Oleg-mk/MOST25-to-AUDIO/kit/1_boards/README.md

# Плати v2.0: замовлення, деталі, труба, монтаж

| Файл | Що це |
|---|---|
| `most_listener_v2-gerbers.zip` | сама плата для фабрики: Gerber-файли, свердління, файл задачі |
| `most_listener_v2-bom-jlcpcb-min.csv`, `most_listener_v2-cpl-jlcpcb-min.csv` | збірка min: перелік деталей для монтажу в JLCPCB з номерами LCSC і їхнє розміщення з поворотами JLCPCB |
| `most_listener_v2-bom-jlcpcb-mid.csv`, `most_listener_v2-cpl-jlcpcb-mid.csv` | збірка mid: те саме |
| `most_listener_v2-bom-jlcpcb-max.csv`, `most_listener_v2-cpl-jlcpcb-max.csv` | збірка max: те саме |
| `most_listener_v2-bom.csv` | повний перелік деталей (збірка max), разом із ручними |
| `most_listener_v2-schematic.pdf` | схема |
| `most_listener_v2-assembly-top.pdf`, `most_listener_v2-assembly-bottom.pdf` | обидва боки для монтажу (нижній — як його видно знизу): позначення всіх деталей, і тих, яких не видно на шовкографії, знаки полярності, контур |
| `caps/in_cap.stl`, `caps/in_cap.step` | вхідна кришка труби (J1, J5, J4, micro-USB модуля M2, SMA антени), для друку |
| `caps/out_cap.stl`, `caps/out_cap.step` | вихідна кришка (J6 і гнізда RCA J7..J9), для друку |
| `caps/caps.svg` | креслення обох кришок: вигляд ззовні, розріз, вигляд знизу, розміри, примітки |

Ці файли — копії з `listener_hw2/fab` і `listener_hw2/caps`. Їх пишуть `listener_hw2/make_fab2.py` з
плати KiCad і `listener_hw2/gen_caps.py` з моделі плати в трубі (`listener_hw2/check_fit.py`), руками
не правити.

## Плата

- 98 x 60 мм, 4 шари, FR-4 1.6 мм, ревізія 2.0. JLCPCB покаже 98.1 x 60.1 мм, бо рахує контур разом
  із товщиною лінії.
- Стек JLCPCB JLC04161H-7628: мідь 1 oz зовні й 0.5 oz усередині. Обидва внутрішні шари — суцільна
  земля.
- Доріжки від 0.2 мм, зазор 0.15 мм, переходи 0.6/0.3 мм, найменший отвір 0.3 мм, вирізів немає.
- SMD-деталі, маска й шовкографія з обох боків.
- Покриття ENIG, бо плоских площадок потребують U4 і U11 (VSSOP-8, крок 0.5 мм), U5 (WSON-6) і U6
  (HSOP-8).

## Три збірки

Плата одна і корпус один: роз'єми ставляться в кожній збірці, різняться лише деталі за ними.
Прошивки для всіх трьох ті самі.

| Збірка | Що працює | Деталей ставить JLCPCB | Рядків BOM |
|---|---|---|---|
| **min** | ядро і виходи S/PDIF: J6 (оптика) і J7 (коаксіальний) | 103 (44 зверху, 59 знизу) | 42 |
| **mid** | min і лінійний вихід J8, J9 | 143 (44 зверху, 99 знизу) | 52 |
| **max** | mid і вхід TOSLINK J5 | 163 (57 зверху, 106 знизу) | 58 |

Ядро — це живлення, кільце з обходом і сторожем, M1 (FPGA), U7 (Si514), M2 (хост, Bluetooth), J3
(I2S) і J2 (аналізатор). У min J5, J8 і J9 стоять, але не підключені: J5 без живлення, J8 і J9 без
сигналу. У mid так само не підключений J5.

## Замовлення на JLCPCB

1. **Плата.** Завантажити `most_listener_v2-gerbers.zip`. Вибрати: 4 шари, 1.6 мм, стек
   JLC04161H-7628, мідь 1 oz зовні й 0.5 oz усередині, ENIG, зелена маска, білий друк, від 5 штук.
2. **Монтаж.** Обидва боки, Standard PCBA (Economic монтує лише один бік), «Confirm parts placement»
   увімкнути.
3. **BOM і CPL.** Завантажити пару файлів потрібної збірки:
   `most_listener_v2-bom-jlcpcb-<збірка>.csv` і `most_listener_v2-cpl-jlcpcb-<збірка>.csv`.
   - JLCPCB одразу покаже наявність. Якої деталі не вистачає, ту докупити з LCSC на тій самій
     сторінці (F1, C2925010).
   - У max, якщо в LCSC бракує U13 (SRC4192), дати свої.
4. **Своя деталь: U7, Si514.** Переслати в JLCPCB або додати через їхній global sourcing.
   - Підходить будь-який варіант 3.3 В CMOS (формат C, M або N) у корпусі 3.2 x 5 (B) або
     2.5 x 3.2 (C), з будь-якою стартовою частотою й адресою I2C. FPGA сама знаходить адресу й
     ставить частоту.
   - Приклад: 514CBB000112BAG: DigiKey продає його поштучно, а JLCPCB може замовити сам (C1670489).
5. **Перегляд розміщення перед оплатою**, на обох боках. Перевірити:
   - першу ніжку кожної мікросхеми й X1;
   - полярність D1, D2, D3, C44, C45, C63, C78 і C81 (тих, що є у вибраній збірці).

   Повороти взято з посадок LCSC кожної вибраної деталі. Нижній бік JLCPCB рахує дзеркально: 180°
   мінус кут у KiCad плюс поворот самої деталі. Крапка першої ніжки має стояти на позначці першої
   ніжки плати, а «+» кожного електроліта — на боці «+» шовкографії. U7 посадки LCSC не має, JLCPCB
   малює свою: її першу ніжку звірити з позначкою на платі.

## Деталі для ручного монтажу

На одну плату:

| Позиція | Деталь | Номер | Де купити |
|---|---|---|---|
| J1 | оптичний модуль MOST (pigtail FOT, 2+0) | TE 1-1394640-1 | у каталогах Mouser і DigiKey не знайдено, лише маркетплейси: шукати заздалегідь |
| J2 | гребінка 1x08, крок 2.54 мм (TDM і UART назовні) | — | будь-де |
| J3 | гребінка 1x06, крок 2.54 мм (I2S назовні) | — | будь-де |
| J4 | Micro-Fit 3.0, 2 контакти, кутовий | Molex 43650-0200 | будь-який дистриб'ютор Molex |
| J5 | приймач TOSLINK (вхід) | Cliff FCR684208R (ORJ-8) | DigiKey, у LCSC немає |
| J6 | передавач TOSLINK (вихід S/PDIF) | Cliff FCR684208T (OTJ-8) | DigiKey |
| J7, J8, J9 | гніздо RCA, кутове: J7 коаксіальний S/PDIF, J8 і J9 лінійний вихід L і R | BKL Electronic 0101153 | дистриб'ютори BKL |
| M1 | модуль FPGA | Sipeed Tang Nano 20K | магазин Sipeed |
| M2 | модуль ESP32 з роз'ємом зовнішньої антени | Espressif ESP32-DevKitC-VIE | дистриб'ютори Espressif |
| — | гребінки для модулів: 2 шт. 1x20 (M1) і 2 шт. 1x19 (M2), крок 2.54 мм | — | будь-де |

Отвори зроблено саме під ці деталі, схожі можуть не стати.

J2 і J3 — для стола: у трубі над платою лишається 14.75 мм, а колодка 2.54 стоїть на 16.4 мм.

## Труба і кришки

- **Труба.** Алюмінієва прямокутна 80x30x2 (76 x 26 мм усередині). Довжина дорівнює виміряній
  зібраній платі від вхідного краю до найдальшого з вихідного краю й передніх граней RCA
  (номінально 98.05 мм), +0.1/−0 мм. Торці рівні й без задирок. Краще без покриття: анодування
  ізолює, а трубу з'єднуємо з землею (нижче).
- **Кришки** друкуються з `caps/`: STL для слайсера, STEP для CAD, креслення в `caps/caps.svg`.
  Матеріал PETG або ASA (PLA у машині на сонці м'якне), або замовити друк MJF PA12. Друкувати
  зовнішньою гранню на стіл, без підтримок, із заповненням 100 %: саморізи вкручуються в тіло
  блоків. Обидві разом — близько 23 г PETG.
- **Будова.** Кожна кришка — фланець 80x30, 2.0 мм, що лягає на торець труби. Плата впирається
  торцями у фланці. Блоки в бічних запасах (по 8 мм обабіч плати) тримають її краї в пазах 2.0 мм.
  До стінок труби блоки не доходять на 0.7 мм, тож підходить будь-яка труба в допуску, без вимірів.
  - Вхідна кришка: корпус J1 проходить крізь неї, J5 і J4 мають одне спільне вікно, знизу вікно на
    micro-USB модуля M2 (з місцем під литий корпус вилки), SMA антени — у бічному запасі з боку
    J4, над платою.
  - Вихідна кришка: вікно J6 і три вертикальні прорізи 13.2 x 13.8 під різьбу RCA (висоти осі
    гнізда BKL не дає, проріз покриває її розкид).
- **Сідла й вуха.** Знизу кожен фланець переходить у сідло під трубою: 3 мм завтовшки, 9 мм уздовж
  труби, з вухом по 10 мм з кожного боку й отвором Ø4.6. Труба лежить дном на двох сідлах. Слухача
  в машині кріплять чотири саморізи 4.2 мм (DIN 7981) або гвинти M4 крізь вуха, під кожну голову
  шайба DIN 125 M4.
- **Кріплення кришок:** чотири саморізи DIN 7981 C ST2.2x9.5 крізь верх труби. Отвори Ø2.4 у
  верхній стінці, 3.0 мм від торця, на відстані u від лівого краю, якщо дивитися ззовні на той
  торець:
  - вхідна: u 6.20 (лівий блок) і u 64.90 (блок землі, над J4);
  - вихідна: u 6.20 (лівий блок) і u 73.80 (правий блок).

  Не крізь бічні стінки: голова саморіза там заважала б викрутці на вусі під нею.
- **Земля труби.** Під голову саморіза блоку землі (вхідна кришка, над J4) покласти кільцевий
  наконечник M2 і зубчасту шайбу. Від наконечника провід 3–5 см до мінусового проводу джгута J4 біля
  самої колодки (пайка, термоусадка). Анодовану трубу під шайбою зачистити до металу.
- **Антена.** Пігтейл U.FL–SMA 150 мм з гніздом SMA під гайку 8 мм (фланцеве чи з ущільнювачем,
  11 мм, у бічний запас не влазить). Отвір у кришці круглий, Ø6.85, тож підходить різьба і з
  лисками, і без. Гайка й зубчаста шайба гнізда — зовні. Антену 2.4 ГГц брати з тим самим різновидом
  роз'єму, що й гніздо пігтейла: SMA або RP-SMA.

## Що ще потрібно, крім плати

- **Живлення J4.** Корпус Molex 43645-0200 і два контакти 43030 (провід 20–24 AWG).
  - Живити від постійного «плюса» акумулятора (KL30) і маси.
  - Без живлення обхід не працює, і кільце машини розірване: на 3.3 В, що є завжди, працює саме
    шлях оптики через плату.
  - Біля точки підключення до проводки машини поставити свій запобіжник. F1 на платі (2 А)
    захищає лише те, що за ним, а не провід.
- **Вставка в кільце MOST.** Кабель, що розриває кільце біля одного з вузлів і заводить його на J1.
  Номера в репозиторії немає. Такі кабелі роблять Kufatec, Dension, Trioma; підбирати під свій
  вузол. Для телефона в машину цей вузол — підсилювач: слухач має стояти на волокні, що йде в
  нього.
- **Антена для M2** з пігтейлом, за розділом вище. У модуля VIE антени на платі немає, без
  зовнішньої не буде Bluetooth.
- **Труба, кришки й дрібниці** за розділом вище: чотири саморізи ST2.2x9.5, кільцевий наконечник
  M2, зубчаста шайба M2, 3–5 см проводу 20–22 AWG; для машини — чотири саморізи 4.2 мм або гвинти
  M4 і шайби M4.
- **Кабелі за потребою:**
  - TOSLINK на J5 (вхід) і J6 (вихід);
  - коаксіальний 75 Ом на J7;
  - звичайні RCA на J8 і J9.
- **Для стола** потрібне світло в J1: живе кільце машини або інша плата MOST. Інакше сигнал WAKE не
  вмикає 5V_SW, і модулі не мають живлення від плати.

## Монтаж

1. **Прошивки.** Перед запаюванням записати прошивки в обидва модулі, кожен через його власний
   USB, без плати (`2_flash/README.md`). USB-C модуля FPGA потім закриють корпуси J8 і J9.
2. **Гребінки модулів.** На платі є отвори лише під ніжки, що працюють, і під кутові, що тримають
   модуль. Тож гребінку прикласти до її ряду отворів і витягнути плоскогубцями ті штирі, під якими
   отвору немає. За номерами ніжок модуля, від квадратної площадки 1:
   - M1: 4, 6, 7, 11, 15, 16, 17, 18 в одному ряду; 24, 29, 34, 36 в іншому;
   - M2: 2–10, 12, 13, 16, 17, 18 в одному ряду; 23, 24, 27–31, 33, 34, 36, 37 в іншому.
3. **Порядок.**
   1. J1..J9 у будь-якому порядку. Тонкі виводи RCA (J7..J9) знизу обрізати до 2 мм.
   2. M1: гребінки вставити в плату, модуль зверху, спершу паяти модуль, потім плату знизу. Виводи
      M1 знизу зрізати врівень із платою, пайку лишити: над ними ляже M2.
   3. Виводи й фіксатори J4 і J5 знизу обрізати до 1 мм: над ними теж ляже M2.
   4. M2: так само на гребінках, компонентами донизу, від плати. Без панельок.
4. **Орієнтація.** Двічі перевірити до пайки: розвернутий на 180° модуль отримає живлення не на ті
   ніжки. Нижче все так, як на кресленні верхнього боку: вхідний край (J1, J5, J4) ліворуч,
   вихідний (J6..J9) праворуч.
   - **M1 (Tang Nano 20K), зверху:** USB-C до вихідного краю, кінець з HDMI до вхідного, квадратна
     площадка 1 праворуч угорі.
   - **M2 (ESP32-DevKitC-VIE), знизу, компонентами донизу:** micro-USB до вхідного краю (він виходить
     у вікно вхідної кришки), кінець з антеною (WROVER-IE) до середини плати. Квадратна площадка 1,
     якщо дивитися зверху, праворуч унизу.
   - **J1:** оптична грань за вхідним краєм, площадка 1 (TX) прямокутна, верхня.
   - **J5 і J4:** на вхідному краї під J1, J4 нижче. У J4 нижня площадка, із заокругленими кутами,
     — контакт 1 (VBAT, через F1), верхня — контакт 2 (GND). На шовкографії полярність не позначено.
   - **J6, J7, J9, J8:** згори вниз на вихідному краї: вихід TOSLINK, S/PDIF коаксіальний, лінійний
     R, лінійний L.
5. **Невидимі позначення.** Дрібні позначення, що не вмістилися на шовкографію, є на кресленнях
   монтажу.

## Перед першим живленням

- Оглянути все за списком із кроку 5 замовлення.
- Омметром перевірити, що немає короткого: J4 між 1 і 2, TP6 (3V3_AON) до TP9 (GND), TP7 (5V_SW)
  до TP9. Ці три площадки стоять у ряд над M1, зліва направо TP6, TP9, TP7.

## Перше живлення

На столі, поза трубою.

1. J4 від лабораторного джерела 12 В з обмеженням струму: перевернута полярність пропалить F1.
2. TP6 має показати 3.3 В (U5, є завжди). Без світла в J1 сигнал WAKE дорівнює 0 і U6 вимкнено,
   тож TP7 = 0 В і модулі без живлення. Так і має бути.
3. Зі світлом у J1 TP7 показує близько 5.3 В. FPGA читає прошивку зі свого флешу приблизно за
   290 мс, ESP32 стартує зі свого. З ноутбуком на USB модуля M2 консоль показує старт хоста
   (`3_laptop/README.md`).

## Складання в трубу

1. Відрізати трубу за виміряною зібраною платою й просвердлити чотири отвори Ø2.4 (розділ «Труба і
   кришки»).
2. **Антена.** Вдягти U.FL пігтейла на WROVER-IE модуля M2, на кінці модуля з антеною. Кабель
   вести повз цей кінець, а не через екран модуля: під платою до краю з J2, J3 і J8, уздовж нього до
   вхідного краю й довкола краю вгору до місця SMA, далі ніж 8 мм від вхідного краю, повз блоки
   кришки. Кабель і його запас пласкою петлею приклеїти скотчем до низу плати, щоб нічого не
   звисало нижче M2. SMA вставити у вхідну кришку зсередини, зубчасту шайбу й гайку — зовні.
3. Надіти вхідну кришку на вхідний край плати поза трубою: корпус J1 у свій виріз, краї плати в
   пази.
4. Покласти трубу верхом донизу, а плату — стороною M2 догори. Всунути плату в трубу з вхідного
   торця, вихідним краєм уперед, кришкою позаду, поки фланець не сяде на торець. Вільний кінець
   плати може опуститися лише на корпуси RCA, а M2 і кабель нічого не торкаються.
5. Вихідну кришку надіти, не перевертаючи трубу: тримати кінець плати на висоті пазів за різьби
   RCA, що стирчать із труби, надіти кришку пазами й дотиснути: J6 у свій виріз, краї плати в пази.
   Тепер трубу перевернути.
6. Вирівняти кожен фланець із контуром труби, крізь отвори труби свердлити в блоки Ø1.6 приблизно
   на 8 мм углиб і закрутити чотири саморізи, поки голова не сяде. Під саморіз блоку землі —
   кільцевий наконечник і зубчасту шайбу.
7. Провід від наконечника припаяти до мінусового проводу джгута J4 біля колодки й закрити
   термоусадкою. Омметром: між трубою і контактом 2 J4 — нуль.
8. Коли пігтейл уже вдягнено, ніколи не класти плату на M2: кінець M2 з кнопками EN/BOOT лежить на
   1.25 мм нижче пазів, а під кінцем WROVER-IE кабелю лишається 0.88 мм.

## У машині

Дном труби донизу на двох сідлах, чотири гвинти крізь вуха. Спершу лише прослуховування: слухач у
кільці, з живленням, а машина звучить як раніше. Далі запис (`3_laptop`), потім регенерація, і лише
потім підмішування (README репозиторію, «Bring-up, in this order»).
