Oleg-mk/MOST25-to-AUDIO/kit/1_boards/most_listener_v2-bom-jlcpcb-max.csv

Comment | Designator | Footprint | LCSC Part # | Manufacturer Part
10u 100V | C1 | C_1210_3225Metric | C576517 | Murata GRM32EC72A106KE05L, X7S
100n 100V | C2,C43,C46,C47,C82,C83 | C_0603_1608Metric | C15725 | Samsung CL10B104KC8NNNC, X7R
2u2 | C3,C53,C57,C58 | C_0603_1608Metric | C23630 | Samsung CL10A225KO8NNNC, 16 V X5R
4u7 100V | C4 | C_1210_3225Metric | C385986 | Taiyo Yuden HMK325C7475KMHPE, X7S
100n | C6,C8,C10,C11,C12,C13,C16,C17,C19,C26,C29,C30,C31,C32,C34,C36,C38,C39,C52,C54,C56,C59,C64,C65,C66,C67,C68,C76,C77,C79,C80 | C_0603_1608Metric | C14663 | Yageo CC0603KRX7R9BB104, 50 V X7R
47u 10V | C7 | C_1210_3225Metric | C77101 | Murata GRM32ER61C476KE15L, 16 V X5R
1u | C9,C14,C15,C40,C48,C49,C50,C51,C73,C74 | C_0603_1608Metric | C15849 | Samsung CL10A105KB8NNNC, 50 V X5R
10u | C18,C20,C33,C35,C37,C60,C84,C85 | C_0805_2012Metric | C15850 | Samsung CL21A106KAYNNNE, 25 V X5R
10u 16V | C23 | C_0805_2012Metric | C15850 | Samsung CL21A106KAYNNNE, 25 V X5R
10u 6V3 | C24 | C_0805_2012Metric | C15850 | Samsung CL21A106KAYNNNE, 25 V X5R
1n | C25 | C_0603_1608Metric | C1588 | Samsung CL10B102KB8NNNC, 50 V X7R
68n | C27 | C_0603_1608Metric | C107098 | Yageo CC0603KRX7R9BB683, 50 V X7R
4n7 | C28 | C_0603_1608Metric | C53987 | FH 0603B472K500NT, 50 V X7R
100u 63V | C44,C45 | CP_Elec_10x10.5 | C53330124 | SamYoung CLZ 63V 100uF 10x10, 125 C
4u7 | C55,C75 | C_0805_2012Metric | C1779 | Samsung CL21A475KAQNNNE, 25 V X5R
2n2 | C61,C62 | C_0603_1608Metric | C2991172 | FH 0603CG222J500NT, C0G
100u 16V | C63,C78,C81 | CP_Elec_6.3x7.7 | C359220 | SamYoung BLA 16V 100uF 6.3x6
820p | C69,C70 | C_0603_1608Metric | C99081 | FH 0603CG821J500NT, C0G
390p | C71,C72 | C_0603_1608Metric | C1667 | FH 0603CG391J500NT, C0G
SS34 | D1,D3 | D_SMA | C8678 | MDD SS34
SMBJ36A | D2 | D_SMB | C135070 | Diodes SMBJ36A-13-F
PESD5V0S1BL | D4,D5,D6 | D_SOD-882 | C84374 | Nexperia PESD5V0S1BL,315
2A T | F1 | Fuse_1206_3216Metric | C2925010 | TLC F12T2, slow blow, 72 V
600R | FB1,FB2,FB3 | L_0603_1608Metric | C1002 | Sunlord GZ1608D601TF
15u | L1 | L_Bourns_SRN6045TA | C1330797 | Bourns SRN6045TA-150M
22u | L2 | L_Bourns-SRN8040_8x8.15mm | C2041547 | Bourns SRN8040-220M
150 | R1,R2 | R_0603_1608Metric | C22808 | UNI-ROYAL 0603WAF1500T5E
27k | R3,R42 | R_0603_1608Metric | C22967 | UNI-ROYAL 0603WAF2702T5E
100k | R4,R6,R7 | R_0603_1608Metric | C25803 | UNI-ROYAL 0603WAF1003T5E
23k2 | R5 | R_0603_1608Metric | C23346 | UNI-ROYAL 0603WAF2322T5E
10k | R8,R9,R14,R17,R23,R30 | R_0603_1608Metric | C25804 | UNI-ROYAL 0603WAF1002T5E
22 | R10,R15 | R_0603_1608Metric | C23345 | UNI-ROYAL 0603WAF220JT5E
2k | R11,R12 | R_0603_1608Metric | C22975 | UNI-ROYAL 0603WAF2001T5E
33 | R16,R18,R19,R20,R21,R28,R29,R34,R35,R36,R37,R38,R39,R40,R41,R49,R50,R51,R52,R53 | R_0603_1608Metric | C23140 | UNI-ROYAL 0603WAF330JT5E
24k9 1% | R22 | R_0603_1608Metric | C25962 | UNI-ROYAL 0603WAF2492T5E
680 | R24 | R_0603_1608Metric | C23228 | UNI-ROYAL 0603WAF6800T5E
100 | R25,R45,R46 | R_0603_1608Metric | C22775 | UNI-ROYAL 0603WAF1000T5E
240 | R26 | R_0603_1608Metric | C23350 | UNI-ROYAL 0603WAF2400T5E
110 | R27 | R_0603_1608Metric | C22781 | UNI-ROYAL 0603WAF1100T5E
64k9 1% | R31 | R_0603_1608Metric | C14891 | UNI-ROYAL 0603WAF6492T5E
4k7 | R32,R33,R43,R44 | R_0603_1608Metric | C23162 | UNI-ROYAL 0603WAF4701T5E
10 | R47,R48 | R_0603_1608Metric | C22859 | UNI-ROYAL 0603WAF100JT5E
74LVC1G34 | U1 | SOT-353_SC-70-5 | C353880 | TI SN74LVC1G34DCKR
74LVC1G157 | U2 | SOT-363_SC-70-6 | C135822 | Nexperia 74LVC1G157GW,125
74LVC1G125 | U3 | SOT-353_SC-70-5 | C7833 | TI SN74LVC1G125DCKR
74LVC1G123 | U4,U11 | VSSOP-8_2.3x2mm_P0.5mm | C352969 | TI SN74LVC1G123DCUR
TPS7B8133DRV | U5 | WSON-6-1EP_2x2mm_P0.65mm_EP1x1.6mm | C2876250 | TI TPS7B8133DRVR
LMR38020F | U6 | Texas_HSOP-8-1EP_3.9x4.9mm_P1.27mm_ThermalVias | C5149193 | TI LMR38020FDDAR
Si514 | U7 | Si514_3.2x5_2.5x3.2 |  | Skyworks Si514, consigned (see the README)
LP5907MFX-3.3 | U8,U14,U16 | SOT-23-5 | C130005 | TI LP5907QMFX-3.3Q1
74LVC1G79 | U9 | SOT-353_SC-70-5 | C2677837 | TI SN74LVC1G79DCKR
TPS2553DBVR | U10 | SOT-23-6 | C55266 | TI TPS2553DBVR
DIR9001 | U12 | TSSOP-28_4.4x9.7mm_P0.65mm | C96215 | TI DIR9001PWR
SRC4192 | U13 | SSOP-28_5.3x10.2mm_P0.65mm | C2662561 | TI SRC4192IDBR
PCM5102A | U15 | TSSOP-20_4.4x6.5mm_P0.65mm | C107671 | TI PCM5102APWR
OPA1678 | U17 | SOIC-8_3.9x4.9mm_P1.27mm | C192421 | TI OPA1678IDR
TPS60403 | U18 | SOT-23-5 | C11338 | TI TPS60403DBVR
24.576MHz | X1 | Oscillator_SMD_Abracon_ASE-4Pin_3.2x2.5mm | C2831388 | YXC OT322524.576MJBA4SL, 3.3 V CMOS
