Oleg-mk/MOST25-to-AUDIO/kit/1_boards/most_listener_v2-bom.csv

Refs | Value | Footprint | Qty
C1 | 10u 100V | Capacitor_SMD:C_1210_3225Metric | 1
C2,C43,C46,C47,C82,C83 | 100n 100V | Capacitor_SMD:C_0603_1608Metric | 6
C3,C53,C57,C58 | 2u2 | Capacitor_SMD:C_0603_1608Metric | 4
C4 | 4u7 100V | Capacitor_SMD:C_1210_3225Metric | 1
C6,C8,C10,C11,C12,C13,C16,C17,C19,C26,C29,C30,C31,C32,C34,C36,C38,C39,C52,C54,C56,C59,C64,C65,C66,C67,C68,C76,C77,C79,C80 | 100n | Capacitor_SMD:C_0603_1608Metric | 31
C7 | 47u 10V | Capacitor_SMD:C_1210_3225Metric | 1
C9,C14,C15,C40,C48,C49,C50,C51,C73,C74 | 1u | Capacitor_SMD:C_0603_1608Metric | 10
C18,C20,C33,C35,C37,C60,C84,C85 | 10u | Capacitor_SMD:C_0805_2012Metric | 8
C23 | 10u 16V | Capacitor_SMD:C_0805_2012Metric | 1
C24 | 10u 6V3 | Capacitor_SMD:C_0805_2012Metric | 1
C25 | 1n | Capacitor_SMD:C_0603_1608Metric | 1
C27 | 68n | Capacitor_SMD:C_0603_1608Metric | 1
C28 | 4n7 | Capacitor_SMD:C_0603_1608Metric | 1
C44,C45 | 100u 63V | Capacitor_SMD:CP_Elec_10x10.5 | 2
C55,C75 | 4u7 | Capacitor_SMD:C_0805_2012Metric | 2
C61,C62 | 2n2 | Capacitor_SMD:C_0603_1608Metric | 2
C63,C78,C81 | 100u 16V | Capacitor_SMD:CP_Elec_6.3x7.7 | 3
C69,C70 | 820p | Capacitor_SMD:C_0603_1608Metric | 2
C71,C72 | 390p | Capacitor_SMD:C_0603_1608Metric | 2
D1,D3 | SS34 | Diode_SMD:D_SMA | 2
D2 | SMBJ36A | Diode_SMD:D_SMB | 1
D4,D5,D6 | PESD5V0S1BL | Diode_SMD:D_SOD-882 | 3
F1 | 2A T | Fuse:Fuse_1206_3216Metric | 1
FB1,FB2,FB3 | 600R | Inductor_SMD:L_0603_1608Metric | 3
J1 | 1-1394640-1 | most_listener:TE_MOST_Pigtail_FOT_2+0 | 1
J2 | ANALYSER | Connector_PinHeader_2.54mm:PinHeader_1x08_P2.54mm_Vertical | 1
J3 | I2S | Connector_PinHeader_2.54mm:PinHeader_1x06_P2.54mm_Vertical | 1
J4 | VBAT_IN | Connector_Molex:Molex_Micro-Fit_3.0_43650-0200_1x02_P3.00mm_Horizontal | 1
J5 | FCR684208R | most_listener:Cliff_TOSLINK_ORJ8_OTJ8 | 1
J6 | FCR684208T | most_listener:Cliff_TOSLINK_ORJ8_OTJ8 | 1
J7 | RCA 75R | most_listener:BKL_0101153_RCA_RA | 1
J8 | LINE L | most_listener:BKL_0101153_RCA_RA | 1
J9 | LINE R | most_listener:BKL_0101153_RCA_RA | 1
L1 | 15u | Inductor_SMD:L_Bourns_SRN6045TA | 1
L2 | 22u | Inductor_SMD:L_Bourns-SRN8040_8x8.15mm | 1
M1 | Tang Nano 20K | most_listener:Sipeed_TangNano20K | 1
M2 | ESP32-DevKitC-VIE | most_listener:Espressif_ESP32-DevKitC_V4 | 1
R1,R2 | 150 | Resistor_SMD:R_0603_1608Metric | 2
R3,R42 | 27k | Resistor_SMD:R_0603_1608Metric | 2
R4,R6,R7 | 100k | Resistor_SMD:R_0603_1608Metric | 3
R5 | 23k2 | Resistor_SMD:R_0603_1608Metric | 1
R8,R9,R14,R17,R23,R30 | 10k | Resistor_SMD:R_0603_1608Metric | 6
R10,R15 | 22 | Resistor_SMD:R_0603_1608Metric | 2
R11,R12 | 2k | Resistor_SMD:R_0603_1608Metric | 2
R16,R18,R19,R20,R21,R28,R29,R34,R35,R36,R37,R38,R39,R40,R41,R49,R50,R51,R52,R53 | 33 | Resistor_SMD:R_0603_1608Metric | 20
R22 | 24k9 1% | Resistor_SMD:R_0603_1608Metric | 1
R24 | 680 | Resistor_SMD:R_0603_1608Metric | 1
R25,R45,R46 | 100 | Resistor_SMD:R_0603_1608Metric | 3
R26 | 240 | Resistor_SMD:R_0603_1608Metric | 1
R27 | 110 | Resistor_SMD:R_0603_1608Metric | 1
R31 | 64k9 1% | Resistor_SMD:R_0603_1608Metric | 1
R32,R33,R43,R44 | 4k7 | Resistor_SMD:R_0603_1608Metric | 4
R47,R48 | 10 | Resistor_SMD:R_0603_1608Metric | 2
U1 | 74LVC1G34 | Package_TO_SOT_SMD:SOT-353_SC-70-5 | 1
U2 | 74LVC1G157 | Package_TO_SOT_SMD:SOT-363_SC-70-6 | 1
U3 | 74LVC1G125 | Package_TO_SOT_SMD:SOT-353_SC-70-5 | 1
U4,U11 | 74LVC1G123 | Package_SO:VSSOP-8_2.3x2mm_P0.5mm | 2
U5 | TPS7B8133DRV | Package_SON:WSON-6-1EP_2x2mm_P0.65mm_EP1x1.6mm | 1
U6 | LMR38020F | Package_SO:Texas_HSOP-8-1EP_3.9x4.9mm_P1.27mm_ThermalVias | 1
U7 | Si514 | most_listener:Si514_3.2x5_2.5x3.2 | 1
U8,U14,U16 | LP5907MFX-3.3 | Package_TO_SOT_SMD:SOT-23-5 | 3
U9 | 74LVC1G79 | Package_TO_SOT_SMD:SOT-353_SC-70-5 | 1
U10 | TPS2553DBVR | Package_TO_SOT_SMD:SOT-23-6 | 1
U12 | DIR9001 | Package_SO:TSSOP-28_4.4x9.7mm_P0.65mm | 1
U13 | SRC4192 | Package_SO:SSOP-28_5.3x10.2mm_P0.65mm | 1
U15 | PCM5102A | Package_SO:TSSOP-20_4.4x6.5mm_P0.65mm | 1
U17 | OPA1678 | Package_SO:SOIC-8_3.9x4.9mm_P1.27mm | 1
U18 | TPS60403 | Package_TO_SOT_SMD:SOT-23-5 | 1
X1 | 24.576MHz | Oscillator:Oscillator_SMD_Abracon_ASE-4Pin_3.2x2.5mm | 1
