Oleg-mk/MOST25-to-AUDIO/kit/1_boards/caps/in_cap.step

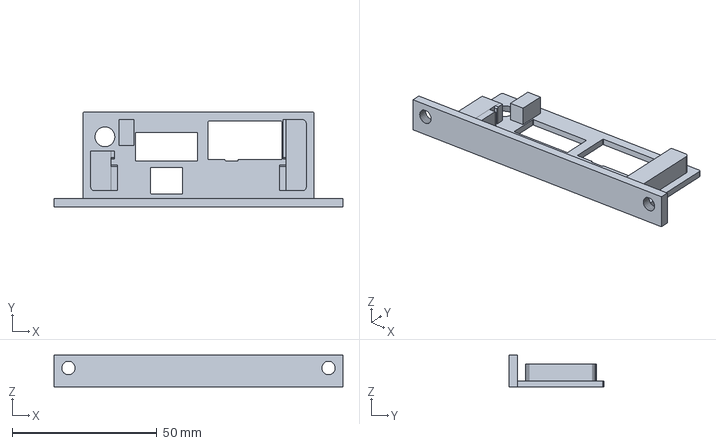
[picture p6: CAD file, 2026-10-11]
kit/1_boards/caps/in_cap.step
100.0 x 33.0 x 11.0 mm
