Oleg-mk/MOST25-to-AUDIO/(list of files, cad)

Other CAD files:
kit/1_boards/caps/in_cap.stl
kit/1_boards/caps/out_cap.stl
