Oleg-mk/MOST25-to-AUDIO/kit/2_flash/fpga/BUILD.txt

listener.fs: the listener's FPGA bitstream, for the Tang Nano 20K's flash (../README.md)
device     GW2AR-LV18QN88C8/I7
commit     86f064ebe352ab699e18e4e82d51c449b74bf42f
usercode   0x0000FC3C  (over JTAG: Gowin Programmer, Read User Code)
loading    25.000MHz from the flash
built      2026-10-11 18:24
sha256     55321f40476e4cde6251869ea74394f5b4f5ea72e143f03662a515045d560935
timing     ok    clk_1024   needs   50.000 MHz, reaches   68.944 MHz, margin   37.9 % (min 10 %)
           ok    clk_s      needs   99.000 MHz, reaches  124.856 MHz, margin   26.1 % (min 10 %)
           TIMING: PASS
