Oleg-mk/MOST25-to-AUDIO/kit/1_boards/most_listener_v2-schematic.pdf

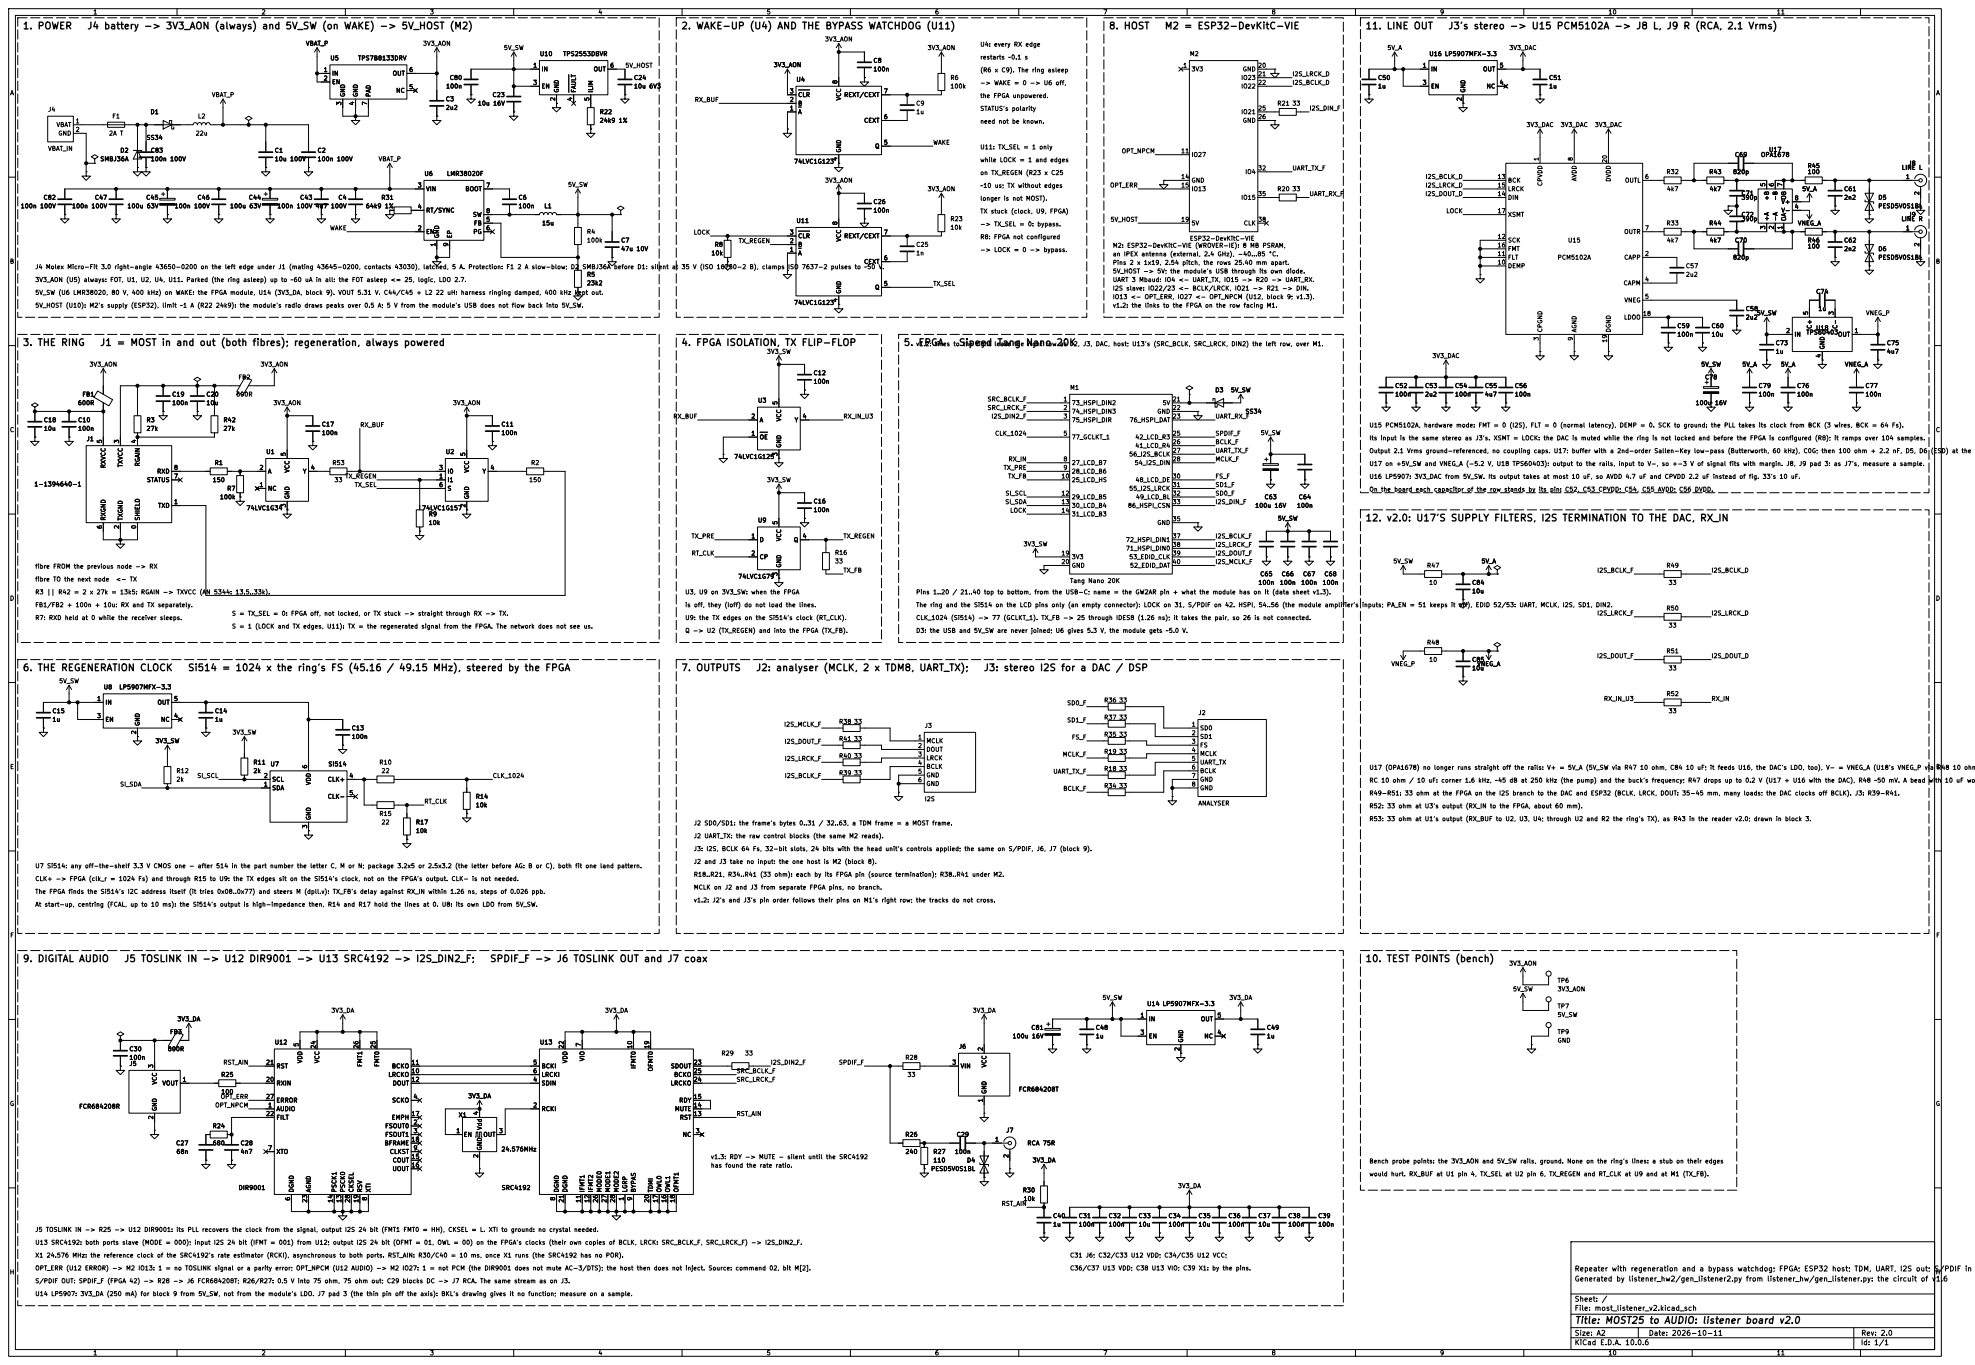
[picture p7: page 1]

longer is not MOST). ~10 us; TX without edges on TX_REGEN (R23 x C25 while LOCK = 1 and edges U11: TX_SEL = 1 only need not be known. STATUS's polarity -> WAKE = 0 -> U6 off,

-> TX_SEL = 0: bypass. TX stuck (clock, U9, FPGA)

M2: ESP32-DevKitC-VIE (WROVER-IE): 8 MB PSRAM, UART 3 Mbaud: IO4 <- UART_TX, IO15 -> R20 -> UART_RX. 5V_HOST -> 5V; the module's USB through its own diode.
I2S slave: IO22/23 <- BCLK/LRCK, IO21 -> R21 -> DIN. an IPEX antenna (external, 2.4 GHz), -40...85 °C.

Pins 2 x 1x19, 2.54 pitch, the rows 25.40 mm apart. 5V_HOST (U10): M2's supply (ESP32), limit ~1 A (R22 24k9): the module's radio draws peaks over 0.5 A; 5 V from the module's USB does not flow back into 5V_SW.

3V3_AON (U5) always: FOT, U1, U2, U4, U11. Parked (the ring asleep) up to ~60 uA in all: the FOT asleep <= 25, logic, LDO 2.7.

IO13 <- OPT_ERR, IO27 <- OPT_NPCM (U12, block 9; v1.3).
v1.2: the links to the FPGA on the row facing M1.

is off, they (Ioff) do not load the lines. U3, U9 on 3V3_SW: when the FPGA 4. FPGA ISOLATION, TX FLIP-FLOP

Its input is the same stereo as J3's. XSMT = LOCK: the DAC is muted while the ring is not locked and before the FPGA is configured (R8); it ramps over 104 samples.

U16 LP5907: 3V3_DAC from 5V_SW. Its output takes at most 10 uF, so AVDD 4.7 uF and CPVDD 2.2 uF instead of fig. 33's 10 uF.

On the board each capacitor of the row stands by its pin: C52, C53 CPVDD; C54, C55 AVDD; C56 DVDD. U17 (OPA1678) no longer runs straight off the rails: V+ = 5V_A (5V_SW via R47 10 ohm, C84 10 uF; it feeds U16, the DAC's LDO, too), V- = VNEG_A (U18's VNEG_P via R48 10 ohm, C85 10 uF).

12. v2.0: U17'S SUPPLY FILTERS, I2S TERMINATION TO THE DAC, RX_IN

fibre FROM the previous node -> RX

fibre TO the next node <- TX

Q -> U2 (TX_REGEN) and into the FPGA (TX_FB). U9: the TX edges on the Si514's clock (RT_CLK).

R49-R51: 33 ohm at the FPGA on the I2S branch to the DAC and ESP32 (BCLK, LRCK, DOUT: 35-45 mm, many loads; the DAC clocks off BCLK). J3: R39-R41.

R53: 33 ohm at U1's output (RX_BUF to U2, U3, U4; through U2 and R2 the ring's TX), as R43 in the reader v2.0; drawn in block 3.

J2 SD0/SD1: the frame's bytes 0..31 / 32..63, a TDM frame = a MOST frame.

J2 UART_TX: the raw control blocks (the same M2 reads).

MCLK on J2 and J3 from separate FPGA pins, no branch. J2 and J3 take no input: the one host is M2 (block 8).

R18..R21, R34..R41 (33 ohm): each by its FPGA pin (source termination); R38..R41 under M2.

The FPGA finds the Si514's I2C address itself (it tries 0x08..0x77) and steers M (dpll.v): TX_FB's delay against RX_IN within 1.26 ns, steps of 0.026 ppb. At start-up, centring (FCAL, up to 10 ms): the Si514's output is high-impedance then, R14 and R17 hold the lines at 0. U8: its own LDO from 5V_SW.

v1.2: J2's and J3's pin order follows their pins on M1's right row; the tracks do not cross.

9 IFMT0 10 IFMT1 11 IFMT2 12 RST 13 MUTE 14 RDY 15 OWL1 16 OWL0 17 OFMT1 18 OFMT0 19 TDMI 20 DGND 21 VDD 22

EMPH 17 BFRAME 18 RSV 19 RXIN 20 RST 21

would hurt. RX_BUF at U1 pin 4, TX_SEL at U2 pin 6, TX_REGEN and RT_CLK at U9 and at M1 (TX_FB). Bench probe points: the 3V3_AON and 5V_SW rails, ground. None on the ring's lines: a stub on their edges U14 LP5907: 3V3_DA (250 mA) for block 9 from 5V_SW, not from the module's LDO. J7 pad 3 (the thin pin off the axis): BKL's drawing gives it no function; measure on a sample.

v1.3: RDY -> MUTE - silent until the SRC4192
has found the rate ratio.

J5 TOSLINK IN -> R25 -> U12 DIR9001: its PLL recovers the clock from the signal, output I2S 24 bit (FMT1 FMT0 = HH), CKSEL = L. XTI to ground: no crystal needed.

U13 SRC4192: both ports slave (MODE = 000); input I2S 24 bit (IFMT = 001) from U12; output I2S 24 bit (OFMT = 01, OWL = 00) on the FPGA's clocks (their own copies of BCLK, LRCK: SRC_BCLK_F, SRC_LRCK_F) -> I2S_DIN2_F.

S/PDIF OUT: SPDIF_F (FPGA 42) -> R28 -> J6 FCR684208T; R26/R27: 0.5 V into 75 ohm, 75 ohm out; C29 blocks DC -> J7 RCA. The same stream as on J3. OPT_ERR (U12 ERROR) -> M2 IO13: 1 = no TOSLINK signal or a parity error; OPT_NPCM (U12 AUDIO) -> M2 IO27: 1 = not PCM (the DIR9001 does not mute AC-3/DTS); the host then does not inject. Source: command 02, bit M[2]. X1 24.576 MHz: the reference clock of the SRC4192's rate estimator (RCKI), asynchronous to both ports. RST_AIN: R30/C40 = 10 ms, once X1 runs (the SRC4192 has no POR).

C36/C37 U13 VDD; C38 U13 VIO; C39 X1: by the pins.

Generated by listener_hw2/gen_listener2.py from listener_hw/gen_listener.py: the circuit of v1.6

Sheet: /
File: most_listener_v2.kicad_sch
Title: MOST25 to AUDIO: listener board v2.0

Size: A2 | Rev: 2.0
KiCad E.D.A. 10.0.6 | Id: 1/1
