Oleg-mk/MOST25-to-AUDIO/listener_hw/fab/most_listener-schematic.pdf

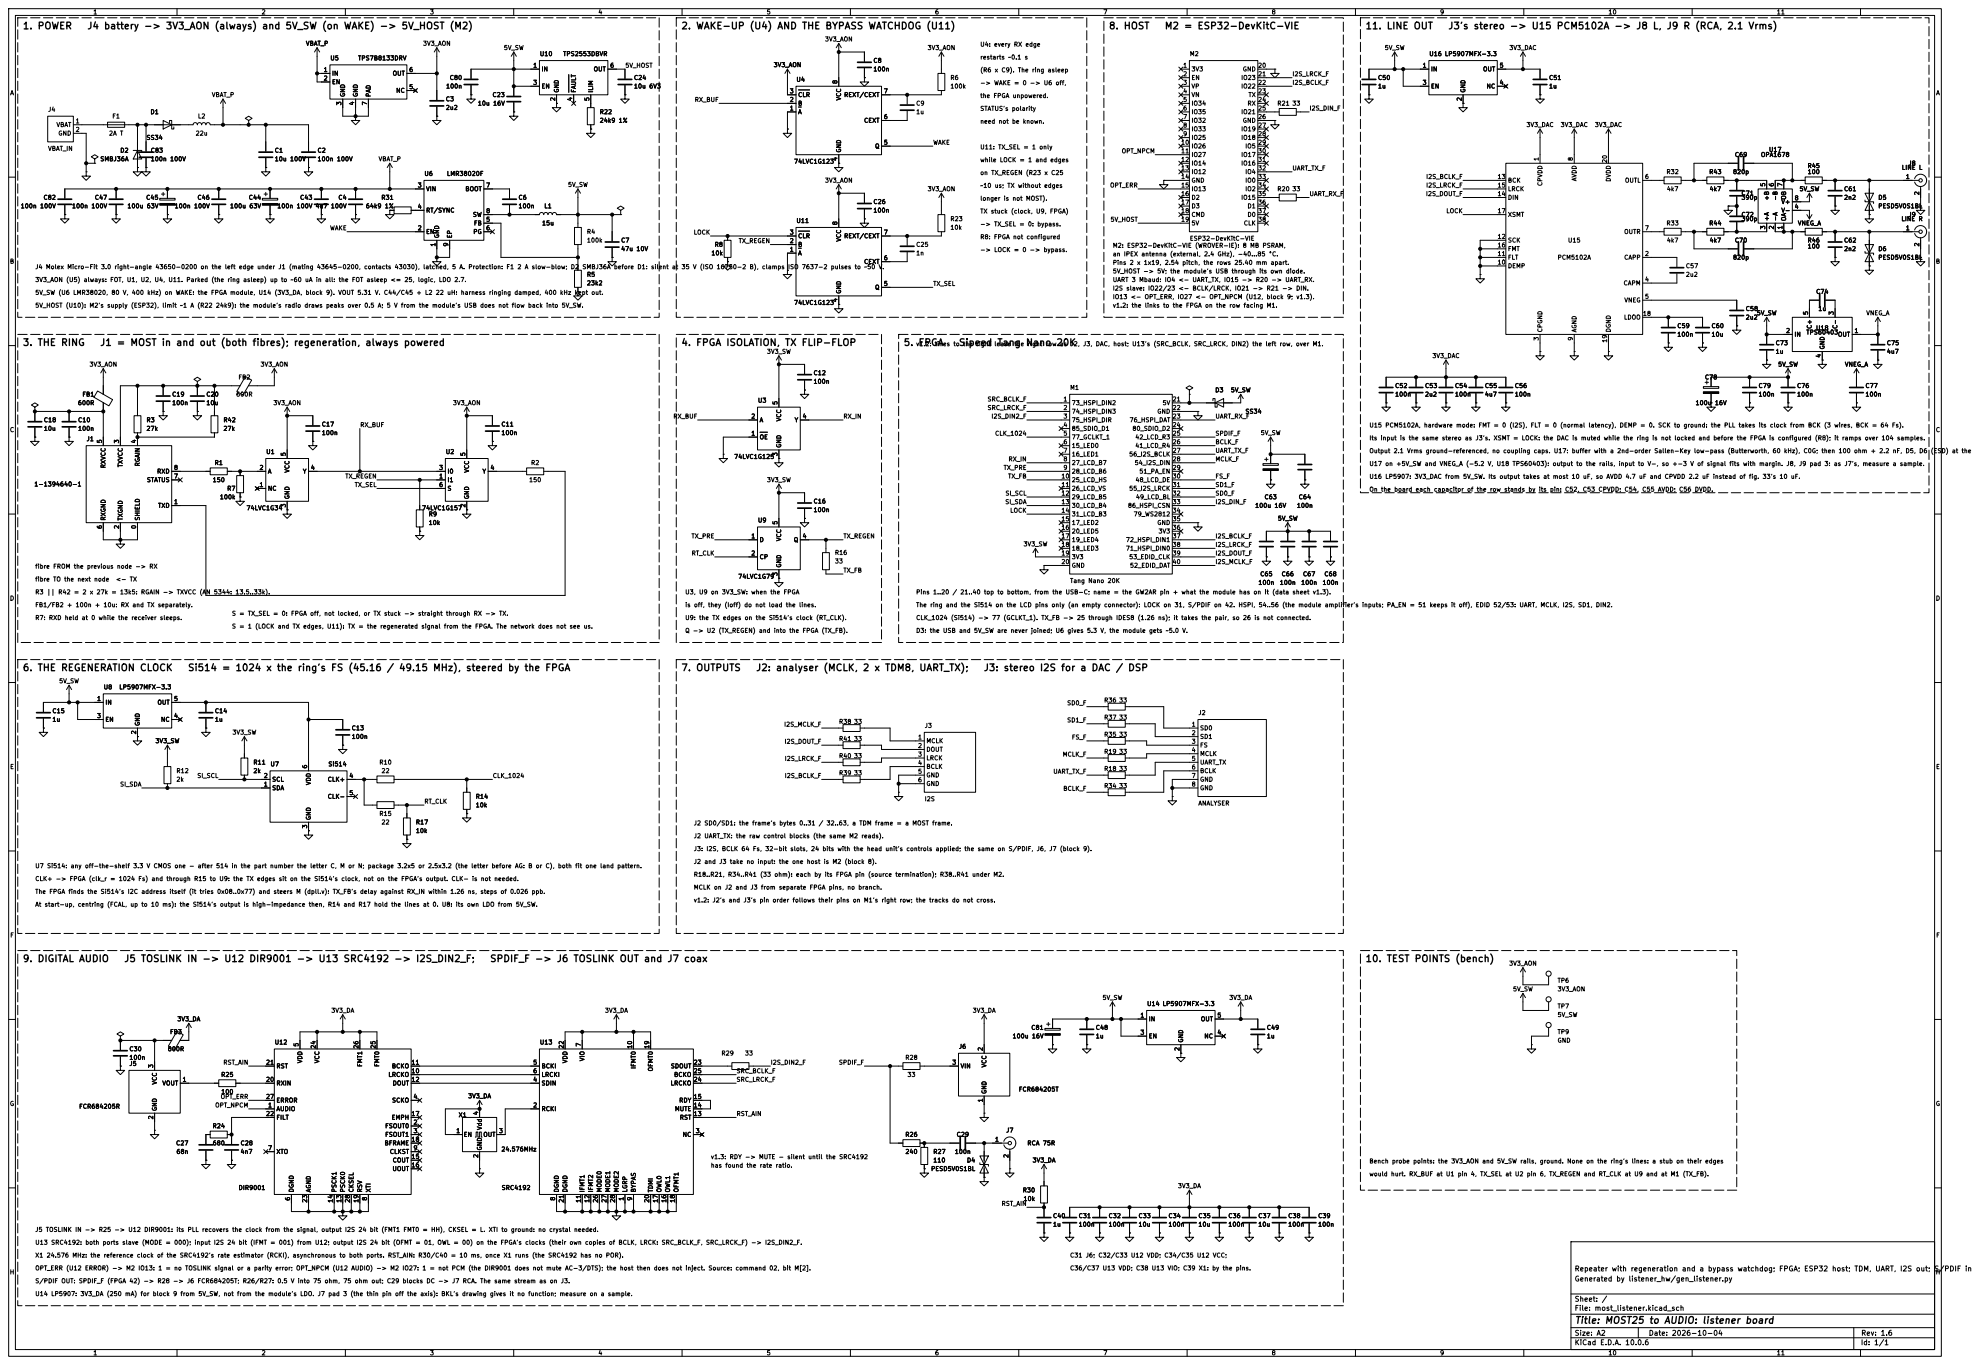
[picture p8: page 1]

2. WAKE-UP (U4) AND THE BYPASS WATCHDOG (U11)

the FPGA unpowered. -> WAKE = 0 -> U6 off,

U11: TX_SEL = 1 only need not be known. STATUS's polarity

while LOCK = 1 and edges

longer is not MOST). ~10 us; TX without edges

TX stuck (clock, U9, FPGA)

-> LOCK = 0 -> bypass. R8: FPGA not configured

v1.2: the links to the FPGA on the row facing M1. Pins 2 x 1x19, 2.54 pitch, the rows 25.40 mm apart. M2: ESP32-DevKitC-VIE (WROVER-IE): 8 MB PSRAM,

an IPEX antenna (external, 2.4 GHz), -40...85 °C. Q -> U2 (TX_REGEN) and into the FPGA (TX_FB).

I2S slave: IO22/23 <- BCLK/LRCK, IO21 -> R21 -> DIN. UART 3 Mbaud: IO4 <- UART_TX, IO15 -> R20 -> UART_RX.

5V_SW (U6 LMR38020, 80 V, 400 kHz) on WAKE: the FPGA module, U14 (3V3_DA, block 9). VOUT 5.31 V. C44/C45 + L2 22 uH: harness ringing damped, 400 kHz kept out. 5V_HOST (U10): M2's supply (ESP32), limit ~1 A (R22 24k9): the module's radio draws peaks over 0.5 A; 5 V from the module's USB does not flow back into 5V_SW.

4. FPGA ISOLATION, TX FLIP-FLOP

v1.2: lines to the right leave the right row as J2, J3, DAC, host; U13's (SRC_BCLK, SRC_LRCK, DIN2) the left row, over M1.

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

fibre FROM the previous node -> RX

fibre TO the next node <- TX

Pins 1..20 / 21..40 top to bottom, from the USB-C; name = the GW2AR pin + what the module has on it (data sheet v1.3). The ring and the Si514 on the LCD pins only (an empty connector): LOCK on 31, S/PDIF on 42. HSPI, 54..56 (the module amplifier's inputs; PA_EN = 51 keeps it off), EDID 52/53: UART, MCLK, I2S, SD1, DIN2. CLK_1024 (Si514) -> 77 (GCLKT_1). TX_FB -> 25 through IDES8 (1.26 ns); it takes the pair, so 26 is not connected. D3: the USB and 5V_SW are never joined; U6 gives 5.3 V, the module gets ~5.0 V.

FB1/FB2 + 100n + 10u: RX and TX separately.
R7: RXD held at 0 while the receiver sleeps.

is off, they (Ioff) do not load the lines.

U9: the TX edges on the Si514's clock (RT_CLK). J3: I2S, BCLK 64 Fs, 32-bit slots, 24 bits with the head unit's controls applied; the same on S/PDIF, J6, J7 (block 9). v1.3: RDY -> MUTE - silent until the SRC4192

S = 1 (LOCK and TX edges, U11): TX = the regenerated signal from the FPGA. The network does not see us.

J2 UART_TX: the raw control blocks (the same M2 reads). U14 LP5907: 3V3_DA (250 mA) for block 9 from 5V_SW, not from the module's LDO. J7 pad 3 (the thin pin off the axis): BKL's drawing gives it no function; measure on a sample. U13 SRC4192: both ports slave (MODE = 000); input I2S 24 bit (IFMT = 001) from U12; output I2S 24 bit (OFMT = 01, OWL = 00) on the FPGA's clocks (their own copies of BCLK, LRCK: SRC_BCLK_F, SRC_LRCK_F) -> I2S_DIN2_F. X1 24.576 MHz: the reference clock of the SRC4192's rate estimator (RCKI), asynchronous to both ports. RST_AIN: R30/C40 = 10 ms, once X1 runs (the SRC4192 has no POR). OPT_ERR (U12 ERROR) -> M2 IO13: 1 = no TOSLINK signal or a parity error; OPT_NPCM (U12 AUDIO) -> M2 IO27: 1 = not PCM (the DIR9001 does not mute AC-3/DTS); the host then does not inject. Source: command 02, bit M[2].

has found the rate ratio. R18..R21, R34..R41 (33 ohm): each by its FPGA pin (source termination); R38..R41 under M2.

CLK+ -> FPGA (clk_r = 1024 Fs) and through R15 to U9: the TX edges sit on the Si514's clock, not on the FPGA's output. CLK- is not needed.

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

EMPH 17 BFRAME 18 RSV 19 RXIN 20 RST 21

Bench probe points: the 3V3_AON and 5V_SW rails, ground. None on the ring's lines: a stub on their edges would hurt. RX_BUF at U1 pin 4, TX_SEL at U2 pin 6, TX_REGEN and RT_CLK at U9 and at M1 (TX_FB).

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

C36/C37 U13 VDD; C38 U13 VIO; C39 X1: by the pins.

S/PDIF OUT: SPDIF_F (FPGA 42) -> R28 -> J6 FCR684205T; R26/R27: 0.5 V into 75 ohm, 75 ohm out; C29 blocks DC -> J7 RCA. The same stream as on J3.

Sheet: /
File: most_listener.kicad_sch
Title: MOST25 to AUDIO: listener board

Size: A2 | Rev: 1.6
KiCad E.D.A. 10.0.6 | Id: 1/1
