Oleg-mk/MOST25-to-AUDIO/kit/1_boards/most_listener_v2-assembly-top.pdf

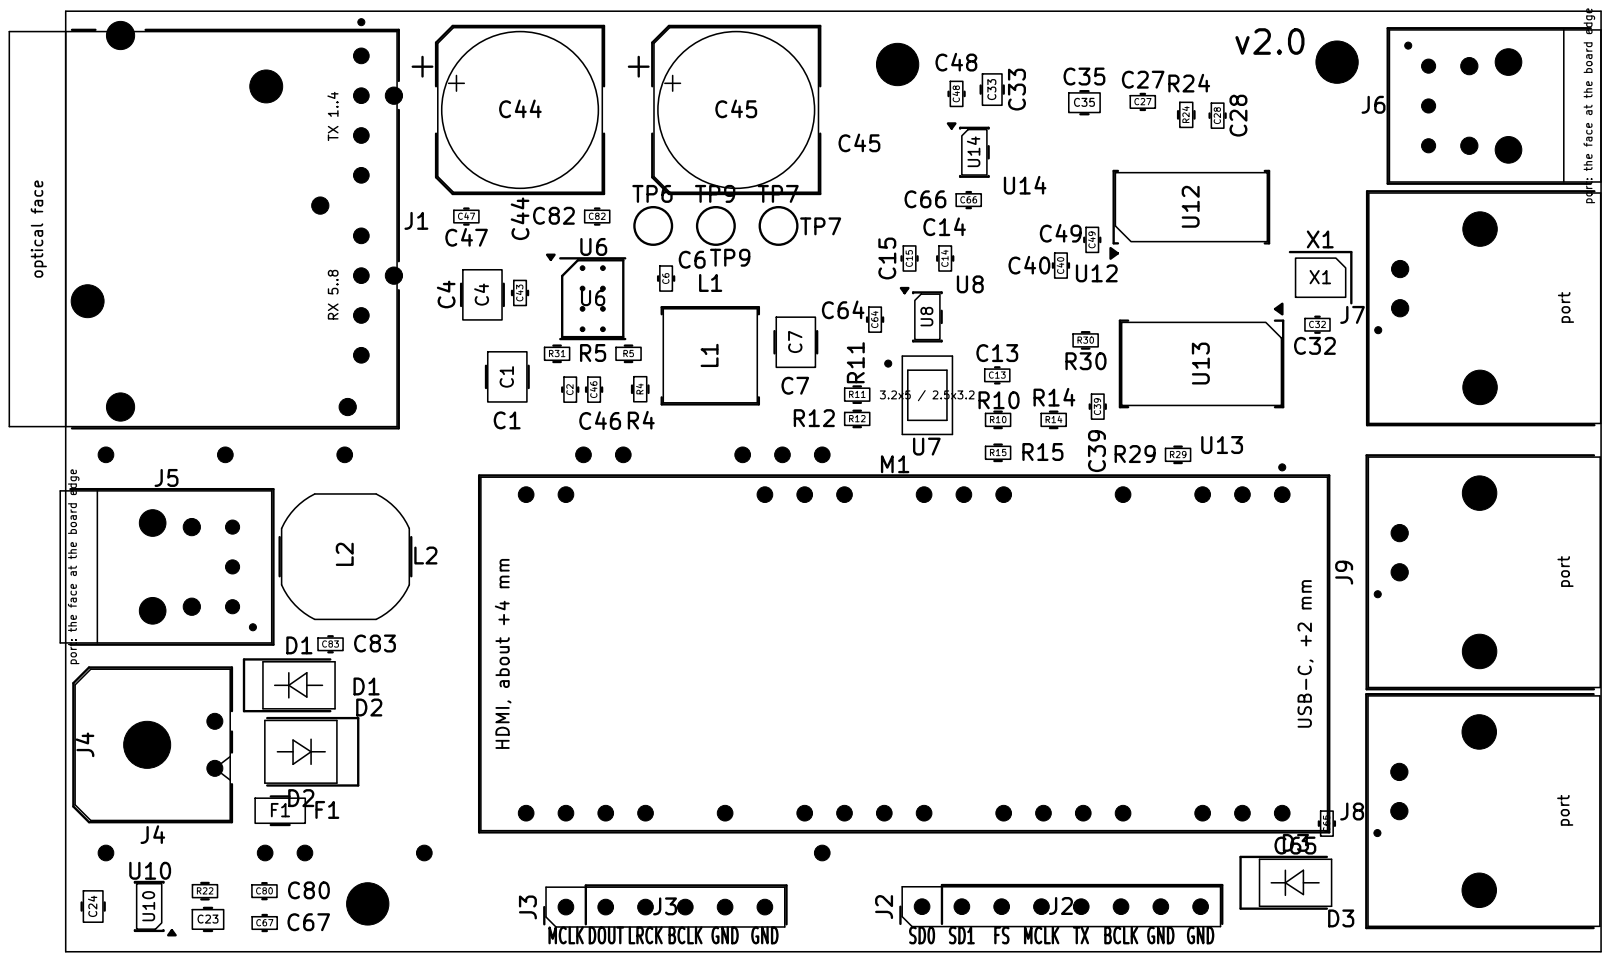
[picture p9: page 1]

R10 C24 J4 port: the face at the board edge
