Oleg-mk/MOST25-to-AUDIO/kit/1_boards/most_listener_v2-assembly-bottom.pdf

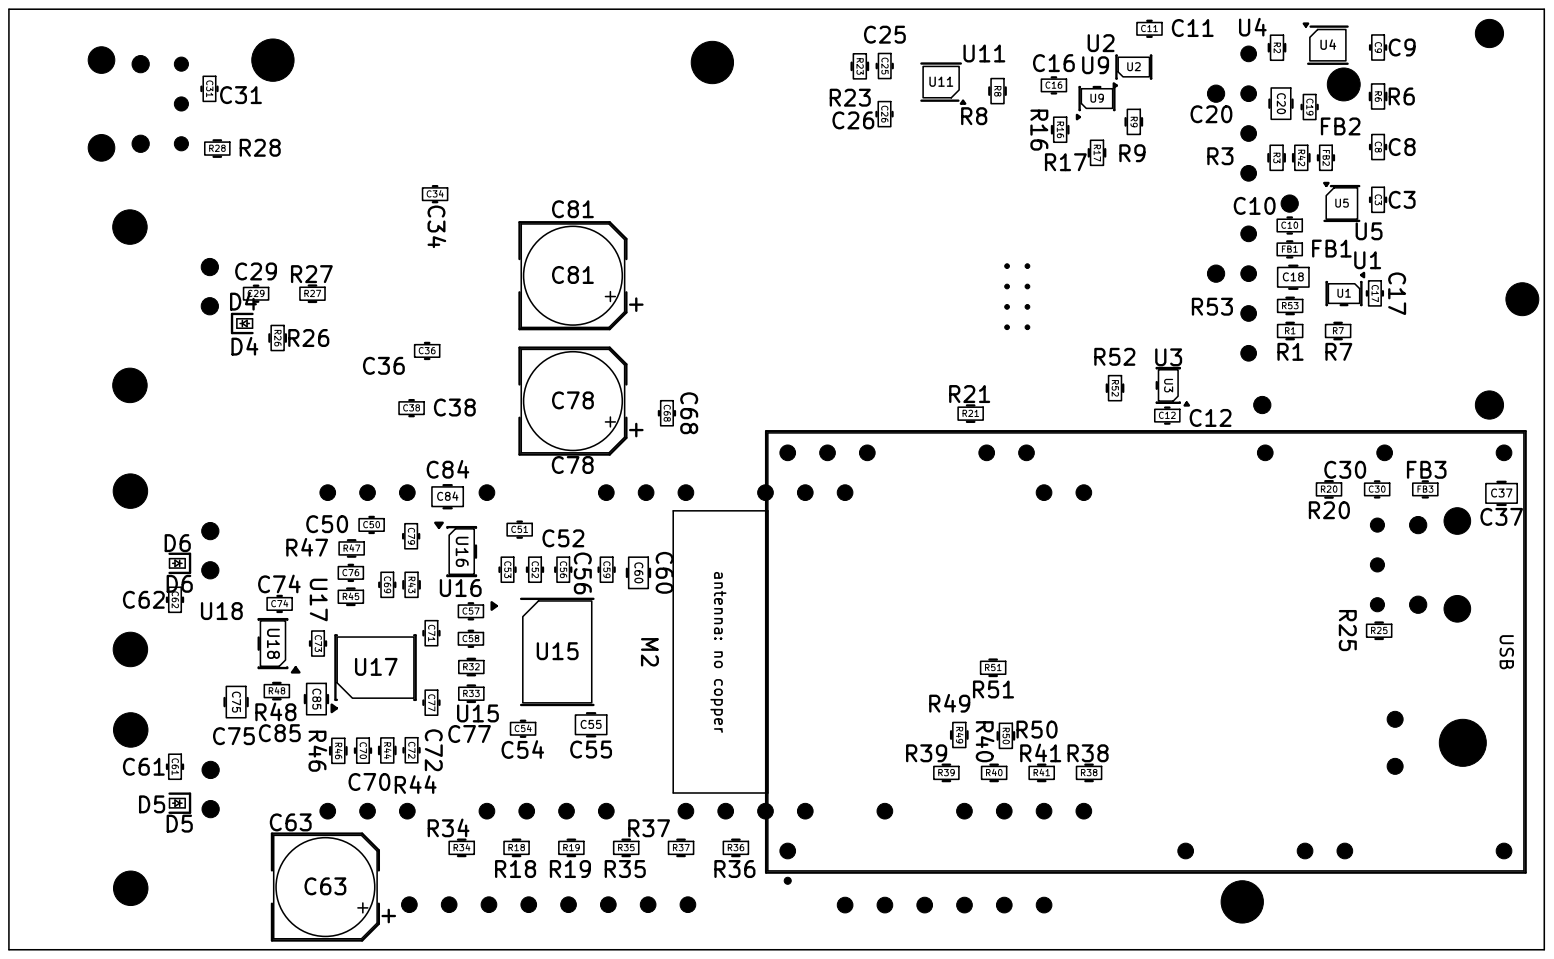
[picture p10: page 1]
