Oleg-mk/MOST25-to-AUDIO/listener_hw/fab/most_listener-assembly.pdf

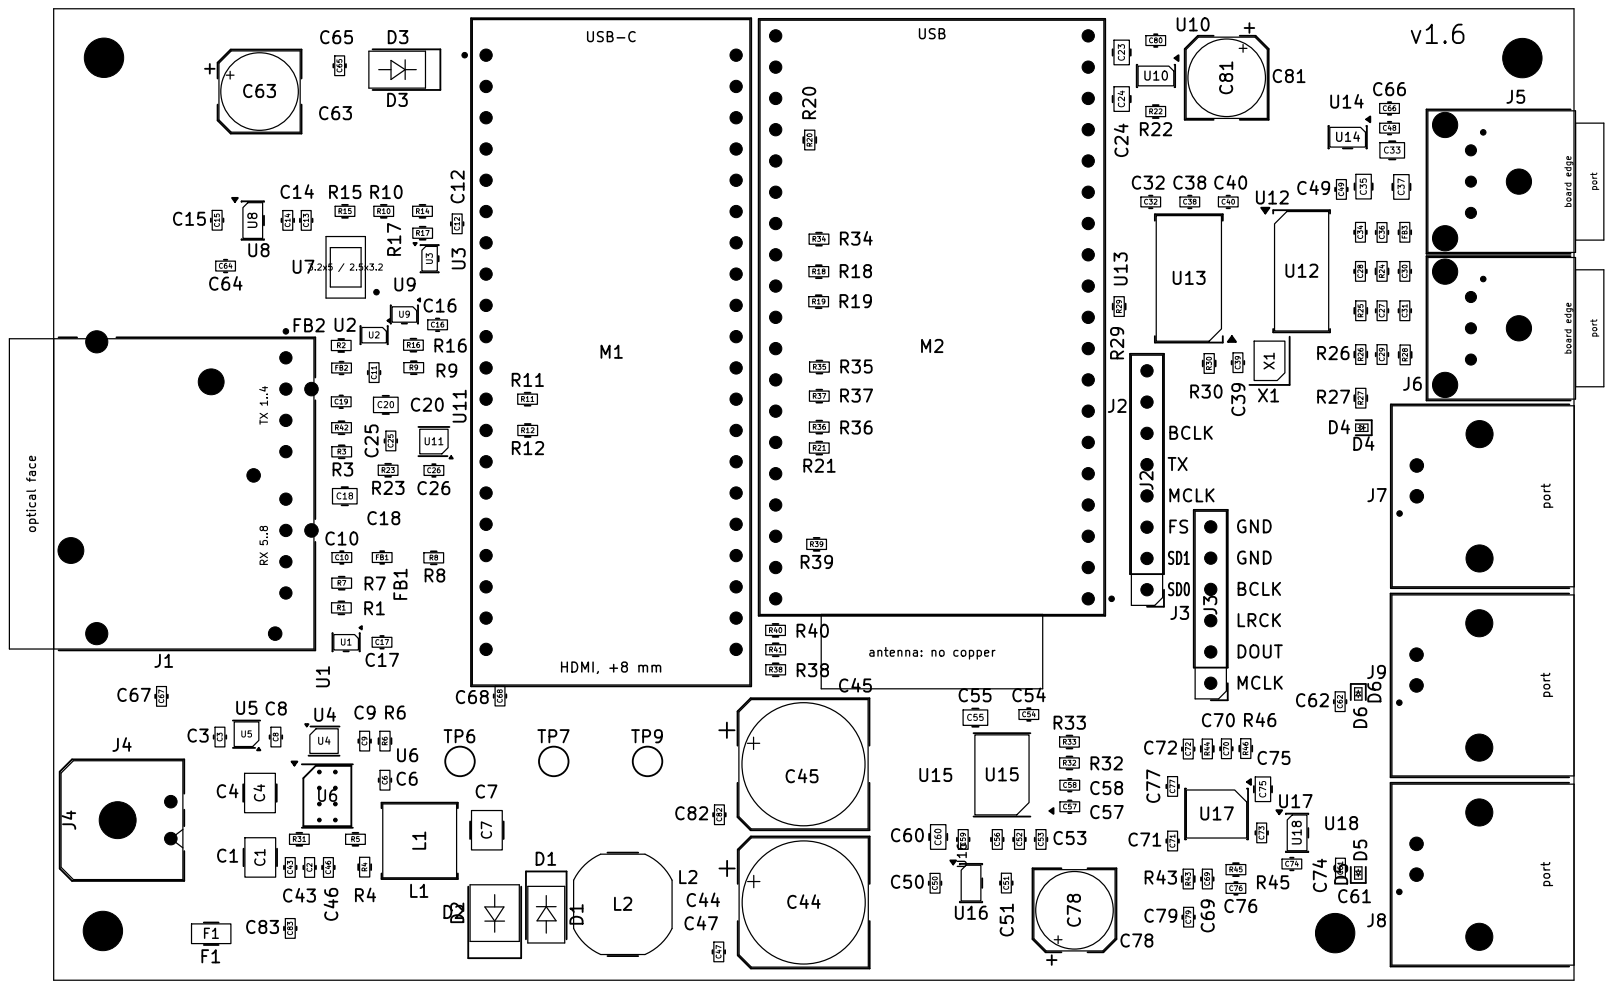
[picture p11: page 1]
