Oleg-mk/MOST25-to-AUDIO/listener_hw2/most_listener_v2.kicad_pcb

## KiCad design listener_hw2/most_listener_v2.kicad_pcb (2026-10-11)

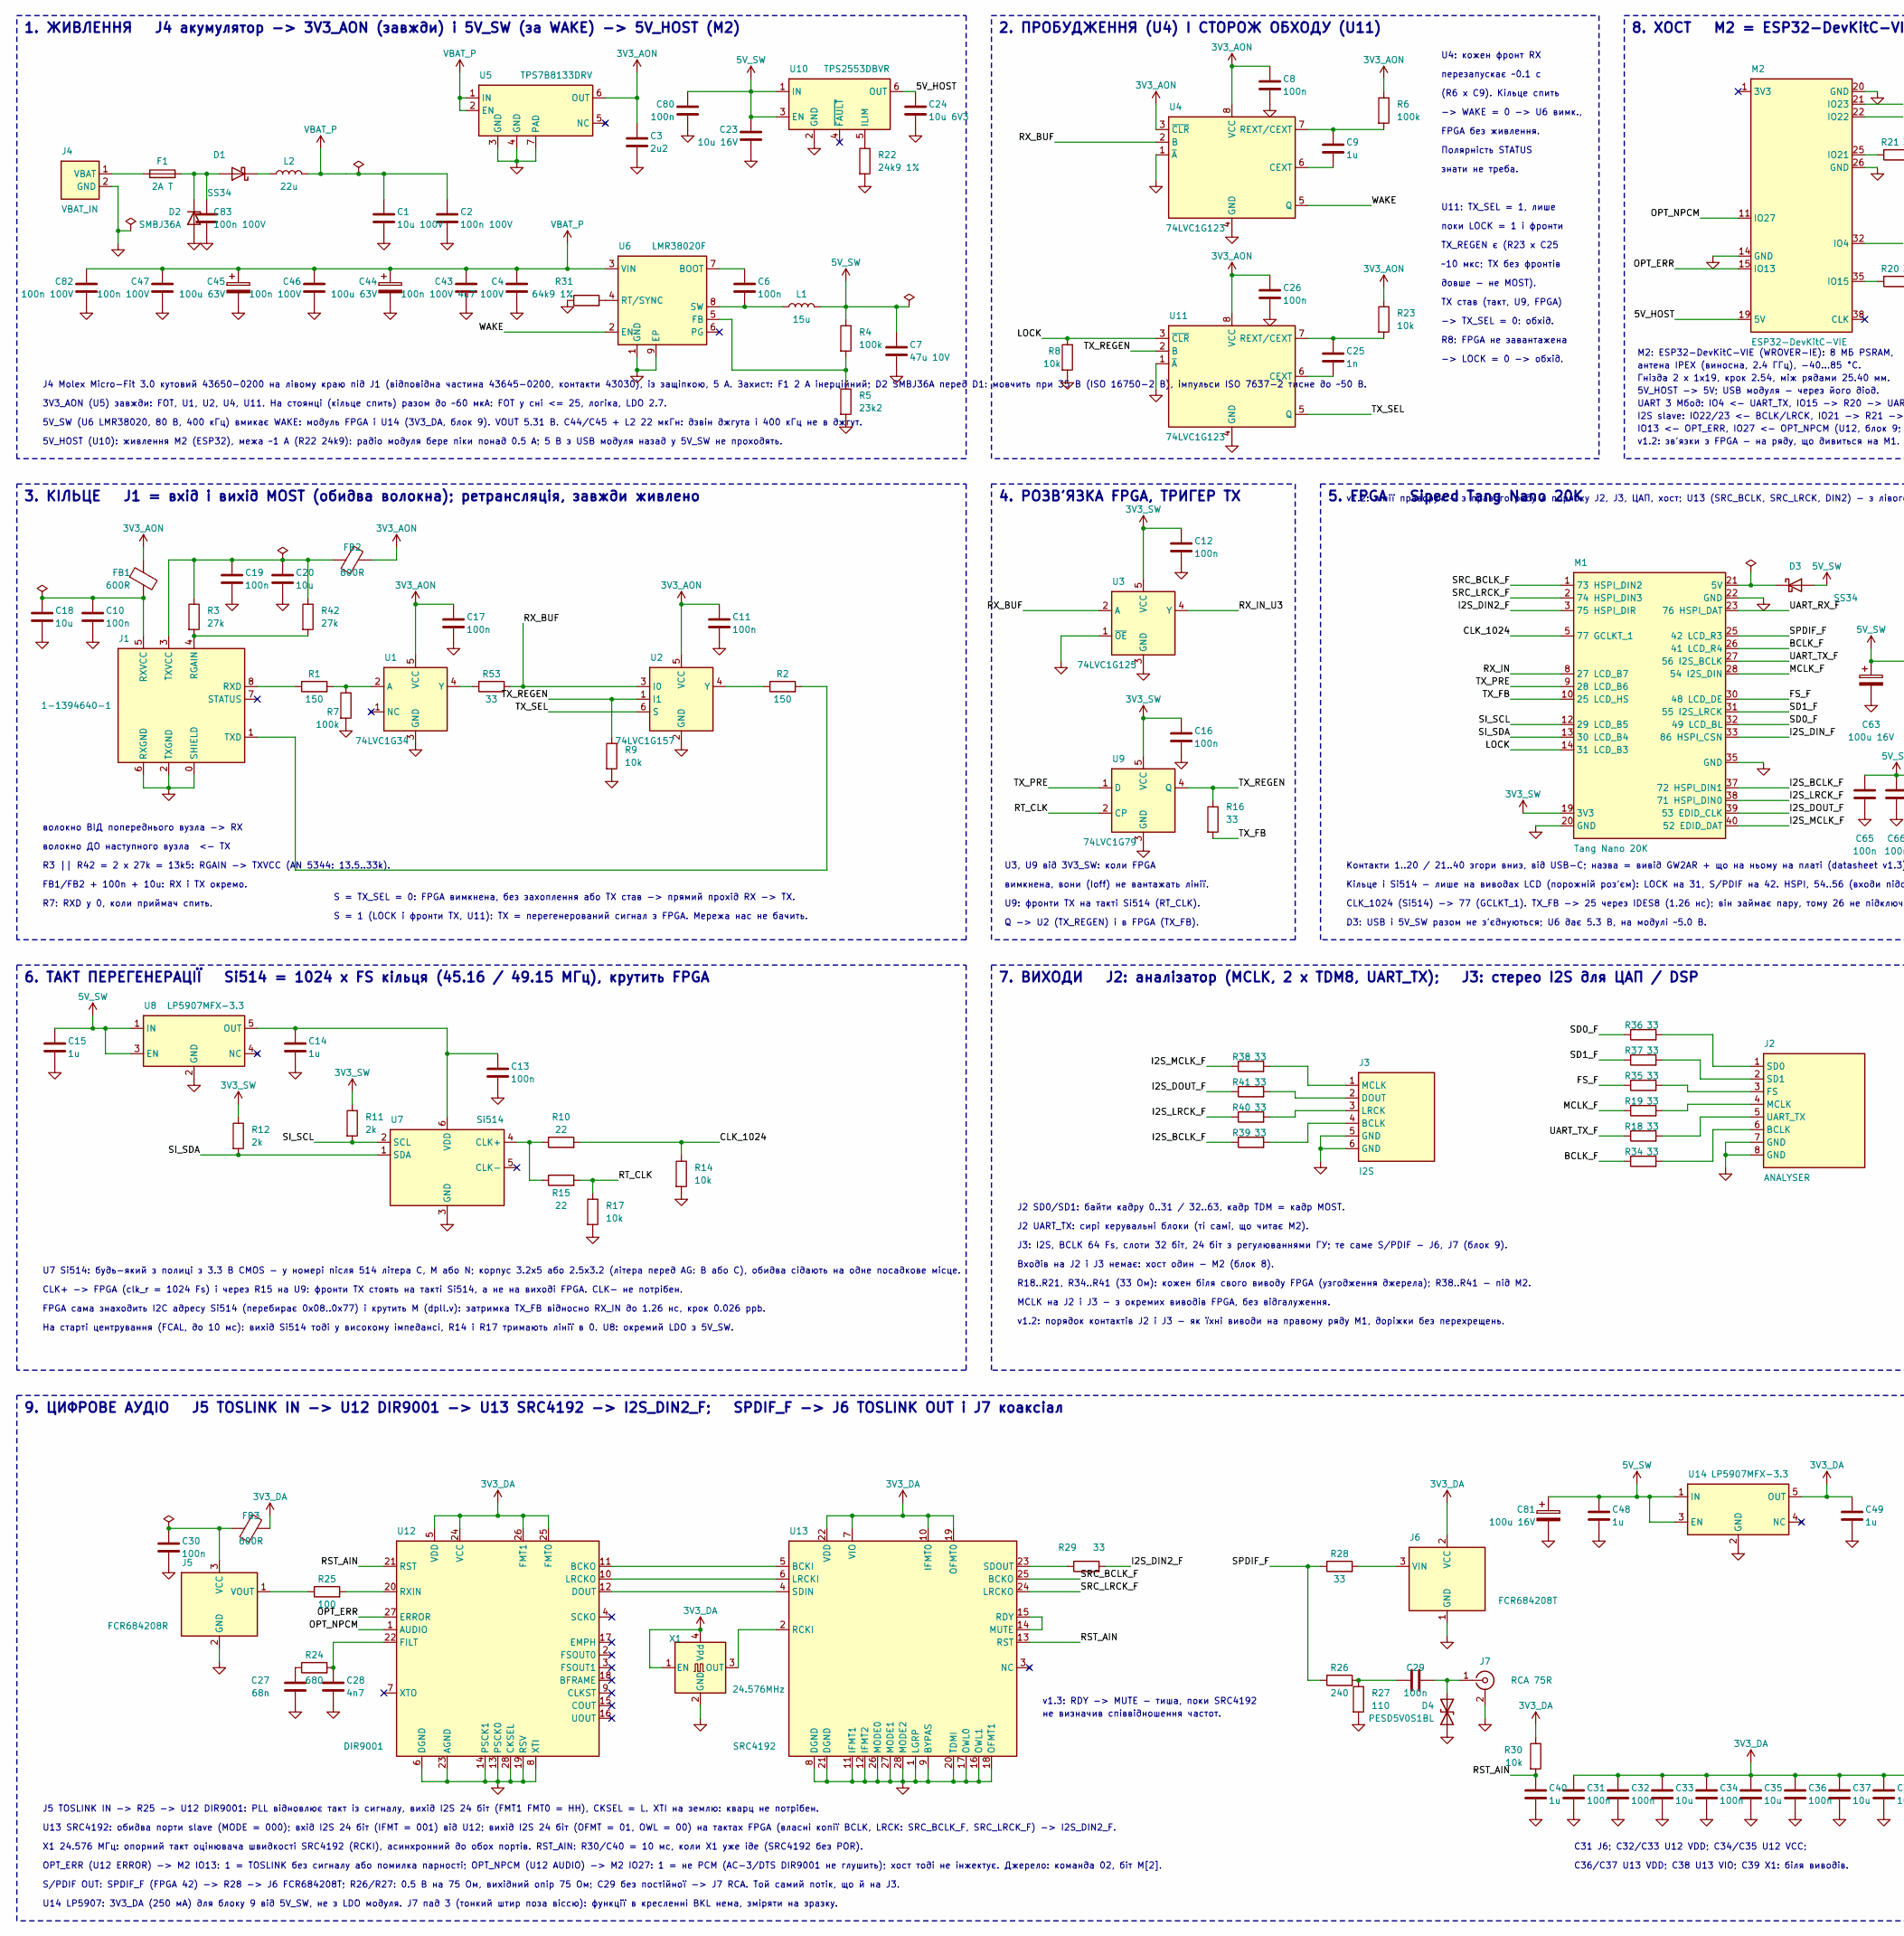
[picture p12: schematic most_listener_v2.kicad_sch, MOST25 to AUDIO: listener board v2.0, part in row 1, column 1]

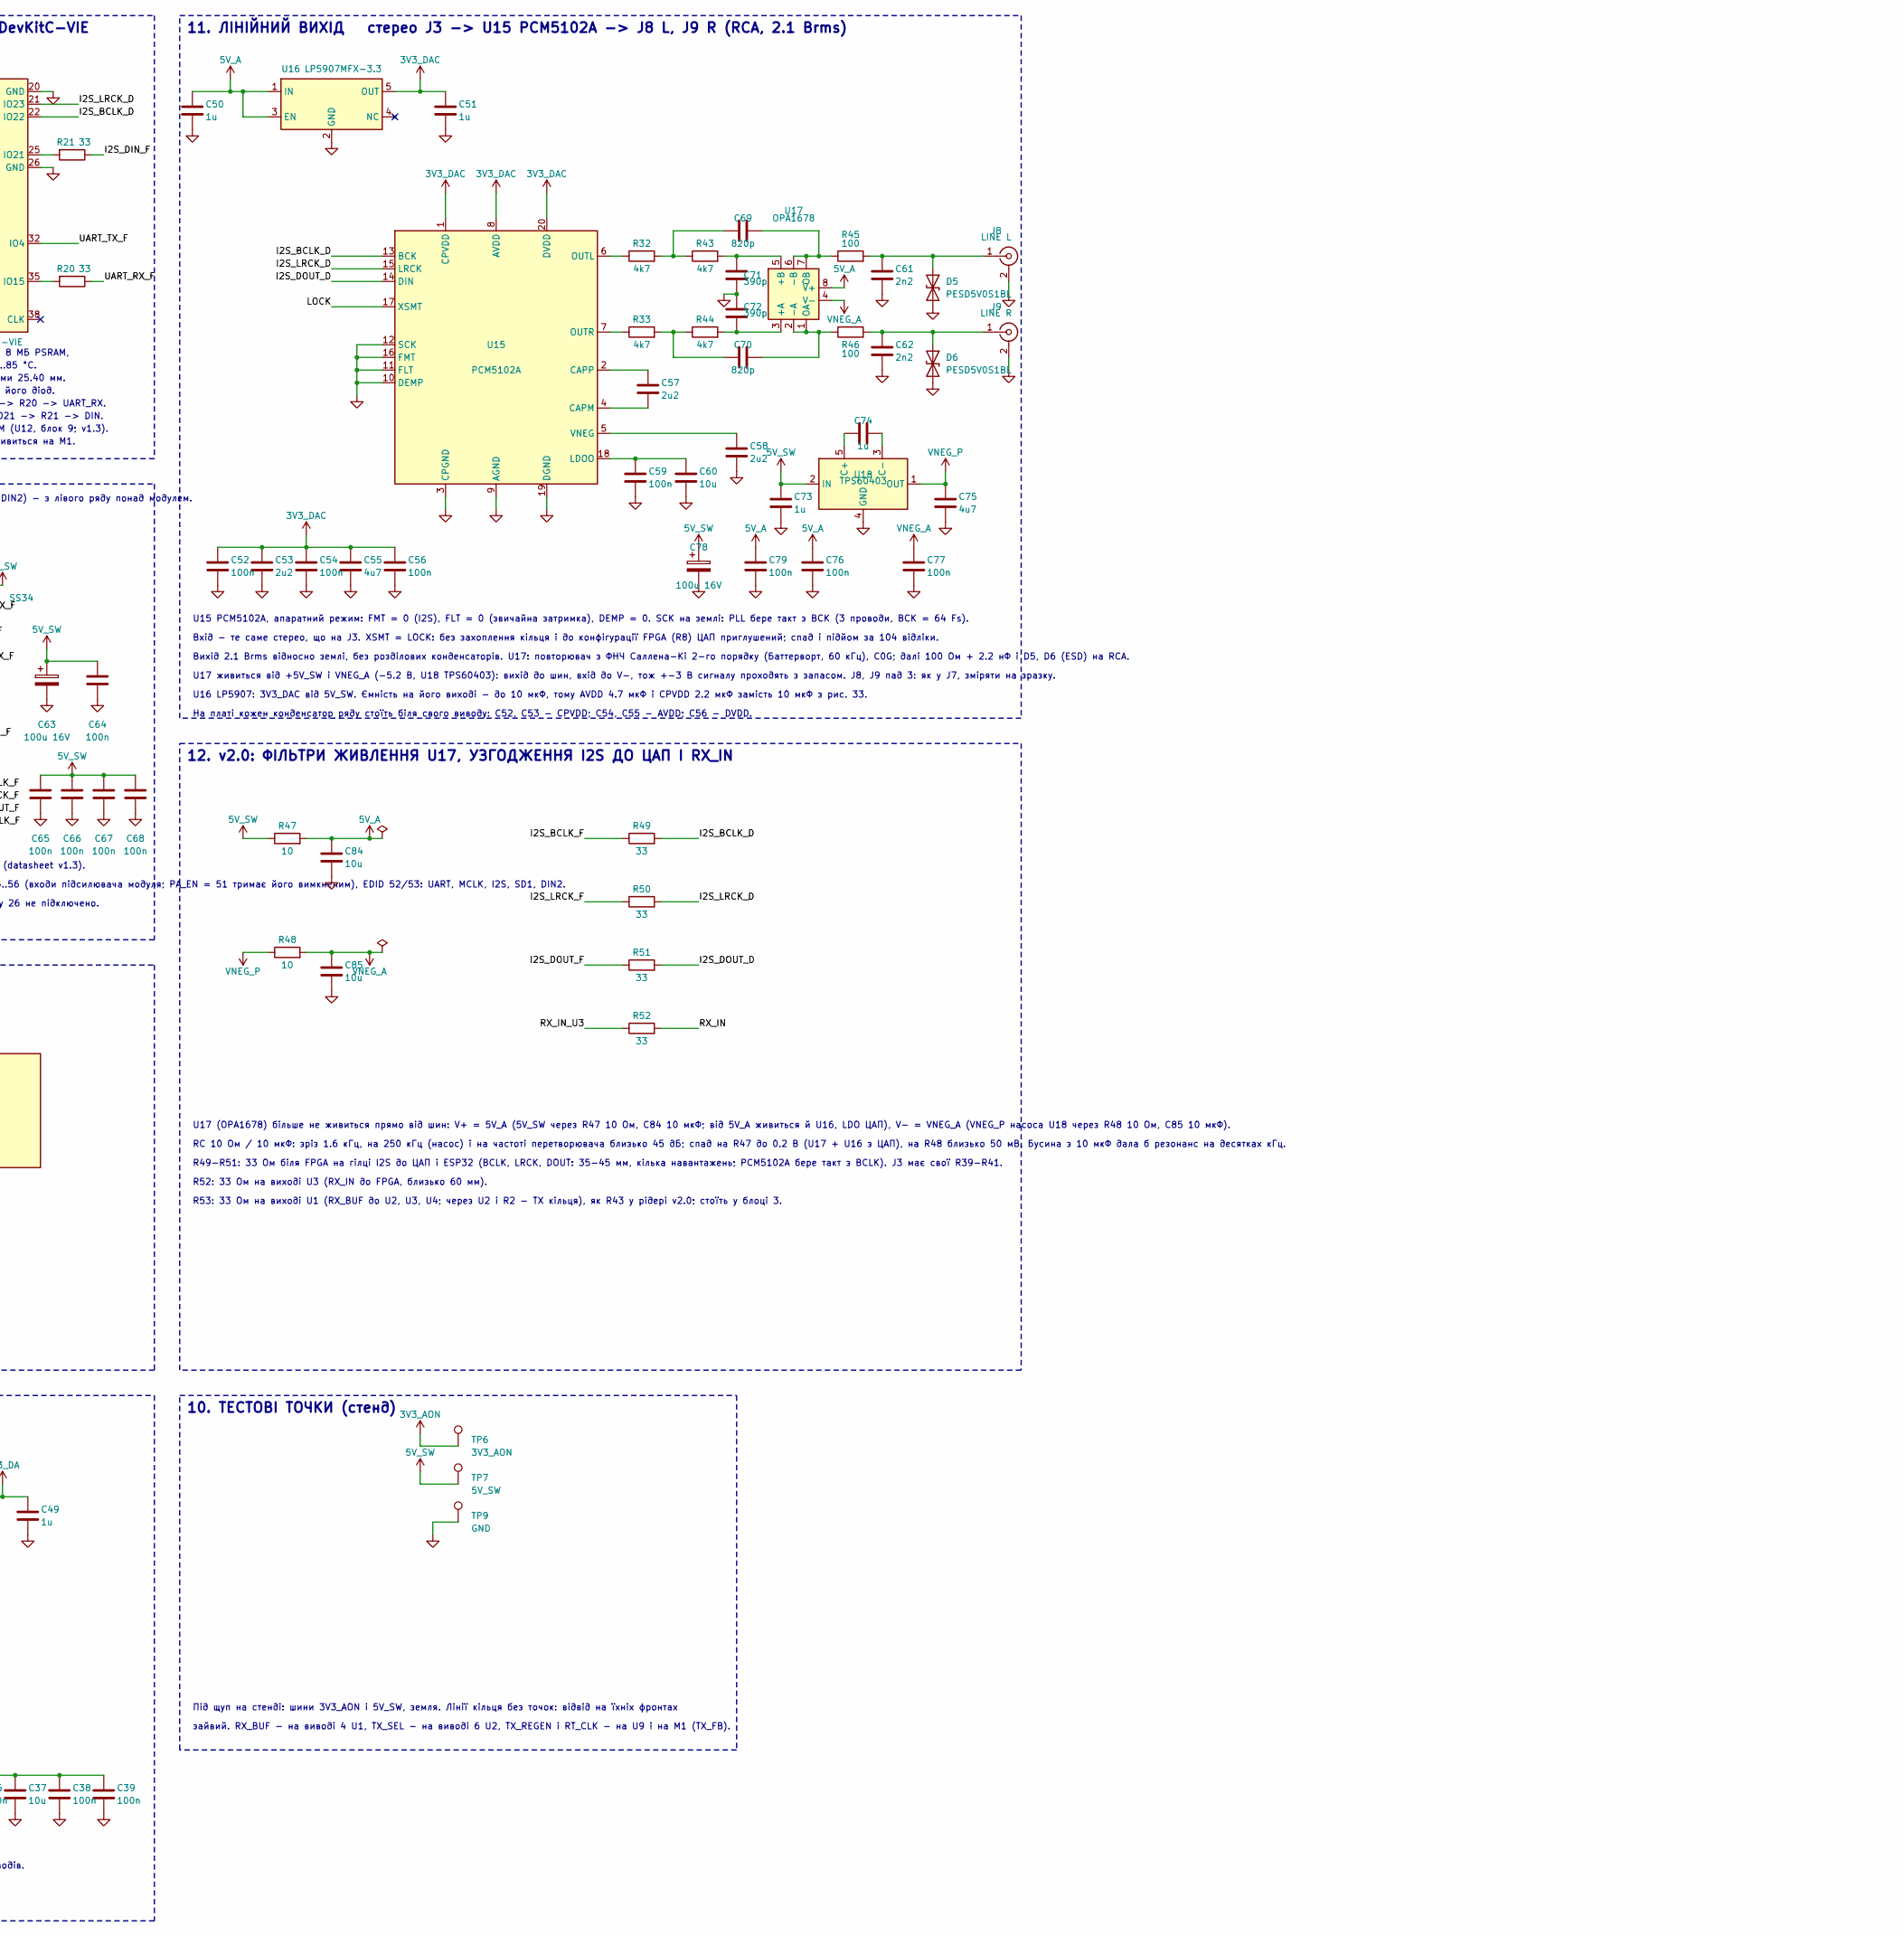
[picture p13: schematic most_listener_v2.kicad_sch, MOST25 to AUDIO: listener board v2.0, part in row 1, column 2]

Parts:
C1: 10u 100V; C_1210_3225Metric
C2, C43, C46, C47, C82, C83: 100n 100V; C_0603_1608Metric
C3, C53, C57, C58: 2u2; C_0603_1608Metric
C4: 4u7 100V; C_1210_3225Metric
C6, C8, C10, C11, C12, C13, C16, C17, C19, C26, C29, C30, C31, C32, C34, C36, C38, C39, C52, C54, C56, C59, C64, C65, C66, C67, C68, C76, C77, C79, C80: 100n; C_0603_1608Metric
C7: 47u 10V; C_1210_3225Metric
C9, C14, C15, C40, C48, C49, C50, C51, C73, C74: 1u; C_0603_1608Metric
C18, C20, C33, C35, C37, C60, C84, C85: 10u; C_0805_2012Metric
C23: 10u 16V; C_0805_2012Metric
C24: 10u 6V3; C_0805_2012Metric
C25: 1n; C_0603_1608Metric
C27: 68n; C_0603_1608Metric
C28: 4n7; C_0603_1608Metric
C44, C45: 100u 63V; CP_Elec_10x10.5
C55, C75: 4u7; C_0805_2012Metric
C61, C62: 2n2; C_0603_1608Metric
C63, C78, C81: 100u 16V; CP_Elec_6.3x7.7
C69, C70: 820p; C_0603_1608Metric
C71, C72: 390p; C_0603_1608Metric
D1, D3: SS34; D_SMA
D2: SMBJ36A; D_SMB
D4, D5, D6: PESD5V0S1BL; D_SOD-882
F1: 2A T; Fuse_1206_3216Metric
FB1, FB2, FB3: 600R; L_0603_1608Metric
J1: 1-1394640-1; TE_MOST_Pigtail_FOT_2+0
J2: ANALYSER; PinHeader_1x08_P2.54mm_Vertical
J3: I2S; PinHeader_1x06_P2.54mm_Vertical
J4: VBAT_IN; Molex_Micro-Fit_3.0_43650-0200_1x02_P3.00mm_Horizontal
J5: FCR684208R; Cliff_TOSLINK_ORJ8_OTJ8
J6: FCR684208T; Cliff_TOSLINK_ORJ8_OTJ8
J7: RCA 75R; BKL_0101153_RCA_RA
J8: LINE L; BKL_0101153_RCA_RA
J9: LINE R; BKL_0101153_RCA_RA
L1: 15u; L_Bourns_SRN6045TA
L2: 22u; L_Bourns-SRN8040_8x8.15mm
M1: Tang Nano 20K; Sipeed_TangNano20K
M2: ESP32-DevKitC-VIE; Espressif_ESP32-DevKitC_V4
R1, R2: 150; R_0603_1608Metric
R3, R42: 27k; R_0603_1608Metric
R4, R6, R7: 100k; R_0603_1608Metric
R5: 23k2; R_0603_1608Metric
R8, R9, R14, R17, R23, R30: 10k; R_0603_1608Metric
R10, R15: 22; R_0603_1608Metric
R11, R12: 2k; R_0603_1608Metric
R16, R18, R19, R20, R21, R28, R29, R34, R35, R36, R37, R38, R39, R40, R41, R49, R50, R51, R52, R53: 33; R_0603_1608Metric
R22: 24k9 1%; R_0603_1608Metric
R24: 680; R_0603_1608Metric
R25, R45, R46: 100; R_0603_1608Metric
R26: 240; R_0603_1608Metric
R27: 110; R_0603_1608Metric
R31: 64k9 1%; R_0603_1608Metric
R32, R33, R43, R44: 4k7; R_0603_1608Metric
R47, R48: 10; R_0603_1608Metric
TP6: 3V3_AON; TestPoint_Pad_D2.0mm
TP7: 5V_SW; TestPoint_Pad_D2.0mm
TP9: GND; TestPoint_Pad_D2.0mm
U1: 74LVC1G34; SOT-353_SC-70-5
U2: 74LVC1G157; SOT-363_SC-70-6
U3: 74LVC1G125; SOT-353_SC-70-5
U4, U11: 74LVC1G123; VSSOP-8_2.3x2mm_P0.5mm
U5: TPS7B8133DRV; WSON-6-1EP_2x2mm_P0.65mm_EP1x1.6mm
U6: LMR38020F; Texas_HSOP-8-1EP_3.9x4.9mm_P1.27mm_ThermalVias
U7: Si514; Si514_3.2x5_2.5x3.2
U8, U14, U16: LP5907MFX-3.3; SOT-23-5
U9: 74LVC1G79; SOT-353_SC-70-5
U10: TPS2553DBVR; SOT-23-6
U12: DIR9001; TSSOP-28_4.4x9.7mm_P0.65mm
U13: SRC4192; SSOP-28_5.3x10.2mm_P0.65mm
U15: PCM5102A; TSSOP-20_4.4x6.5mm_P0.65mm
U17: OPA1678; SOIC-8_3.9x4.9mm_P1.27mm
U18: TPS60403; SOT-23-5
X1: 24.576MHz; Oscillator_SMD_Abracon_ASE-4Pin_3.2x2.5mm

Connections:
3V3_AON: C3.1, C8.1, C11.1, C17.1, C26.1, FB1.1, FB2.2, R6.1, R23.1, TP6.1, U1.5 (VCC), U2.5 (VCC), U4.3 (~CLR), U4.8 (VCC), U5.6 (OUT), U11.8 (VCC)
3V3_DA: C31.1, C32.1, C33.1, C34.1, C35.1, C36.1, C37.1, C38.1, C39.1, C49.1, FB3.2, J6.2 (VCC), R30.1, U12.5 (VDD), U12.24 (VCC), U12.25 (FMT0), U12.26 (FMT1), U13.7 (VIO), U13.10 (IFMT0), U13.19 (OFMT0), U13.22 (VDD), U14.5 (OUT), X1.1 (EN), X1.4 (Vdd)
3V3_DAC: C51.1, C52.1, C53.1, C54.1, C55.1, C56.1, U15.1 (CPVDD), U15.8 (AVDD), U15.20 (DVDD), U16.5 (OUT)
3V3_SW: C12.1, C16.1, M1.19 (3V3), R11.1, R12.1, U3.5 (VCC), U9.5 (VCC)
5V_A: C50.1, C76.1, C79.1, C84.1, R47.2, U16.1 (IN), U16.3 (EN), U17.8 (V+)
5V_SW: C7.1, C15.1, C23.1, C48.1, C63.1, C64.1, C65.1, C66.1, C67.1, C68.1, C73.1, C78.1, C80.1, C81.1, D3.2 (A), L1.2, R4.1, R47.1, TP7.1, U8.1 (IN), U8.3 (EN), U10.1 (IN), U10.3 (EN), U14.1 (IN), U14.3 (EN), U18.2 (IN)
/5V_HOST: C24.1, M2.19 (5V), U10.6 (OUT)
/BCLK_F: M1.26 (41 LCD_R4), R34.1
/CLK_1024: M1.5 (77 GCLKT_1), R10.2, R14.1
/FS_F: M1.30 (48 LCD_DE), R35.1
/I2S_BCLK_D: M2.22 (IO22), R49.2, U15.13 (BCK)
/I2S_BCLK_F: M1.37 (72 HSPI_DIN1), R39.1, R49.1
/I2S_DIN2_F: M1.3 (75 HSPI_DIR), R29.2
/I2S_DIN_F: M1.33 (86 HSPI_CSN), R21.1
/I2S_DOUT_D: R51.2, U15.14 (DIN)
/I2S_DOUT_F: M1.39 (53 EDID_CLK), R41.1, R51.1
/I2S_LRCK_D: M2.21 (IO23), R50.2, U15.15 (LRCK)
/I2S_LRCK_F: M1.38 (71 HSPI_DIN0), R40.1, R50.1
/I2S_MCLK_F: M1.40 (52 EDID_DAT), R38.1
/LOCK: M1.14 (31 LCD_B3), R8.1, U11.3 (~CLR), U15.17 (XSMT)
/MCLK_F: M1.28 (54 I2S_DIN), R19.1
/OPT_ERR: M2.15 (IO13), U12.27 (ERROR)
/OPT_NPCM: M2.11 (IO27), U12.1 (AUDIO)
/RST_AIN: C40.1, R30.2, U12.21 (RST), U13.13 (RST)
/RT_CLK: R15.2, R17.1, U9.2 (CP)
/RX_BUF: R53.2, U2.3 (I0), U3.2 (A), U4.2 (B)
/RX_IN: M1.8 (27 LCD_B7), R52.2
/RX_IN_U3: R52.1, U3.4 (Y)
/SD0_F: M1.32 (49 LCD_BL), R36.1
/SD1_F: M1.31 (55 I2S_LRCK), R37.1
/SI_SCL: M1.12 (29 LCD_B5), R11.2, U7.2 (SCL)
/SI_SDA: M1.13 (30 LCD_B4), R12.2, U7.1 (SDA)
/SPDIF_F: M1.25 (42 LCD_R3), R26.1, R28.1
/SRC_BCLK_F: M1.1 (73 HSPI_DIN2), U13.25 (BCKO)
/SRC_LRCK_F: M1.2 (74 HSPI_DIN3), U13.24 (LRCKO)
/TX_FB: M1.10 (25 LCD_HS), R16.2
/TX_PRE: M1.9 (28 LCD_B6), U9.1 (D)
/TX_REGEN: R9.1, R16.1, U2.1 (I1), U9.4 (Q), U11.2 (B)
/TX_SEL: U2.6 (S), U11.5 (Q)
/UART_RX_F: M1.23 (76 HSPI_DAT), R20.1
/UART_TX_F: M1.27 (56 I2S_BCLK), M2.32 (IO4), R18.1
/WAKE: U4.5 (Q), U6.2 (EN)
GND: C1.2, C2.2, C3.2, C4.2, C7.2, C8.2, C10.2, C11.2, C12.2, C13.2, C14.2, C15.2, C16.2, C17.2, C18.2, C19.2, C20.2, C23.2, C24.2, C26.2, C27.2, C28.2, C30.2, C31.2, C32.2, C33.2, C34.2, C35.2, C36.2, C37.2, C38.2, C39.2, C40.2, C43.2, C44.2, C45.2, C46.2, C47.2, C48.2, C49.2, C50.2, C51.2, C52.2, C53.2, C54.2, C55.2, C56.2, C58.2, C59.2, C60.2, C61.2, C62.2, C63.2, C64.2, C65.2, C66.2, C67.2, C68.2, C71.2, C72.1, C73.2, C75.2, C76.2, C77.2, C78.2, C79.2, C80.2, C81.2, C82.2, C83.2, C84.2, C85.2, D2.2 (A), D4.2 (A2), D5.2 (A2), D6.2 (A2), J1.0 (SHIELD), J1.2 (TXGND), J1.6 (RXGND), J2.7 (GND), J2.8 (GND), J3.5 (GND), J3.6 (GND), J4.2 (GND), J5.2 (GND), J6.1 (GND), J7.2 (Ext), J8.2 (Ext), J9.2 (Ext), M1.20 (GND), M1.22 (GND), M1.35 (GND), M2.14 (GND), M2.20 (GND), M2.26 (GND), R5.2, R7.2, R8.2, R9.2, R14.2, R17.2, R22.2, R27.2, R31.1, TP9.1, U1.3 (GND), U2.2 (GND), U3.1 (~OE), U3.3 (GND), U4.1 (~A), U4.4 (GND), U5.3 (GND), U5.4 (GND), U5.7 (PAD), U6.1 (GND), U6.9 (EP), U7.3 (GND), U8.2 (GND), U9.3 (GND), U10.2 (GND), U11.1 (~A), U11.4 (GND), U12.6 (DGND), U12.8 (XTI), U12.13 (PSCK0), U12.14 (PSCK1), U12.19 (RSV), U12.23 (AGND), U12.28 (CKSEL), U13.1 (LGRP), U13.8 (DGND), U13.9 (BYPAS), U13.11 (IFMT1), U13.12 (IFMT2), U13.16 (OWL1), U13.17 (OWL0), U13.18 (OFMT1), U13.20 (TDMI), U13.21 (DGND), U13.26 (MODE0), U13.27 (MODE1), U13.28 (MODE2), U14.2 (GND), U15.3 (CPGND), U15.9 (AGND), U15.10 (DEMP), U15.11 (FLT), U15.12 (SCK), U15.16 (FMT), U15.19 (DGND), U16.2 (GND), U18.4 (GND), X1.2 (GND)
unnamed: C27.1, R24.1
unnamed: C29.1, R26.2, R27.1
unnamed: C69.1, R32.2, R43.1
unnamed: C70.1, R33.2, R44.1
unnamed: C83.1, D1.2 (A), D2.1 (K), F1.2
unnamed: D1.1 (K), L2.1
unnamed: D3.1 (K), M1.21 (5V)
unnamed: C29.2, D4.1 (A1), J7.1 (In)
unnamed: C61.1, D5.1 (A1), J8.1 (In), R45.2
unnamed: C62.1, D6.1 (A1), J9.1 (In), R46.2
unnamed: J1.4 (RGAIN), R3.2, R42.2
unnamed: J1.8 (RXD), R1.1
unnamed: C10.1, C18.1, FB1.2, J1.5 (RXVCC)
unnamed: J1.1 (TXD), R2.2
unnamed: C19.1, C20.1, FB2.1, J1.3 (TXVCC), R3.1, R42.1
unnamed: J2.6 (BCLK), R34.2
unnamed: J2.3 (FS), R35.2
unnamed: J2.4 (MCLK), R19.2
unnamed: J2.1 (SD0), R36.2
unnamed: J2.2 (SD1), R37.2
unnamed: J2.5 (UART_TX), R18.2
unnamed: J3.4 (BCLK), R39.2
unnamed: J3.2 (DOUT), R41.2
unnamed: J3.3 (LRCK), R40.2
unnamed: J3.1 (MCLK), R38.2
unnamed: F1.1, J4.1 (VBAT)
unnamed: C30.1, FB3.1, J5.3 (VCC)
unnamed: J5.1 (VOUT), R25.1
unnamed: J6.3 (VIN), R28.2
unnamed: M2.35 (IO15), R20.2
unnamed: M2.25 (IO21), R21.2
unnamed: R1.2, R7.1, U1.2 (A)
unnamed: R53.1, U1.4 (Y)
unnamed: R2.1, U2.4 (Y)
unnamed: C9.2, U4.6 (CEXT)
unnamed: C9.1, R6.2, U4.7 (REXT/CEXT)
unnamed: C6.1, U6.7 (BOOT)
unnamed: R4.2, R5.1, U6.5 (FB)
unnamed: R31.2, U6.4 (RT/SYNC)
unnamed: C6.2, L1.1, U6.8 (SW)
unnamed: R10.1, R15.1, U7.4 (CLK+)
unnamed: C13.1, C14.1, U7.6 (VDD), U8.5 (OUT)
unnamed: R22.1, U10.5 (ILIM)
unnamed: C25.2, U11.6 (CEXT)
unnamed: C25.1, R23.2, U11.7 (REXT/CEXT)
unnamed: U12.11 (BCKO), U13.5 (BCKI)
unnamed: U12.12 (DOUT), U13.4 (SDIN)
unnamed: C28.1, R24.2, U12.22 (FILT)
unnamed: U12.10 (LRCKO), U13.6 (LRCKI)
unnamed: R25.2, U12.20 (RXIN)
unnamed: U13.14 (MUTE), U13.15 (RDY)
unnamed: U13.2 (RCKI), X1.3 (OUT)
unnamed: R29.1, U13.23 (SDOUT)
unnamed: C57.2, U15.4 (CAPM)
unnamed: C57.1, U15.2 (CAPP)
unnamed: C59.1, C60.1, U15.18 (LDOO)
unnamed: R32.1, U15.6 (OUTL)
unnamed: R33.1, U15.7 (OUTR)
unnamed: C58.1, U15.5 (VNEG)
unnamed: C72.2, R44.2, U17.3 (+A)
unnamed: C71.1, R43.2, U17.5 (+B)
unnamed: C70.2, R46.1, U17.1 (OA), U17.2 (-A)
unnamed: C69.2, R45.1, U17.6 (-B), U17.7 (OB)
unnamed: C74.1, U18.5 (C+)
unnamed: C74.2, U18.3 (C-)
VBAT_P: C1.1, C2.1, C4.1, C43.1, C44.1, C45.1, C46.1, C47.1, C82.1, L2.2, U5.1 (IN), U5.2 (EN), U6.3 (VIN)
VNEG_A: C77.1, C85.1, R48.2, U17.4 (V-)
VNEG_P: C75.1, R48.1, U18.1 (OUT)

Notes on the sheet:
1. ЖИВЛЕННЯ J4 акумулятор -> 3V3_AON (завжди) і 5V_SW (за WAKE) -> 5V_HOST (M2)
J4 Molex Micro-Fit 3.0 кутовий 43650-0200 на лівому краю під J1 (відповідна частина 43645-0200, контакти 43030), із защіпкою, 5 А. Захист: F1 2 А інерційний; D2 SMBJ36A перед D1: мовчить при 35 В (ISO 16750-2 B), імпульси ISO 7637-2 тисне до ~50 В.
3V3_AON (U5) завжди: FOT, U1, U2, U4, U11. На стоянці (кільце спить) разом до ~60 мкА: FOT у сні <= 25, логіка, LDO 2.7.
5V_SW (U6 LMR38020, 80 В, 400 кГц) вмикає WAKE: модуль FPGA і U14 (3V3_DA, блок 9). VOUT 5.31 В. C44/C45 + L2 22 мкГн: дзвін джгута і 400 кГц не в джгут.
5V_HOST (U10): живлення M2 (ESP32), межа ~1 А (R22 24k9): радіо модуля бере піки понад 0.5 А; 5 В з USB модуля назад у 5V_SW не проходять.
2. ПРОБУДЖЕННЯ (U4) І СТОРОЖ ОБХОДУ (U11)
U4: кожен фронт RX
перезапускає ~0.1 с
(R6 x C9). Кільце спить
-> WAKE = 0 -> U6 вимк.,
FPGA без живлення.
Полярність STATUS
знати не треба.
U11: TX_SEL = 1, лише
поки LOCK = 1 і фронти
TX_REGEN є (R23 x C25
~10 мкс; TX без фронтів
довше - не MOST).
TX став (такт, U9, FPGA)
-> TX_SEL = 0: обхід.
R8: FPGA не завантажена
-> LOCK = 0 -> обхід.
3. КІЛЬЦЕ J1 = вхід і вихід MOST (обидва волокна); ретрансляція, завжди живлено
волокно ВІД попереднього вузла -> RX
волокно ДО наступного вузла <- TX
S = TX_SEL = 0: FPGA вимкнена, без захоплення або TX став -> прямий прохід RX -> TX.
S = 1 (LOCK і фронти TX, U11): TX = перегенерований сигнал з FPGA. Мережа нас не бачить.
R3 || R42 = 2 x 27k = 13k5: RGAIN -> TXVCC (AN 5344: 13.5..33k).
FB1/FB2 + 100n + 10u: RX і TX окремо.
R7: RXD у 0, коли приймач спить.
4. РОЗВ'ЯЗКА FPGA, ТРИГЕР TX
U3, U9 від 3V3_SW: коли FPGA
вимкнена, вони (Ioff) не вантажать лінії.
U9: фронти TX на такті Si514 (RT_CLK).
Q -> U2 (TX_REGEN) і в FPGA (TX_FB).
5. FPGA Sipeed Tang Nano 20K
Контакти 1..20 / 21..40 згори вниз, від USB-C; назва = вивід GW2AR + що на ньому на платі (datasheet v1.3).
Кільце і Si514 - лише на виводах LCD (порожній роз'єм): LOCK на 31, S/PDIF на 42. HSPI, 54..56 (входи підсилювача модуля; PA_EN = 51 тримає його вимкненим), EDID 52/53: UART, MCLK, I2S, SD1, DIN2.
CLK_1024 (Si514) -> 77 (GCLKT_1). TX_FB -> 25 через IDES8 (1.26 нс); він займає пару, тому 26 не підключено.
D3: USB і 5V_SW разом не з'єднуються; U6 дає 5.3 В, на модулі ~5.0 В.
v1.2: лінії праворуч - з правого ряду в порядку J2, J3, ЦАП, хост; U13 (SRC_BCLK, SRC_LRCK, DIN2) - з лівого ряду понад модулем.
6. ТАКТ ПЕРЕГЕНЕРАЦІЇ Si514 = 1024 x FS кільця (45.16 / 49.15 МГц), крутить FPGA
U7 Si514: будь-який з полиці з 3.3 В CMOS - у номері після 514 літера C, M або N; корпус 3.2x5 або 2.5x3.2 (літера перед AG: B або C), обидва сідають на одне посадкове місце.
CLK+ -> FPGA (clk_r = 1024 Fs) і через R15 на U9: фронти TX стоять на такті Si514, а не на виході FPGA. CLK- не потрібен.
FPGA сама знаходить I2C адресу Si514 (перебирає 0x08..0x77) і крутить M (dpll.v): затримка TX_FB відносно RX_IN до 1.26 нс, крок 0.026 ppb.
На старті центрування (FCAL, до 10 мс): вихід Si514 тоді у високому імпедансі, R14 і R17 тримають лінії в 0. U8: окремий LDO з 5V_SW.
7. ВИХОДИ J2: аналізатор (MCLK, 2 x TDM8, UART_TX); J3: стерео I2S для ЦАП / DSP
J2 SD0/SD1: байти кадру 0..31 / 32..63, кадр TDM = кадр MOST.
J2 UART_TX: сирі керувальні блоки (ті самі, що читає M2).
J3: I2S, BCLK 64 Fs, слоти 32 біт, 24 біт з регулюваннями ГУ; те саме S/PDIF - J6, J7 (блок 9).
Входів на J2 і J3 немає: хост один - M2 (блок 8).
R18..R21, R34..R41 (33 Ом): кожен біля свого виводу FPGA (узгодження джерела); R38..R41 - під M2.
MCLK на J2 і J3 - з окремих виводів FPGA, без відгалуження.
v1.2: порядок контактів J2 і J3 - як їхні виводи на правому ряду M1, доріжки без перехрещень.
8. ХОСТ M2 = ESP32-DevKitC-VIE
M2: ESP32-DevKitC-VIE (WROVER-IE): 8 МБ PSRAM,
антена IPEX (виносна, 2.4 ГГц), -40...85 °C.
Гнізда 2 x 1x19, крок 2.54, між рядами 25.40 мм.
5V_HOST -> 5V; USB модуля - через його діод.
UART 3 Мбод: IO4 <- UART_TX, IO15 -> R20 -> UART_RX.
I2S slave: IO22/23 <- BCLK/LRCK, IO21 -> R21 -> DIN.
IO13 <- OPT_ERR, IO27 <- OPT_NPCM (U12, блок 9; v1.3).
v1.2: зв'язки з FPGA - на ряду, що дивиться на M1.
9. ЦИФРОВЕ АУДІО J5 TOSLINK IN -> U12 DIR9001 -> U13 SRC4192 -> I2S_DIN2_F; SPDIF_F -> J6 TOSLINK OUT і J7 коаксіал
v1.3: RDY -> MUTE - тиша, поки SRC4192
не визначив співвідношення частот.
U14 LP5907: 3V3_DA (250 мА) для блоку 9 від 5V_SW, не з LDO модуля. J7 пад 3 (тонкий штир поза віссю): функції в кресленні BKL нема, зміряти на зразку.
C31 J6; C32/C33 U12 VDD; C34/C35 U12 VCC;
C36/C37 U13 VDD; C38 U13 VIO; C39 X1: біля виводів.
J5 TOSLINK IN -> R25 -> U12 DIR9001: PLL відновлює такт із сигналу, вихід I2S 24 біт (FMT1 FMT0 = HH), CKSEL = L. XTI на землю: кварц не потрібен.
U13 SRC4192: обидва порти slave (MODE = 000); вхід I2S 24 біт (IFMT = 001) від U12; вихід I2S 24 біт (OFMT = 01, OWL = 00) на тактах FPGA (власні копії BCLK, LRCK: SRC_BCLK_F, SRC_LRCK_F) -> I2S_DIN2_F.
X1 24.576 МГц: опорний такт оцінювача швидкості SRC4192 (RCKI), асинхронний до обох портів. RST_AIN: R30/C40 = 10 мс, коли X1 уже іде (SRC4192 без POR).
OPT_ERR (U12 ERROR) -> M2 IO13: 1 = TOSLINK без сигналу або помилка парності; OPT_NPCM (U12 AUDIO) -> M2 IO27: 1 = не PCM (AC-3/DTS DIR9001 не глушить); хост тоді не інжектує. Джерело: команда 02, біт M[2].
S/PDIF OUT: SPDIF_F (FPGA 42) -> R28 -> J6 FCR684208T; R26/R27: 0.5 В на 75 Ом, вихідний опір 75 Ом; C29 без постійної -> J7 RCA. Той самий потік, що й на J3.
10. ТЕСТОВІ ТОЧКИ (стенд)
Під щуп на стенді: шини 3V3_AON і 5V_SW, земля. Лінії кільця без точок: відвід на їхніх фронтах
зайвий. RX_BUF - на виводі 4 U1, TX_SEL - на виводі 6 U2, TX_REGEN і RT_CLK - на U9 і на M1 (TX_FB).
11. ЛІНІЙНИЙ ВИХІД стерео J3 -> U15 PCM5102A -> J8 L, J9 R (RCA, 2.1 Вrms)
U15 PCM5102A, апаратний режим: FMT = 0 (I2S), FLT = 0 (звичайна затримка), DEMP = 0. SCK на землі: PLL бере такт з BCK (3 проводи, BCK = 64 Fs).
Вхід - те саме стерео, що на J3. XSMT = LOCK: без захоплення кільця і до конфігурації FPGA (R8) ЦАП приглушений; спад і підйом за 104 відліки.
Вихід 2.1 Вrms відносно землі, без розділових конденсаторів. U17: повторювач з ФНЧ Саллена-Кі 2-го порядку (Баттерворт, 60 кГц), C0G; далі 100 Ом + 2.2 нФ і D5, D6 (ESD) на RCA.
U17 живиться від +5V_SW і VNEG_A (-5.2 В, U18 TPS60403): вихід до шин, вхід до V-, тож +-3 В сигналу проходять з запасом. J8, J9 пад 3: як у J7, зміряти на зразку.
U16 LP5907: 3V3_DAC від 5V_SW. Ємність на його виході - до 10 мкФ, тому AVDD 4.7 мкФ і CPVDD 2.2 мкФ замість 10 мкФ з рис. 33.
На платі кожен конденсатор ряду стоїть біля свого виводу: C52, C53 - CPVDD; C54, C55 - AVDD; C56 - DVDD.
12. v2.0: ФІЛЬТРИ ЖИВЛЕННЯ U17, УЗГОДЖЕННЯ I2S ДО ЦАП І RX_IN
U17 (OPA1678) більше не живиться прямо від шин: V+ = 5V_A (5V_SW через R47 10 Ом, C84 10 мкФ; від 5V_A живиться й U16, LDO ЦАП), V- = VNEG_A (VNEG_P насоса U18 через R48 10 Ом, C85 10 мкФ).
RC 10 Ом / 10 мкФ: зріз 1.6 кГц, на 250 кГц (насос) і на частоті перетворювача близько 45 дБ; спад на R47 до 0.2 В (U17 + U16 з ЦАП), на R48 близько 50 мВ. Бусина з 10 мкФ дала б резонанс на десятках кГц.
R49-R51: 33 Ом біля FPGA на гілці I2S до ЦАП і ESP32 (BCLK, LRCK, DOUT: 35-45 мм, кілька навантажень; PCM5102A бере такт з BCLK). J3 має свої R39-R41.
R52: 33 Ом на виході U3 (RX_IN до FPGA, близько 60 мм).
R53: 33 Ом на виході U1 (RX_BUF до U2, U3, U4; через U2 і R2 - TX кільця), як R43 у рідері v2.0; стоїть у блоці 3.

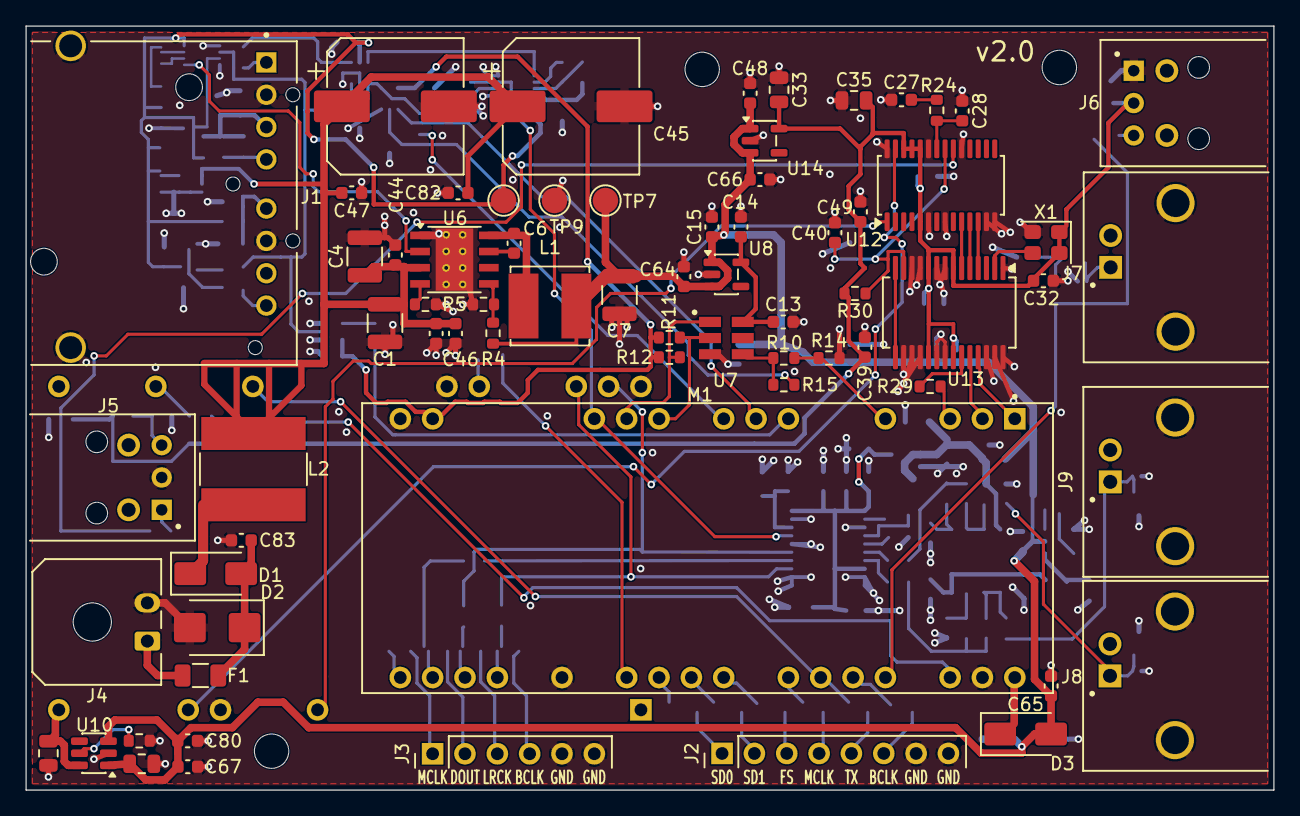
[picture p14: board most_listener_v2.kicad_pcb from above]

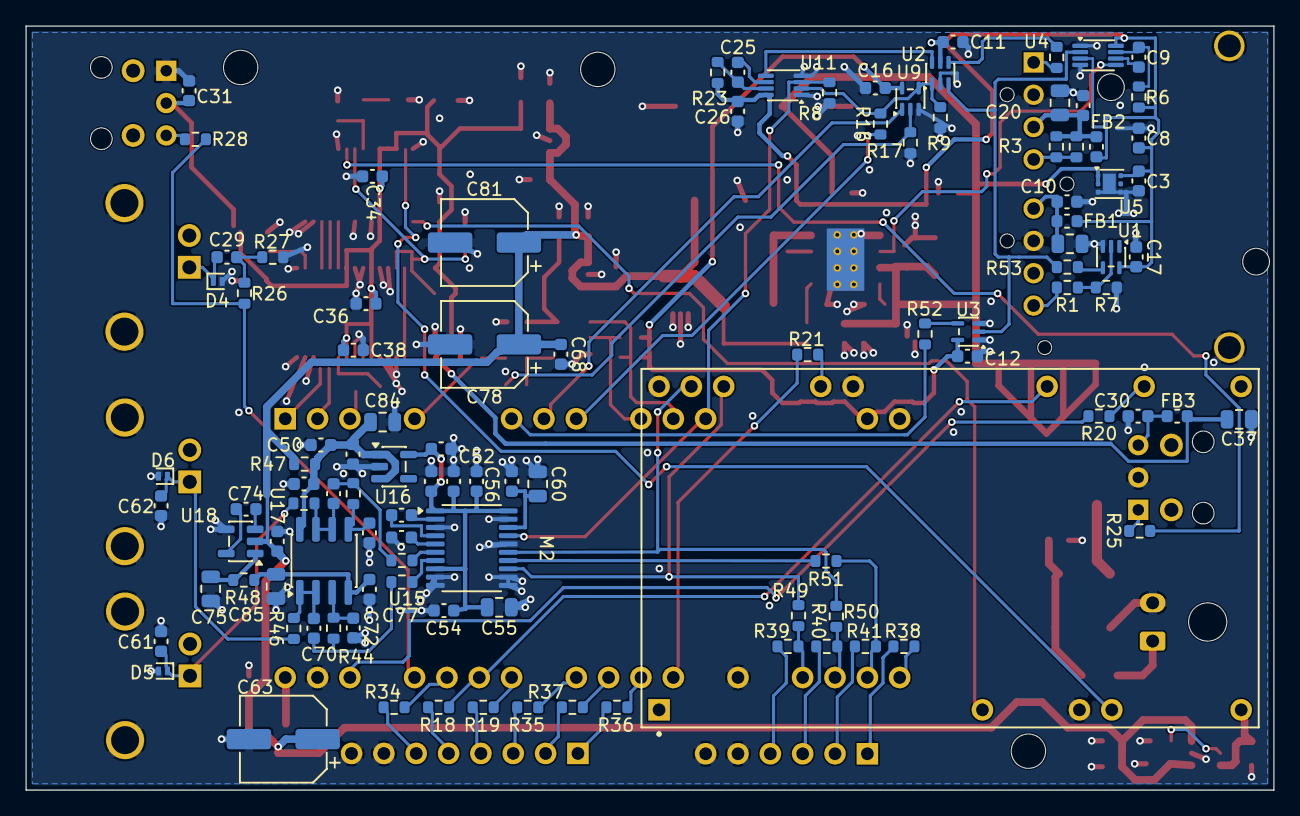
[picture p15: board most_listener_v2.kicad_pcb from below]

Board: 4 copper layers, 98.0 x 60.0 mm, 180 parts (107 on the bottom side), 111 nets.

Other parts of the board:
H1, H2, H3: MountingHole_2.7mm_M2.5
