Oleg-mk/MOST25-to-AUDIO/listener_fw/components/mostctl/include/sound.h

// sound.h - what the head unit tells the amplifier about the sound.
//
// Built only from telegrams on the bus. The MOST catalogue fixes the types
// (FBlock AudioAmplifier 2V4-3): Volume 0x400 TUByte (0 = mute, higher =
// louder), Balance 0x200, Bass 0x202, Treble 0x203 TSByte (balance: positive
// = to the left), Loudness 0x201 a switch; it leaves every range and every
// dB value to the application. Cars differ in where the volume is sent at
// all (docs/vehicle_survey.md, docs/control_commands.md):
//
//   source          telegram                          value
//   SND_VOL_46D     0x22.0x46D SpeakerLevel Set       byte 0 param, byte 1 sink, then
//                                                     signed dB per speaker (JLR AUD3,
//                                                     Freelander 2): the loudest is the volume
//   SND_VOL_BMW     0x20.0x200 VolumeActual           0..63 (BMW AudioMaster)
//   SND_VOL_F0      0xF0.0x409 Status, byte 2         raw 0..35, entertainment (Jaguar XF X250)
//   SND_VOL_STD     0x22.0x400 Volume                 raw (the catalogue)
//
// If a car sends more than one, the first in this list wins. Tone: 0x22
// 0x200/0x202/0x203/0x201, or BMW's AudioMaster 0x20 0x220/0x222/0x223.
// Fader (0x204, 0x221) is not used: J3 is stereo, front and rear are for
// whatever follows it.
//
// Jaguar XF's 0xF0.0x409 is the gateway's Status (as JLR-HU reads it). Byte 0
// is the record's kind: only kind 0, the whole record, is taken; kind 1
// repeats the level being changed without saying whose. Byte 2 is the volume;
// bytes 7, 9, 10 and 11 are the phone's, the navigation's, the voice's and the
// parking sensors' levels, each sent as the level + 5, the level 0..25. A Set
// to 0x409 is the screen changing one channel ([channel, 0, level + 5]) and is
// not taken. A byte counts only where the telegram's length covers it.
//
// The amplifier's other sinks - J3's streams 1..3 - play at the first of
// these a car sends, by SinkNr as Jaguar Land Rover numbers them (mObridge
// MOST25 DA Series Guide pp. 18-19: 1 main, 2 phone, navigation and voice,
// 3 parking sensors, 4 chimes):
//   0x22.0x46D SpeakerLevel to that sink      dB, the loudest speaker (JLR AUD3)
//   sink 4: chime_db                           fixed: the chimes never follow a
//                                              0x409 level or the volume, in any car
//   sink 3: 0xF0.0x409 byte 11                 the parking sensors (Jaguar XF)
//   sink 2: 0xF0.0x409 byte 9                  the navigation, the commonest on it
//                                              (Jaguar XF); the phone and the voice
//                                              are left to a SpeakerLevel
//   the volume
// Every sink follows the main balance. Whether an amplifier also turns the
// music down by itself while a prompt plays is not on the bus; J3 follows
// only what the head unit sends.
//
// The scales (raw volume -> dB, dB per tone and balance step) are not known
// for any car but JLR AUD3 (dB on the wire); snd_cfg_t holds them, and the
// defaults are placeholders until a car is recorded. Values are taken from
// Set, SetGet and Status alike (the amplifier answers a Set with Status), but
// 0x409 from its Status alone; Increment / Decrement carry a step count, not a
// value, and are left to that Status.
#pragma once

#include <stdint.h>

#include "most_msg.h"

enum { SND_VOL_46D, SND_VOL_BMW, SND_VOL_F0, SND_VOL_STD, SND_VOL_N };

#define SND_SINKS 8                 // levels kept for SinkNr 1..8
#define SND_JLR_NAV     2           // navigation, phone and voice's sink (mObridge, above)
#define SND_JLR_PDC     3           // the parking sensors' sink
#define SND_JLR_CHIMES  4           // the chimes' sink

typedef struct {
    uint8_t vol_max[SND_VOL_N];     // raw value at 0 dB, per source (46D: unused)
    uint8_t lvl_max;                // a 0x409 level (byte - 5) at 0 dB
    float   tone_db_step;           // bass and treble, dB per step
    float   tone_db_max;            // clamp, either way
    float   bal_db_step;            // the other side, dB per balance step
    int8_t  bal_mute_steps;         // from here on the other side is silent
    float   bass_hz, treble_hz;     // shelf corners
    float   loud_db_max;            // loudness: bass boost at the quietest
    float   loud_db_at;             // ...reached at this volume (dB), 0 at 0 dB
    float   chime_db;               // sink 4 without a SpeakerLevel of its own
} snd_cfg_t;

extern const snd_cfg_t snd_cfg_default;

// What has been heard. `have` bits say what has been heard at all.
typedef struct {
    uint8_t have;                   // SND_H_* bits
    uint8_t vol_have;               // bit per source
    float   vol_db[SND_VOL_N];      // per source; -inf / below -120 = silent
    int8_t  balance, bass, treble;  // steps, as sent
    uint8_t loudness;
    // per sink, index SinkNr - 1, bit SinkNr - 1
    uint8_t spk_have;               // SpeakerLevel to that sink (2 and up)
    float   spk_db[SND_SINKS];      // ...its loudest speaker, dB
    uint8_t annc_have;              // Jaguar XF's navigation level (0x409 byte 9)
    float   annc_db;                // ...dB
    uint8_t park_have;              // Jaguar XF's parking sensor level (0x409 byte 11)
    float   park_db;                // ...dB
} snd_t;

#define SND_H_BAL    0x01
#define SND_H_BASS   0x02
#define SND_H_TREBLE 0x04
#define SND_H_LOUD   0x08

#define SND_SILENT   (-200.0f)

void snd_init(snd_t *s);

// Feed a telegram. Returns 1 if anything changed.
int snd_tel(snd_t *s, const snd_cfg_t *cfg, const mm_tel_t *t);

// The volume in dB from the best source heard; SND_SILENT if none, or if
// the best one says silence.
float snd_volume_db(const snd_t *s);

// The level a sink plays at, dB: sink 1 at the volume; another at its own
// SpeakerLevel, else sink 4 at chime_db, sink 3 at Jaguar XF's parking sensor
// level, sink 2 at Jaguar XF's navigation level, else the volume. SND_SILENT
// if silent or nothing is known (the chimes excepted: they need nothing heard).
float snd_sink_db(const snd_t *s, const snd_cfg_t *cfg, int sink);

// The balance every sink follows, in steps; 0 until one is heard.
int snd_balance(const snd_t *s);

// raw -> dB on the default curve: 0 = silence, else 40 log10(raw / max),
// i.e. amplitude as the square of the knob (half way is -12 dB)
float snd_curve_db(int raw, int max);
