Oleg-mk/MOST25-to-AUDIO/listener_gw/sim/tb_core.v

// tb_core.v - the whole listener_core against a behavioural Si514 (sim/
// si514_model.v) on its I2C bus. The Si514's frequency drives clk_r; our own
// TX is sampled back at 792 Msps into fb_samp, as the board's loopback does.
// The loop runs with short simulation parameters (8-frame rate measurement,
// an update every 4 frames, fn 150/30 Hz) so it locks within the stimulus; the
// real parameters are proven over hundreds of ms by tb_dpll.v / run_dpll.py.
// The gear shift's threshold is a sum of 4 errors here against 24 in the real
// loop: for the same measurement noise, 8 (the real 48 scaled by 4/24) is
// 2.5x as strict, and whether the shift came within the 5 ms stimulus once
// depended on the first error sums. 16 is the real strictness.
// Everything observable is logged for check_core.py.
`timescale 1ns/1ps
module tb_core;
    parameter MAXCLK = 700000;
    parameter [6:0] SI_ADDR = 7'h6A;                 // the model's I2C address: not 0x55, the core must find it
    parameter real  SI_PPM  = 0.0;                   // the model's own crystal error
    parameter real  SI_START_HZ = 49.152e6;          // the model's factory start-up frequency
    parameter       INJ_EARLY = 0;                   // 1: "inject" sent before the Si514 is centred
    parameter       NO_INJECT = 0;                   // 1: never inject (the line must stay as it came)
    parameter       FADE_LOG2 = 0;                   // the injector's fades: 2^FADE_LOG2 frames (0: one step)
    parameter       FADE_TEST = 0;                   // 1: inject DIN, switch to DIN2, off - long enough for full fades
    parameter       CAPTURE = 0;                     // 1: dump the power-up capture, then capture and dump anew
    parameter       LEASE_TEST = 0;                  // 1: "inject" once, never repeated and never "off"
    parameter       INJ_LEASE = 198000000;           // the injector's lease in clk_s (inject.v; real: 2 s)
    parameter real  GAP_AFTER_LOCK_US = -1.0;        // > 0: the line dies this long after LOCK...
    parameter real  GAP_US  = 20.0;                  // ...for this long (logged in out_gap.txt)
    parameter real  FB_DEAD_AFTER_LOCK_US = -1.0;    // > 0: TX_FB dies this long after LOCK, for good
                                                     // (U9 stuck; logged in out_fbdead.txt)
    parameter real  CLKS_STOP_AFTER_LOCK_US = -1.0;  // > 0: clk_s stops this long after LOCK and
                                                     // the run ends 200 us later (out_clkstop.txt)
    parameter real  WD_TW_NS = 10000.0;              // the board's bypass watchdog U11 (R23 x C25)
    parameter real  SI_OFF_AFTER_LOCK_US = -1.0;     // > 0: the Si514's supply goes this long after LOCK
    parameter real  SI_OFF_US = 1000.0;              // (5V_SW off, the module on USB) for this long, and
                                                     // it comes back at SI_START_HZ (out_sioff.txt)
    parameter [17:0] SI_LOST = 18'd20000;            // the core's SI_LOST (202 us; 0 = never: mutation)
    // 99 MHz exactly: the stimulus is 8 samples per clock at 792 Msps, and the
    // Si514 model runs in real time, so a clock off by 100 ppm (#5.05) would
    // move the ring by 100 ppm against clk_r. Each edge is placed at its exact
    // time and rounded to 1 ps on its own, so the error never accumulates.
    reg clk_s = 0, rst = 1;
    reg clks_run = 1'b1;                             // 0: the PLL or its crystal has died
    real t_s = 0.0;
    always begin
        t_s = t_s + 500.0 / 99.0;
        #(t_s - $realtime) if (clks_run) clk_s = ~clk_s;
    end

    reg [7:0] mem [0:MAXCLK-1];
    integer nclk, i;
    reg [7:0] samp = 0;

    // ------------------------------------------------ frame-rate output (kept for boards
    // with an external clock multiplier): each clk_s word of fs_word covers the next
    // clk_s period, bit i at i x 1.26 ns; the edges are logged in sample units
    wire [7:0] fs_word; wire fs_late;
    integer ffs, fsn = 0;
    reg fs_last = 1'b0;
    always @(negedge clk_s) begin : fs_rebuild
        integer k;
        for (k = 0; k < 8; k = k + 1) begin
            if (fs_word[k] !== fs_last) begin
                $fwrite(ffs, "%0d %0d\n", fsn * 8 + k, fs_word[k]);
                fs_last = fs_word[k];
            end
        end
        fsn = fsn + 1;
    end

    // ------------------------------------------------ Si514 on the I2C bus
    wire scl_o, sda_o, sda_low;
    wire scl = scl_o;
    wire sda = sda_o & ~sda_low;
    si514_model #(.ADDR(SI_ADDR), .DSI_PPM(SI_PPM), .FCAL_NS(15000.0), .SETTLE_NS(2000.0),
                  .START_HZ(SI_START_HZ))
        u_dev (.scl(scl), .sda(sda), .sda_low(sda_low));
    // clk_r from the model's frequency. Each edge is scheduled at an exact
    // real time; only the individual delay is rounded to the 1 ps time step,
    // so the rounding never accumulates (a plain #(half period) would round
    // the period itself and allow the frequency only in ~100 ppm steps).
    reg clk_r = 0, r_run = 0;
    real t_edge = 0.0;
    always begin
        if (u_dev.freq > 0.0) begin
            if (!r_run) begin t_edge = $realtime; r_run = 1; end   // (re)start only
            t_edge = t_edge + 0.5e9 / u_dev.freq;
            #(t_edge - $realtime) clk_r = ~clk_r;
        end else begin
            r_run = 0; clk_r = 0; #10;
        end
    end

    // ------------------------------------------------ TX loopback, 8 samples per clk_s
    wire tx;
    reg [7:0] fb_samp = 0, fb_acc = 0;
    // eight samples 1.26 ns apart; no delay after the last, or the block
    // would outlast the clock period (1 ps rounding) and miss the next edge.
    // The word handed to the FPGA is the previous period's complete one.
    always @(posedge clk_s) begin : fb_sample
        integer k;
        fb_samp <= fb_acc;
        for (k = 0; k < 8; k = k + 1) begin
            if (k) #(1000.0 / 792.0);
            fb_acc[k] = (tx === 1'b1);
        end
    end

    // ---------------------------------------------------------------- DUT
    wire lock, bclk, fs, sd0, sd1, utx, mclk; wire [7:0] status;
    wire ibclk, ilrck, isd, injact, spdif;
    reg  urx = 1'b1;                                 // host command line, idle high
    reg  idin = 1'b0;                                // audio in, from the DSP model
    reg  idin2 = 1'b0;                               // audio in 2 (the S/PDIF receiver's place)
    listener_core #(.HOLD(8), .HOLD_RE(24), .SI_QDIV(4), .SI_FCAL(24'd2000), .INJ_FADE_LOG2(FADE_LOG2),
                    .INJ_LEASE(INJ_LEASE), .SI_LOST(SI_LOST),
                    .L_FRAMES(8), .LN48(22'd132000), .LN44(22'd143673), .LSPLIT(22'd137836),
                    .LDEV(22'd175), .K48(20'd275050), .K44(20'd253277),
                    .UPD(4), .LOCK_N(4), .SHIFT_ACC(16), .LOCK_ACC(32), .UNLOCK_ACC(256),
                    .KP_A(40'sd5530205), .KI_A(40'sd217171),
                    .KP_T(40'sd1106041), .KI_T(40'sd8687), .CAP_AW(9)) dut (
        .clk_s(clk_s), .rst_s(rst), .samp(samp), .fb_samp(fb_samp), .clk_r(clk_r),
        .fs_word(fs_word), .fs_late(fs_late), .tx_regen(tx), .lock(lock),
        .tdm_bclk(bclk), .tdm_fs(fs), .tdm_sd0(sd0), .tdm_sd1(sd1), .uart_tx(utx), .mclk(mclk),
        .uart_rx(urx), .i2s_bclk(ibclk), .i2s_lrck(ilrck), .i2s_dout(isd),
        .i2s_din(idin), .i2s_din2(idin2), .spdif(spdif), .inj_active(injact),
        .i2c_scl_o(scl_o), .i2c_sda_o(sda_o), .i2c_sda_i(sda), .status(status));

    // ------------------------------------------------------------ loggers
    integer ftx, ftdm, fua, flk, fsi;
    // the ring domain must not move before the Si514 is centred: first edges of
    // its outputs against the moment the loop reports the centring
    real t_cen = -1.0, t_mclk1 = -1.0, t_bclk1 = -1.0;
    always @(posedge dut.u_pll.centred) if (t_cen < 0.0) t_cen = $realtime;
    always @(posedge mclk) if (t_mclk1 < 0.0) t_mclk1 = $realtime;
    always @(posedge bclk) if (t_bclk1 < 0.0) t_bclk1 = $realtime;

    // The board's bypass watchdog U11 (74LVC1G123): retriggered by TX's rising
    // edges (TX_REGEN), cleared by LOCK; its Q, TX_SEL, is U2's select.
    // Modelled at 50 ns: TX_SEL = LOCK and a rising edge within WD_TW_NS.
    real t_rise = -1.0e12;
    reg  tx_sel = 1'b0;
    integer sel_drops = 0;                           // falls while LOCK stayed on and clk_s ran
    always @(posedge tx) t_rise = $realtime;
    always #50 begin
        if (tx_sel && lock && ($realtime - t_rise >= WD_TW_NS) && clks_run) sel_drops = sel_drops + 1;
        tx_sel = lock && ($realtime - t_rise < WD_TW_NS);
    end
    // clk_s stops for good after LOCK: LOCK, a clk_s register, stays where it
    // is - only the watchdog can take the ring back to bypass
    integer fcs, kw;
    real    t_stop;
    initial if (CLKS_STOP_AFTER_LOCK_US > 0.0) begin
        @(posedge lock);
        #(CLKS_STOP_AFTER_LOCK_US * 1000.0);
        clks_run = 1'b0; t_stop = $realtime;
        for (kw = 0; kw < 4000 && tx_sel; kw = kw + 1) #50;          // up to 200 us
        #1000;
        fcs = $fopen("out_clkstop.txt", "w");
        // stop, TX's last rising edge, TX_SEL's fall (ns); TX_SEL and LOCK now; false drops before
        $fwrite(fcs, "%0.3f %0.3f %0.3f %0d %0d %0d\n", t_stop, t_rise,
                t_stop + 50.0 * kw, tx_sel, lock, sel_drops);
        $fclose(fcs);
        $finish;
    end
    // TX feedback lost after LOCK: what the FPGA sees if U9's output sticks
    integer ffb;
    initial if (FB_DEAD_AFTER_LOCK_US > 0.0) begin
        @(posedge lock);
        #(FB_DEAD_AFTER_LOCK_US * 1000.0);
        @(negedge clk_s);
        force fb_samp = 8'h00;
        ffb = $fopen("out_fbdead.txt", "w");
        $fwrite(ffb, "%0.3f\n", $realtime);                  // ns
        $fclose(ffb);
    end
    // a dead line placed after LOCK, wherever LOCK happens to come
    integer fgap;
    real    tg0;
    initial if (GAP_AFTER_LOCK_US > 0.0) begin
        @(posedge lock);
        #(GAP_AFTER_LOCK_US * 1000.0);
        @(negedge clk_s);
        force samp = 8'h00; tg0 = $realtime;
        #(GAP_US * 1000.0);
        @(negedge clk_s);
        release samp;
        fgap = $fopen("out_gap.txt", "w");
        $fwrite(fgap, "%0.3f %0.3f\n", tg0, $realtime);      // ns
        $fclose(fgap);
    end
    // The Si514's supply lost after LOCK and back SI_OFF_US later. Every line built in
    // clk_r must be low 2 us after its clock stopped and stay low; while the core has
    // the part lost, the I2C lines and the UART must stay low; back at its factory
    // frequency, the part must be centred anew before the ring domain moves, and
    // LOCK must come back.
    real    t_off = -1.0, t_on = -1.0, t_lost = -1.0, t_cen2 = -1.0, t_mclk_on = -1.0, t_bclk_on = -1.0;
    reg [8:0] pads_a = 9'h1FF, pads_b = 9'h1FF;      // TDM BCLK FS SD0 SD1, MCLK, I2S BCLK LRCK DOUT, S/PDIF
    reg [3:0] held = 4'hF;                           // si_lost, SCL, SDA, UART just before the supply returns
    integer n_pad_up = 0, n_held_up = 0;
    always @(posedge dut.si_lost) if (t_lost < 0.0) t_lost = $realtime;
    always @(posedge dut.u_pll.centred) if (t_on > 0.0 && t_cen2 < 0.0) t_cen2 = $realtime;
    always @(posedge mclk) if (t_on > 0.0 && t_mclk_on < 0.0) t_mclk_on = $realtime;
    always @(posedge bclk) if (t_on > 0.0 && t_bclk_on < 0.0) t_bclk_on = $realtime;
    always @(posedge bclk or posedge fs or posedge sd0 or posedge sd1 or posedge mclk or posedge ibclk
             or posedge ilrck or posedge isd or posedge spdif)
        if (t_off > 0.0 && t_on < 0.0 && $realtime > t_off + 2000.0) n_pad_up = n_pad_up + 1;
    always @(posedge scl_o or posedge sda_o or posedge utx) if (dut.si_lost) n_held_up = n_held_up + 1;
    initial if (SI_OFF_AFTER_LOCK_US > 0.0) begin
        @(posedge lock);
        #(SI_OFF_AFTER_LOCK_US * 1000.0);
        u_dev.power(1'b0); t_off = $realtime;
        #2000;
        pads_a = {bclk, fs, sd0, sd1, mclk, ibclk, ilrck, isd, spdif};
        #(SI_OFF_US * 1000.0 - 3000.0);
        pads_b = {bclk, fs, sd0, sd1, mclk, ibclk, ilrck, isd, spdif};
        held = {dut.si_lost, scl_o, sda_o, utx};
        #1000;
        u_dev.power(1'b1); t_on = $realtime;
    end

    reg tx_d = 0; integer run = 0;
    always @(posedge clk_r) begin                    // regenerated runs, in clk_r cycles
        run = run + 1;
        if (tx !== tx_d) begin
            if (lock) $fwrite(ftx, "%0d\n", run);
            run = 0; tx_d = tx;
        end
    end
    // TDM rows carry LOCK: before it the clock may still stop (Si514 centring)
    always @(posedge bclk) $fwrite(ftdm, "%0d%0d%0d%0d\n", fs, sd0, sd1, lock);
    // MCLK periods per TDM frame (FS rising edge to FS rising edge), and LOCK
    integer fmc, nmc = 0; reg fs_d = 0;
    always @(posedge mclk) nmc = nmc + 1;
    always @(posedge bclk) begin
        if (fs && !fs_d) begin $fwrite(fmc, "%0d %0d\n", nmc, lock); nmc = 0; end
        fs_d = fs;
    end
    // I2S: LRCK and data at every rising BCLK
    integer fi2s, fcfg;
    always @(posedge ibclk) $fwrite(fi2s, "%0d%0d\n", ilrck, isd);
    // S/PDIF: the level of every half-cell, one line per frame (the encoder's
    // tick and half-cell index read before the edge, the line after it)
    integer fsp; reg sp_t; reg [6:0] sp_h;
    always @(posedge clk_r) begin
        sp_t = dut.u_amp.u_sp.tick; sp_h = dut.u_amp.u_sp.h;
        #1;
        if (sp_t) begin
            if (sp_h == 7'd0) $fwrite(fsp, "\n");
            $fwrite(fsp, "%0d", spdif);
        end
    end

    // host commands, 8N1 at 3 Mbaud = 33 clk_s per bit
    task send_byte(input [7:0] b);
        integer j;
        begin
            urx = 1'b0; repeat (33) @(posedge clk_s);
            for (j = 0; j < 8; j = j + 1) begin urx = b[j]; repeat (33) @(posedge clk_s); end
            urx = 1'b1; repeat (40) @(posedge clk_s);
        end
    endtask
    task send_cmd(input [7:0] c, w, l0, l1, l2, r0, r1, r2, input bad);
        reg [7:0] x;
        begin
            x = 8'hA5 ^ 8'h5A ^ c ^ w ^ l0 ^ l1 ^ l2 ^ r0 ^ r1 ^ r2;
            send_byte(8'hA5); send_byte(8'h5A); send_byte(c); send_byte(w);
            send_byte(l0); send_byte(l1); send_byte(l2);
            send_byte(r0); send_byte(r1); send_byte(r2);
            send_byte(bad ? ~x : x);
            $fwrite(fcfg, "%0d %0d %0d %0d %0d %0d %0d %0d %0d %0d\n", $time, c, bad, w, l0, l1, l2, r0, r1, r2);
        end
    endtask
    // J3's coefficient map as amp_out has it (DSP_C_IMAGE: the words of a set)
`include "dsp_map.vh"
    // one coefficient word for amp_out (command 03) of the set tagged t; commit with the last one
    integer wi;
    task send_word(input [7:0] a, input [31:0] v, input commit, input [7:0] t);
        send_cmd(8'h03, a, v[31:24], v[23:16], v[15:8], v[7:0], {7'd0, commit}, t, 1'b0);
    endtask

    // DSP model on the audio input: an I2S slave on our BCLK/LRCK, sending
    // L = 5A nnnn, R = C3 (nnnn + 1234) (24 bit), n + 1 every frame; the
    // changed bits' XOR then varies from frame to frame, so parity is exercised.
    // It goes into bytes 1..6, the bytes J3's two configurations pick from, so
    // that J3 and TDM are seen to carry the frame as it left us. DIN2 carries
    // L = 3C nnnn, R = A5 (nnnn + 4321) on the same n, so a switch shows which
    // source every frame came from
    integer slot = 0; reg lr_d = 1'b0; reg [15:0] cnt = 16'd0;
    reg [23:0] dl = 24'd0, dr = 24'd0, dl2 = 24'd0, dr2 = 24'd0;
    always @(negedge ibclk) begin
        #1;
        if (!ilrck && lr_d) begin
            slot = 0; cnt = cnt + 16'd1;
            dl = {8'h5A, cnt}; dr = {8'hC3, cnt + 16'h1234};
            dl2 = {8'h3C, cnt}; dr2 = {8'hA5, cnt + 16'h4321};
        end else slot = slot + 1;
        lr_d = ilrck;
        if (slot >= 1 && slot <= 24)       begin idin = dl[24 - slot]; idin2 = dl2[24 - slot]; end
        else if (slot >= 33 && slot <= 56) begin idin = dr[56 - slot]; idin2 = dr2[56 - slot]; end
        else                               begin idin = 1'b0; idin2 = 1'b0; end
    end
    initial begin
        #1;
        @(negedge rst);
        if (INJ_EARLY) begin                                        // before the Si514 is centred:
            repeat (3000) @(posedge clk_s);                         // the ring domain is reset under it
            send_cmd(8'h02, 8'd3, 8'd1, 8'd2, 8'd3, 8'd4, 8'd5, 8'd6, 1'b0);
        end
        @(posedge lock);                                            // the loop has locked
        repeat (2000) @(posedge clk_s);
        // J3's coefficients (map: sim/dsp_asm.py), the whole set of DSP_C_IMAGE
        // (49) words under one tag, as amp_out switches only on a whole set:
        // every biquad straight through (b0 = 1.0 at 0, 5, .. 35, the rest 0),
        // stream 0 to L x 1 and R x 0.5, the other streams off, gains at once
        // (1 - k = 0 in the last word, with the commit)
        for (wi = 0; wi < DSP_C_IMAGE - 1; wi = wi + 1)                            // not i: it feeds samp
            send_word(wi, (wi < 40 && wi % 5 == 0) || wi == 40 ? 32'h1000_0000 :
                          wi == 41 ? 32'h0800_0000 : 32'h0000_0000, 1'b0, 8'd1);
        send_word(DSP_C_IMAGE - 1, 32'h0000_0000, 1'b1, 8'd1);
        send_cmd(8'h01, 8'd3, 8'd4, 8'd1, 8'd3, 8'd2, 8'd4, 8'd1, 1'b1);   // wrong XOR: must be ignored
        send_cmd(8'h01, 8'd3, 8'd3, 8'd4, 8'd1, 8'd2, 8'd1, 8'd4, 1'b0);   // A: 24 bit, scrambled
        repeat (50000) @(posedge clk_s);
        if (FADE_TEST) begin
            // DIN until well past the rise (256 frames at 48 kHz = 5.3 ms), then
            // DIN2: down, the switch, up again; then off, down to the ring's line
            send_cmd(8'h02, 8'd3, 8'd1, 8'd2, 8'd3, 8'd4, 8'd5, 8'd6, 1'b0);
            repeat (620000) @(posedge clk_s);
            send_cmd(8'h02, 8'd7, 8'd1, 8'd2, 8'd3, 8'd4, 8'd5, 8'd6, 1'b0);
            repeat (600000) @(posedge clk_s);
            send_cmd(8'h01, 8'd2, 8'd1, 8'd2, 8'd0, 8'd3, 8'd4, 8'd0, 1'b0);   // B: J3 16 bit, bytes 1..4
            repeat (556000) @(posedge clk_s);
            send_cmd(8'h02, 8'd0, 8'd0, 8'd0, 8'd0, 8'd0, 8'd0, 8'd0, 1'b0);
        end else if (LEASE_TEST) begin
            // once, then nothing: the lease must end it as an "off" would
            send_cmd(8'h02, 8'd3, 8'd1, 8'd2, 8'd3, 8'd4, 8'd5, 8'd6, 1'b0);
        end else begin
            if (!INJ_EARLY && !NO_INJECT) begin
`ifdef NOFIX
                send_cmd(8'h02, 8'h83, 8'd1, 8'd2, 8'd3, 8'd4, 8'd5, 8'd6, 1'b0);   // (mutation: parity not fixed)
`else
                send_cmd(8'h02, 8'd3, 8'd1, 8'd2, 8'd3, 8'd4, 8'd5, 8'd6, 1'b0);    // inject 24 bit into 1..6
`endif
            end
            repeat (20000) @(posedge clk_s);
            send_cmd(8'h02, 8'd3, 8'd11, 8'd12, 8'd61, 8'd14, 8'd15, 8'd16, 1'b0); // names byte 61: refused
            repeat (20000) @(posedge clk_s);
            send_cmd(8'h01, 8'd2, 8'd1, 8'd2, 8'd0, 8'd3, 8'd4, 8'd0, 1'b0);   // B: 16 bit, bytes 1..4
            repeat (20000) @(posedge clk_s);
            send_cmd(8'h02, 8'd0, 8'd0, 8'd0, 8'd0, 8'd0, 8'd0, 8'd0, 1'b0);   // injection off
        end
        if (CAPTURE) begin
            repeat (100000) @(posedge clk_s);
            send_cmd(8'h04, 8'd2, 8'd0, 8'd0, 8'd0, 8'd0, 8'd0, 8'd0, 1'b0);   // dump the power-up capture
            repeat (650000) @(posedge clk_s);                                  // 16 packets + trailer, one per block
            send_cmd(8'h04, 8'd5, 8'd0, 8'd0, 8'd0, 8'd0, 8'd0, 8'd0, 1'b0);   // capture anew, dump when full
        end
    end

    reg u_d = 1;
    always @(utx) begin $fwrite(fua, "%0t %0d\n", $time, utx); end
    reg lk_d = 0;
    always @(posedge clk_s) if (lock !== lk_d) begin $fwrite(flk, "%0t lock=%0d status=%b\n", $time, lock, status); lk_d = lock; end

    initial begin
        for (i = 0; i < MAXCLK; i = i + 1) mem[i] = 8'hxx;
        $readmemh("samples.hex", mem);
        nclk = 0;
        while (nclk < MAXCLK && mem[nclk] !== 8'hxx) nclk = nclk + 1;
        ftx = $fopen("out_tx.txt", "w"); ftdm = $fopen("out_tdm.txt", "w");
        fua = $fopen("out_uart.txt", "w");
        flk = $fopen("out_lock.txt", "w"); fmc = $fopen("out_mclk.txt", "w");
        fi2s = $fopen("out_i2s.txt", "w"); fcfg = $fopen("out_cfg.txt", "w");
        fsp = $fopen("out_spdif.txt", "w");
        ffs = $fopen("out_fs.txt", "w");
        repeat (4) @(posedge clk_s);
        rst = 0;
        for (i = 0; i < nclk; i = i + 1) @(negedge clk_s) samp = mem[i];
        @(negedge clk_s) samp = {8{mem[nclk-1][7]}};
        repeat (200) @(posedge clk_s);
        $display("clocks=%0d status=%b lock=%0d fs_late=%0d", nclk, status, lock, fs_late);
        $fclose(ftx); $fclose(ftdm); $fclose(fua); $fclose(flk); $fclose(fmc); $fclose(fi2s); $fclose(fcfg);
        $fclose(fsp);
        fsi = $fopen("out_si514.txt", "w");
        $fwrite(fsi, "addr %0h found %0h probes %0d fcal %0d small %0d bad_small %0d bad_rmw %0d nack %0d hs %0d freq %0.3f reg132 %0h centred %0.3f first_mclk %0.3f first_bclk %0.3f start_hz %0.1f\n",
                SI_ADDR, dut.u_si.addr, u_dev.n_probe,
                u_dev.n_fcal, u_dev.n_small, u_dev.bad_small, u_dev.bad_rmw, u_dev.n_nack,
                {u_dev.regs[11][1:0], u_dev.regs[10]}, u_dev.freq, u_dev.regs[132],
                t_cen, t_mclk1, t_bclk1, SI_START_HZ);
        $fclose(fsi);
        $fwrite(ffs, "late %0d\n", fs_late); $fclose(ffs);
        if (SI_OFF_AFTER_LOCK_US > 0.0) begin
            fcs = $fopen("out_sioff.txt", "w");
            // ns: supply off, lost, back, centred again, first MCLK and BCLK after;
            // the lines 2 us after and just before, the held ones, rising edges where none may be
            $fwrite(fcs, "%0.3f %0.3f %0.3f %0.3f %0.3f %0.3f %b %b %b %0d %0d\n", t_off, t_lost, t_on,
                    t_cen2, t_mclk_on, t_bclk_on, pads_a, pads_b, held, n_pad_up, n_held_up);
            $fclose(fcs);
        end
        fcs = $fopen("out_wd.txt", "w");                  // the watchdog model over the whole run
        $fwrite(fcs, "%0d\n", sel_drops); $fclose(fcs);
        $finish;
    end
endmodule
