Oleg-mk/MOST25-to-AUDIO/listener_gw/sim/check_core.py

#!/usr/bin/env python3
"""check_core.py - verify every output of listener_core against the stimulus.

  SI    the Si514 model was driven as its data sheet requires and clk_r ended
        up at 1024 x the ring's Fs; LOCK switched on
  TX    after LOCK, every regenerated run (in clk_r cycles = UI) equals the
        ring's run - the ring must not see a single wrong edge
  TDM   under LOCK every TDM frame equals the MOST frame as it left the
        listener (our injected bytes in place of the ring's), byte for byte,
        and the frames follow each other without a gap
  MCLK  under LOCK exactly 512 periods per TDM frame (512 Fs, locked to the ring)
  UART  every packet has the sync, a correct XOR, and control bytes equal to
        bytes 61, 62 of 16 consecutive ring frames starting on a block start
  I2S   after each host command (UART_RX), every I2S frame holds exactly the
        commanded bytes of consecutive ring frames as they left the listener
        (injected bytes included); a wrong-XOR command is ignored
  FS    the frame-rate output to the clock multiplier: every edge at a constant
        offset from the ring's own frame edge, to the sample (1.26 ns)
  INJ   the regenerated line, decoded: frames unchanged before and after
        injection, and while injecting only the chosen bytes carry the audio
        in - each pair exactly the source's times the fade's gain, the gain
        stepping as inject.v says - with the parity XOR kept
Exit 0 only if all of them hold.
"""
import json
import sys

import spdif_dec
from pathlib import Path

BIT_NS = 1e9 / 3e6 * 1.0          # UART bit time: 33 clk_s at 99 MHz = 333.33 ns
BIT_NS = 33 * (1e3 / 99.0)


def check_si514(d):
    """The clock loop drove the Si514 model as the data sheet requires, and the
    ring clock ended up on the ring: the model's I2C address (not the data
    sheet's example) found by one scan - every lower address probed once,
    nothing addressed wrongly after it; exactly one centring (FCAL), no small
    change outside +/-1000 ppm of the calibrated centre, reg 132's reserved
    bit kept (read-modify-write) and the output on, HS_DIV for the ring's
    rate, the final frequency 1024 x Fs of the ring within 20 ppm, and LOCK
    switched on. Nothing in the ring domain moves before the centring: MCLK's
    and BCLK's first edges come after the loop reports it, whatever frequency
    the part started at (tb SI_START_HZ)."""
    import json
    meta = json.loads((d / "meta.json").read_text())
    w = (d / "out_si514.txt").read_text().split()
    kv = dict(zip(w[0::2], w[1::2]))
    want_hs = 44 if meta["fs"] == 48000 else 48
    want_f = 1024 * meta["fs"] * (1 + meta.get("ppm", 0.0) * 1e-6)
    f = float(kv["freq"])
    ppm = (f / want_f - 1) * 1e6
    reg132 = int(kv["reg132"], 16)
    locked = "lock=1" in (d / "out_lock.txt").read_text()
    addr, found, probes = int(kv["addr"], 16), int(kv["found"], 16), int(kv["probes"])
    t_cen, t_mclk, t_bclk = float(kv["centred"]), float(kv["first_mclk"]), float(kv["first_bclk"])
    quiet = t_cen > 0 and t_mclk >= t_cen and t_bclk >= t_cen
    ok = (found == addr and probes == addr - 0x08
          and int(kv["fcal"]) == 1 and int(kv["bad_small"]) == 0 and int(kv["bad_rmw"]) == 0
          and int(kv["nack"]) == 0 and int(kv["hs"]) == want_hs and abs(ppm) < 20
          and reg132 & 0x84 == 0x84 and locked and quiet)
    print(f"SI  : {'PASS' if ok else 'FAIL'}  address 0x{found:02x} found for 0x{addr:02x} after "
          f"{probes} probes, fcal {kv['fcal']}, {kv['small']} small changes "
          f"(outside window {kv['bad_small']}), reserved bit lost {kv['bad_rmw']}, nack {kv['nack']}, "
          f"HS_DIV {kv['hs']} (want {want_hs}), clk_r {f / 1e6:.6f} MHz = ring {ppm:+.2f} ppm, "
          f"reg132 {reg132:02x}, LOCK {'on' if locked else 'NEVER'}; started at "
          f"{float(kv['start_hz']) / 1e6:.3f} MHz, centred at {t_cen / 1e6:.2f} ms, first MCLK edge "
          f"{(t_mclk - t_cen) / 1e3:+.1f} us and first BCLK edge {(t_bclk - t_cen) / 1e3:+.1f} us after it")
    return ok


def inject_before_lock(d):
    """True if the tb sent "inject on" before LOCK came up (INJ_EARLY)."""
    lock_ps = next((int(l.split()[0]) for l in (d / "out_lock.txt").read_text().splitlines()
                    if l.split()[1] == "lock=1"), None)
    for l in (d / "out_cfg.txt").read_text().splitlines():
        t, c, bad, w = map(int, l.split()[:4])
        if c == 2 and not bad and w != 0 and lock_ps is not None and t * 1000 < lock_ps:
            return True
    return False


def align(seg, runs):
    """Where seg sits in the ring's runs - only if it sits there alone. A short
    window can match in several places: a frame's zero bytes are long rows of
    identical 2-UI runs. The window grows until exactly one place matches;
    None if none does, or none is unique even at 4000 runs."""
    n = 400
    while n <= min(4000, len(seg)):
        probe = seg[:n]
        head = probe[:16]
        hits = [s for s in range(len(runs) - n + 1)
                if runs[s:s + 16] == head and runs[s:s + n] == probe]
        if len(hits) == 1:
            return hits[0]
        if not hits:
            return None
        n *= 2
    return None


def check_tx(d, runs):
    """Until the host turns injection on, the ring must get its own runs back,
    every one. The first run that differs must lie inside an injected frame -
    check_inject proves what is sent from there on. If injection was already
    on when LOCK came up (the command went in before the Si514 was centred),
    the same is checked from the other end: after injection is turned off,
    every run is the ring's again."""
    tx = [int(x) for x in (d / "out_tx.txt").read_text().split()][1:]   # first is partial
    if len(tx) < 1000:
        print(f"TX  : FAIL  only {len(tx)} regenerated runs after LOCK")
        return False
    if inject_before_lock(d):
        body = tx[:-1]                                    # the last run may be cut
        seg = body[-4000:]
        s = align(seg, runs)
        if s is None:
            print("TX  : FAIL  the regenerated runs after injection never line up with the ring's")
            return False
        off = s - (len(body) - len(seg))                  # runs[k + off] belongs to body[k]
        k = len(body) - 1
        while k >= 0 and k + off >= 0 and body[k] == runs[k + off]:
            k -= 1
        tail = len(body) - 1 - k
        bad = [r for r in tx if r not in (1, 2, 3)]
        ok = tail >= 1000 and not bad
        print(f"TX  : {'PASS' if ok else 'FAIL'}  injection on at LOCK; the last {tail} runs, after it "
              f"was turned off, identical to the ring; {len(bad)} runs of a wrong length")
        return ok
    best = align(tx, runs)
    if best is None:
        print("TX  : FAIL  regenerated runs never line up with the ring's runs")
        print("      first:", tx[:40])
        return False
    n = min(len(tx), len(runs) - best) - 1                # the last run may be cut
    first = next((i for i in range(n) if tx[i] != runs[best + i]), n)
    ok = first >= 1000
    print(f"TX  : {'PASS' if ok else 'FAIL'}  {first} runs after LOCK identical to the ring"
          f"{' (all of them)' if first == n else ', then injection'}")
    return ok


def tx_frames(d):
    """Decode the regenerated line (runs in UI) back into frames."""
    tx = [int(x) for x in (d / "out_tx.txt").read_text().split()][1:]
    frames, i = [], 0
    while i < len(tx) and tx[i] != 3:
        i += 1
    while i < len(tx):
        pos, j = 0, i                                     # preamble: 8 UI from a 3-run
        while j < len(tx) and pos < 8:
            pos += tx[j]; j += 1
        if pos != 8:
            break
        bits = []
        while j < len(tx) and len(bits) < 508:
            if tx[j] == 2:
                bits.append(0); j += 1
            elif tx[j] == 1 and j + 1 < len(tx) and tx[j + 1] == 1:
                bits.append(1); j += 2
            else:
                break
        if len(bits) < 508:
            break
        v = int("".join(map(str, [0, 0, 0, 0] + bits)), 2)
        frames.append(v.to_bytes(64, "big"))
        if j >= len(tx) or tx[j] != 3:
            break
        i = j
    return frames


def inj_positions(d):
    """The frame bytes the tb's accepted "inject on" command names, L0 L1 L2 R0 R1 R2
    (24 bit) or L0 L1 R0 R1 (16 bit); () when nothing was injected."""
    for l in (d / "out_cfg.txt").read_text().splitlines():
        t, c, bad, w, *p = map(int, l.split())
        if c != 2 or bad or (w & 3) not in (2, 3):
            continue
        pos = tuple(p) if (w & 3) == 3 else (p[0], p[1], p[3], p[4])
        if all(1 <= x <= 60 for x in pos):
            return pos
    return ()


def match_tx(d, truth, inj):
    """The regenerated line's frames matched to the ring's: (k, frame, injected) in
    order, k None for a frame that is no ring frame. The match leaves out the
    injected positions and the parity bit; `injected` says whether the rest
    differs from the ring's frame (i.e. the injected bytes or the parity do)."""
    tb = [bytes.fromhex(t) for t in truth]
    skip = set(inj) | {0, 63}

    def key(f):
        return bytes(b for i, b in enumerate(f) if i not in skip) + bytes([f[63] & 0xFE, f[0] & 0x0F])

    idx = {}
    for k, f in enumerate(tb):
        idx.setdefault(key(f), []).append(k)
    out, last = [], None
    for f in tx_frames(d):
        ks = idx.get(key(f), [])
        k = next((k for k in ks if last is None or k == last + 1), None)
        if k is None:
            out.append((None, f, None))
            continue
        last = k
        t = tb[k]
        out.append((k, f, not (f[1:] == t[1:] and (f[0] & 0x0F) == (t[0] & 0x0F))))
    return out


left_known_from = 0        # as_left: ring frames before this one have no TX evidence (see there)


def as_left(d, truth):
    """The ring's frames as they left the listener: the truth, with the bytes the
    regenerated line carried at the injected positions in every injected frame.
    J2 (TDM) and J3 (I2S) must show these, not what came in. The TX log starts
    at LOCK: when injection was already on then (INJ_EARLY), the frames before
    the first one decoded from TX cannot be judged this way (left_known_from)."""
    global left_known_from
    inj = inj_positions(d)
    left = list(truth)
    left_known_from = 0
    if not inj:
        return left
    m = match_tx(d, truth, inj)
    ks = [k for k, f, i in m if k is not None]
    if ks and inject_before_lock(d):
        left_known_from = min(ks)
    for k, f, injected in m:
        if k is not None and injected:
            t = bytearray.fromhex(truth[k])
            for p in inj:
                t[p] = f[p]
            left[k] = t.hex()
    return left


def masked_index(f, truth, inj):
    """Which ring frame a TDM frame is when its injected bytes are left out of the
    comparison (and byte 0's block index, as in tdm_indices); None if none."""
    skip = set(inj) | {0}

    def key(h):
        b = bytes.fromhex(h)
        return bytes(x for i, x in enumerate(b) if i not in skip) + bytes([b[0] & 0x0F])

    kf = key(f)
    return next((k for k, t in enumerate(truth) if key(t) == kf), None)


# The tb's two audio sources (tb_core.v, the DSP model) on one counter n, + 1
# per frame: (L's top byte, R's top byte, R's offset from n)
SOURCES = {"DIN": (0x5A, 0xC3, 0x1234), "DIN2": (0x3C, 0xA5, 0x4321)}
INJ_HOLD = 3                                   # inject.v HOLD


def _s24(v):
    return v - (1 << 24) if v & 0x800000 else v


def _source_pair(src, n):
    hl, hr, off = SOURCES[src]
    return _s24(hl << 16 | (n & 0xFFFF)), _s24(hr << 16 | ((n + off) & 0xFFFF))


def _scaled(x, g):
    """inject.v's arithmetic: x g / 256, rounded down, as 24 bits."""
    return ((x * g) >> 8) & 0xFFFFFF


def check_inject(d, truth, fade_log2=0, want_order=("DIN",)):
    """What the ring gets while our audio goes in (tb: bytes 1..6, 24 bit, the
    DSP model's L = 5A nnnn, R = C3 (nnnn + 1234) on DIN and L = 3C nnnn,
    R = A5 (nnnn + 4321) on DIN2, n + 1 per frame):
      * frames before and after injection equal the ring's frames bit for bit;
      * injected frames equal them except the injected bytes and the parity bit;
        the XOR of bits 4..511 (what any XOR parity rule sees) is unchanged;
      * the injected bytes are exactly the source's pair times g/256 (inject.v's
        rounding), n continuing one per frame through every source and gain;
      * g moves by 256 >> fade_log2 at most per frame: HOLD + 2 frames of
        silence at the start, then up; after "off" down, the last injected
        frame at one step; a source changes only across HOLD + 2 silent frames,
        and the sources come in the order want_order;
      * frames stay consecutive, order: original, injected, original;
      * the command naming byte 61 changed nothing (else byte 61 would move).
    """
    INJ = inj_positions(d) or (1, 2, 3, 4, 5, 6)
    assert len(INJ) == 6, "the tb injects 24 bit"
    step = 256 >> fade_log2
    tb = [bytes.fromhex(t) for t in truth]
    skip = set(INJ) | {0, 63}

    def key(f):                                            # bytes injection never touches
        return bytes(b for i, b in enumerate(f) if i not in skip) + bytes([f[63] & 0xFE, f[0] & 0x0F])

    def xor_bits(f):
        return bin(int.from_bytes(f, "big") & ((1 << 508) - 1)).count("1") & 1

    phase, last, n_orig, bad = 0, None, 0, 0
    inj = []                                               # (k, L, R) of the injected frames, in order
    for k, f, injected in match_tx(d, truth, INJ):
        if k is None:
            bad += 1
            print(f"      TX frame with no ring counterpart: {f.hex()}")
            continue
        if last is not None and k != last + 1:
            bad += 1
        last = k
        t = tb[k]
        if not injected:
            if phase == 1:
                phase = 2
            n_orig += 1
            continue
        if phase == 2:
            bad += 1
            print("      injection came back after it was turned off")
        phase = 1
        if xor_bits(f) != xor_bits(t) or key(f) != key(t):
            bad += 1
            print(f"      injected frame {k}: parity {xor_bits(f)} vs {xor_bits(t)}, "
                  f"untouched bytes {'kept' if key(f) == key(t) else 'CHANGED'}")
        inj.append((k, f[INJ[0]] << 16 | f[INJ[1]] << 8 | f[INJ[2]], f[INJ[3]] << 16 | f[INJ[4]] << 8 | f[INJ[5]]))

    # n from any frame at full gain; every other frame's n follows from its index
    anchor = None
    for k, L, R in inj:
        for src, (hl, hr, off) in SOURCES.items():
            if L >> 16 == hl and R >> 16 == hr and (R & 0xFFFF) == ((L & 0xFFFF) + off) & 0xFFFF:
                anchor = (k, L & 0xFFFF)
                break
        if anchor:
            break
    gains, srcs = [], []
    for k, L, R in inj:
        if L == 0 and R == 0:
            gains.append(0); srcs.append(None)
            continue
        found = None
        if anchor:
            n = (anchor[1] + k - anchor[0]) & 0xFFFF
            for src in SOURCES:
                xl, xr = _source_pair(src, n)
                g0 = round(_s24(L) * 256 / xl)
                for g in (g0 - 1, g0, g0 + 1):
                    if 0 < g <= 256 and _scaled(xl, g) == L and _scaled(xr, g) == R:
                        found = (g, src)
        if found is None:
            bad += 1
            print(f"      injected frame {k}: L={L:06x} R={R:06x} is no source's pair at any gain "
                  f"(anchor {anchor})")
            gains.append(None); srcs.append(None)
            continue
        gains.append(found[0]); srcs.append(found[1])

    # the fades
    shape = []
    if gains and None not in gains:
        lead = next((i for i, g in enumerate(gains) if g), len(gains))
        if lead < INJ_HOLD + 2 and not inject_before_lock(d):     # (else it began before the TX log)
            shape.append(f"{lead} silent frames at the start (want {INJ_HOLD + 2})")
        for i in range(1, len(gains)):
            if gains[i] % step or abs(gains[i] - gains[i - 1]) > step:
                shape.append(f"g {gains[i - 1]} -> {gains[i]} at frame {inj[i][0]} (step {step})")
                break
        if phase == 2 and gains[-1] != step:
            shape.append(f"the last injected frame at g {gains[-1]}, not one step ({step})")
        seen = [(i, s) for i, s in enumerate(srcs) if s]
        for (i, a), (j, b) in zip(seen, seen[1:]):
            if a != b and sum(1 for x in gains[i + 1:j] if x == 0) < INJ_HOLD + 2:
                shape.append(f"{a} to {b} at frame {inj[j][0]} without {INJ_HOLD + 2} silent frames")
    bad += len(shape)
    for s in shape:
        print("      fade:", s)

    n_inj = len(inj)
    full = sum(1 for g in gains if g == 256)
    ramp = sum(1 for g in gains if g and g != 256)
    order = []
    for s in srcs:
        if s and (not order or order[-1] != s):
            order.append(s)
    if tuple(order) != tuple(want_order):
        bad += 1
        print(f"      sources {' then '.join(order) or 'none'}, want {' then '.join(want_order)}")
    ok = bad == 0 and full >= 8 and phase == 2 and n_orig + n_inj + bad >= 40
    print(f"INJ : {'PASS' if ok else 'FAIL'}  {n_orig + n_inj + bad} TX frames decoded: {n_orig} unchanged, "
          f"{n_inj} injected ({gains.count(0)} silent, {ramp} fading, {full} full; {' then '.join(order) or '-'}; "
          f"samples consecutive, parity XOR kept), {bad} bad, "
          f"{'returned to pass-through' if phase == 2 else 'NEVER returned to pass-through'}")
    return ok


def tdm_frames_hex(d):
    """The TDM frames sent under LOCK, 64 bytes each as hex (before LOCK the Si514
    is centred once and its output is off for the calibration, so clk_r and TDM
    stop there); the frames before the first bank was filled are left out."""
    rows = [l.strip() for l in (d / "out_tdm.txt").read_text().splitlines()]
    frames, cur = [], None
    for r in rows:
        if "x" in r or "z" in r or r[3] != "1":
            cur = None
            continue
        fs, s0, s1 = r[0], int(r[1]), int(r[2])
        if fs == "1":
            if cur and len(cur[0]) == 256:
                frames.append(cur)
            cur = ([], [])
        if cur is not None:
            cur[0].append(s0)
            cur[1].append(s1)
    out = []
    for b0, b1 in frames:
        by = bytearray(64)
        for b in range(256):
            by[b >> 3] |= b0[b] << (7 - (b & 7))
            by[32 + (b >> 3)] |= b1[b] << (7 - (b & 7))
        out.append(by.hex())
    return [f for f in out if f[2:] != "0" * 126]


def tdm_indices(live, truth):
    """Which ring frame each TDM frame is (-1: none); byte 0's block index is
    compared only once the framer knows it."""
    tnorm = ["0" + t[1:] for t in truth]
    return [truth.index(f) if f in truth else tnorm.index("0" + f[1:]) if "0" + f[1:] in tnorm else -1
            for f in live]


def check_tdm(d, truth):
    """Only frames sent under LOCK count; every one must be a ring frame as it
    left the listener (as_left: injected bytes included), byte for byte, and
    they must follow each other."""
    live = tdm_frames_hex(d)
    idx = tdm_indices(live, truth)
    # injection on before LOCK: the frames before the first one the TX log shows
    # can only be placed with their injected bytes left out
    pos = inj_positions(d)
    early = 0
    if pos and d_truth_ref:
        for i, (f, k) in enumerate(zip(live, idx)):
            if k < 0:
                k2 = masked_index(f, d_truth_ref, pos)
                if k2 is not None and k2 < left_known_from:
                    idx[i] = k2
                    early += 1
    matched = sum(1 for k in idx if k >= 0)
    bad = sum(1 for k in idx if k < 0)
    order_ok = all(b == a + 1 for a, b in zip(idx, idx[1:]) if a >= 0 and b >= 0)
    inj = sum(1 for k in idx if k >= 0 and truth[k] != d_truth_ref[k]) if d_truth_ref else 0
    ok = bad == 0 and matched >= 8 and order_ok
    print(f"TDM : {'PASS' if ok else 'FAIL'}  {matched} frames under LOCK matched ({inj} of them with injected bytes"
          f"{', ' + str(early) + ' before the TX log begins' if early else ''}), {bad} wrong, "
          f"{'in order' if order_ok else 'OUT OF ORDER (skipped or repeated)'}")
    return ok


def uart_packets(d):
    """Every 42-byte packet on the UART line: frame counter, status, the 32
    control bytes, and whether its XOR and every stop bit were right."""
    ev = []
    for l in (d / "out_uart.txt").read_text().splitlines():
        t, v = l.split()
        if v in "01":
            ev.append((float(t) / 1000.0, int(v)))         # ps -> ns
    def level(t):
        lv = 1
        for te, v in ev:
            if te > t:
                break
            lv = v
        return lv
    # decode bytes: a start bit is a 1->0 transition while idle
    bytes_ = []
    i = 0
    t_idle = 0.0
    while i < len(ev):
        t, v = ev[i]
        if v == 0 and t >= t_idle:
            val = 0
            for k in range(8):
                val |= level(t + BIT_NS * (1.5 + k)) << k
            stop = level(t + BIT_NS * 9.5)
            bytes_.append((val, stop))
            t_idle = t + BIT_NS * 9.8
        i += 1
    data = [v for v, s in bytes_]
    pk = []
    j = 0
    while j + 41 <= len(data):
        if data[j] == 0xA5 and data[j + 1] == 0x5A and j + 42 <= len(data):
            p = data[j:j + 42]
            x = 0
            for b in p[:41]:
                x ^= b
            pk.append(dict(kind="ctl", counter=p[2] | p[3] << 8 | p[4] << 16 | p[5] << 24, status=p[6],
                           ctrl=bytes(p[9:41]), xor_ok=(x == p[41]),
                           stop_ok=all(s for v, s in bytes_[j:j + 42])))
            j += 42
        elif data[j] == 0xA5 and data[j + 1] == 0xC5:                 # a capture packet (capture.v)
            p = data[j:j + 41]
            x = 0
            for b in p[:40]:
                x ^= b
            pk.append(dict(kind="cap", seq=p[2] | p[3] << 8, lens=p[4:36],
                           glitch=[(p[36 + i // 8] >> (i % 8)) & 1 for i in range(32)],
                           count=p[4] | p[5] << 8 | p[6] << 16 | p[7] << 24,
                           xor_ok=(x == p[40]), stop_ok=all(s for v, s in bytes_[j:j + 41])))
            j += 41
        else:
            j += 1
    return pk


def truth_blocks(truth):
    """The 32 control bytes of every block that starts on a block-start frame -> its first frame."""
    blocks = {}
    for s in range(0, len(truth) - 15):
        if int(truth[s][0], 16) == 0:                      # block start frame
            blocks[bytes(bytes.fromhex(truth[s + k])[p] for k in range(16) for p in (61, 62))] = s
    return blocks


def check_uart(d, truth):
    blocks = truth_blocks(truth)
    n_ok = n_bad = 0
    for p in uart_packets(d):
        if p["kind"] != "ctl":
            continue
        if p["xor_ok"] and p["stop_ok"] and p["ctrl"] in blocks:
            n_ok += 1
        else:
            n_bad += 1
    ok = n_ok >= 1 and n_bad == 0
    print(f"UART: {'PASS' if ok else 'FAIL'}  {n_ok} packets good, {n_bad} bad")
    return ok


def check_mclk(d):
    """MCLK must be exactly 512 periods per TDM (= MOST) frame: 512 Fs. Each
    row is one frame's count and LOCK at its end; a frame counts if LOCK was
    on at both of its ends (before LOCK the clock stops once, for centring)."""
    rows = [l.split() for l in (d / "out_mclk.txt").read_text().splitlines()]
    n = [int(c) for (c, lk), (_, lk0) in zip(rows[1:], rows[:-1]) if lk == "1" and lk0 == "1"]
    ok = len(n) >= 8 and all(v == 512 for v in n)
    print(f"MCLK: {'PASS' if ok else 'FAIL'}  {len(n)} frames under LOCK, periods per frame {sorted(set(n))}")
    return ok


def i2s_frames(d):
    """J3's I2S frames as (L slot, R slot), 32-bit words: LRCK low = left, MSB one
    BCLK after the edge, from the log of every rising BCLK."""
    rows = [l.strip() for l in (d / "out_i2s.txt").read_text().splitlines()]
    rows = [r for r in rows if "x" not in r and "z" not in r]
    frames = []
    for i in range(1, len(rows) - 64):
        if rows[i - 1][0] == "1" and rows[i][0] == "0":           # LRCK fell: slot 0
            f = rows[i:i + 64]
            if all(f[s][0] == ("0" if s < 32 else "1") for s in range(64)):
                bits = [int(f[s][1]) for s in range(1, 64)] + [0]  # slots 1..63, then next slot 0
                frames.append((int("".join(map(str, bits[:32])), 2), int("".join(map(str, bits[32:])), 2)))
    return frames


def check_spdif(d, fs):
    """The S/PDIF line carries the very pairs J3's I2S carries, frame for frame, in
    the form spdif_dec.check demands (preambles, cell edges, parity, channel
    status with the ring's rate)."""
    lines = spdif_dec.frames_of((d / "out_spdif.txt").read_text())
    sp = [(l["sample"], r["sample"]) for l, r in spdif_dec.decode(lines)]
    i2s = [(l >> 8, r >> 8) for l, r in i2s_frames(d)]              # the 24-bit pairs
    ok_form, summary = spdif_dec.check(lines, None, fs == 48000, log=lambda *a: None)
    start = next((k for k, p in enumerate(sp) if p != (0, 0)), None)
    same = bad = 0
    if start is not None and sp[start] in i2s:
        j = i2s.index(sp[start])
        for a, b in zip(sp[start:], i2s[j:]):
            if a == b:
                same += 1
            else:
                bad += 1
                if bad <= 3:
                    print(f"      S/PDIF L R {a[0]:06x} {a[1]:06x}, I2S {b[0]:06x} {b[1]:06x}")
    else:
        bad = len(sp)
    ok = ok_form and start is not None and bad == 0 and same >= len(sp) - start - 2 and same >= 8
    print(f"SPDF: {'PASS' if ok else 'FAIL'}  {len(sp)} frames, {same} equal to J3's I2S pairs from the first "
          f"sound on, {bad} differ; {summary}")
    return ok


def check_i2s(d, truth):
    """J3 carries exactly the bytes the host asked for, through amp_out, frame after
    frame - from the frames as they left the listener (as_left).

    out_cfg.txt lists the commands sent (a wrong-XOR one must change nothing).
    The host first sets amp_out straight through with stream 0 to L x 1 and
    R x 0.5 (tb_core.v). Each I2S frame (LRCK low = left, MSB one BCLK after
    the edge) must equal the chosen bytes of one ring frame, so scaled: zeros
    before the first good command, then config A, then config B, the ring
    frames consecutive throughout.
    """
    cfgs = []
    for l in (d / "out_cfg.txt").read_text().splitlines():
        t, c, bad, w, *pos = map(int, l.split())
        if c == 1 and not bad:
            cfgs.append((w, pos))
    frames = i2s_frames(d)

    def s24(v):
        return v - (1 << 24) if v >> 23 else v

    def slot(v):                                                   # a 24-bit sample in its 32-bit slot
        v = max(-(1 << 23), min((1 << 23) - 1, v))
        return (v & 0xFFFFFF) << 8

    def want(fr, w, pos):
        b = bytes.fromhex(fr)
        l = [b[p] for p in pos[:3]]; r = [b[p] for p in pos[3:]]
        if w == 2:
            l[2] = r[2] = 0
        L = s24(l[0] << 16 | l[1] << 8 | l[2]); R = s24(r[0] << 16 | r[1] << 8 | r[2])
        return (slot(L), slot((R + 1) >> 1))

    stage, last, counts, bad, seen = 0, None, [0] * (len(cfgs) + 1), 0, []
    for fw in frames:
        if stage == 0 and fw == (0, 0):
            counts[0] += 1
            continue
        hit = None
        for st in range(max(stage, 1), len(cfgs) + 1):
            w, pos = cfgs[st - 1]
            idx = [k for k, fr in enumerate(truth) if want(fr, w, pos) == fw]
            if idx:
                hit = (st, idx)
                break
        if hit is None:
            bad += 1
            print("      no ring frame gives L R = " + " ".join(f"{v:08x}" for v in fw))
            continue
        st, idx = hit
        k = idx[0] if last is None else next((k for k in idx if k == last + 1), idx[0])
        if last is not None and k != last + 1:
            bad += 1                                          # skipped or repeated frame
            print(f"      ring frame {k} follows {last}")
        stage, last = st, k
        seen.append(k)
        counts[st] += 1
    inj = sum(1 for k in seen if truth[k] != d_truth_ref[k]) if d_truth_ref else 0
    ok = bad == 0 and all(c >= 4 for c in counts[1:]) and len(cfgs) == 2
    print(f"I2S : {'PASS' if ok else 'FAIL'}  {len(frames)} frames ({inj} of them with injected bytes): {counts[0]} silent before the "
          f"first command, " + ", ".join(f"cfg{i} {c}" for i, c in enumerate(counts[1:], 1))
          + f"; {bad} wrong or out of order")
    return ok


def check_fs(d):
    """The frame-rate output (for an external clock multiplier) keeps the sampler's resolution.

    Truth comes from the stimulus itself: every transition of samples.hex (8
    samples per word, bit 0 first), the frames' UI 0 edges (the edge that opens
    each 3-UI run) and their UI 512 edges. Each rising edge of fs must sit a
    constant number of samples after its frame's UI 0 edge, each falling edge
    a constant number after UI 512 - spread 0, i.e. 1.26 ns resolution. For
    comparison, the same edges drawn on the clk_s grid (the old fs_sq) spread
    over up to 8 samples, 10.1 ns.
    """
    import json
    meta = json.loads((d / "meta.json").read_text())
    ui = meta["ui_samples"]
    words = [int(x, 16) for x in (d / "samples.hex").read_text().split()]
    bits = [(w >> k) & 1 for w in words for k in range(8)]
    tr = [j for j in range(1, len(bits)) if bits[j] != bits[j - 1]]
    # a run's length in UI, corrected for the stimulus' pulse-width distortion
    # (high runs stretched by pwd, low runs shortened), as the receiver learns
    # to do; then only runs that repeat exactly one frame (1024 UI) apart
    pwd = meta.get("pwd", 0.0)

    def ui_len(n):
        r = (tr[n + 1] - tr[n]) / ui
        return r - pwd if bits[tr[n]] else r + pwd
    cand = [tr[n] for n in range(len(tr) - 1) if 2.5 < ui_len(n) < 3.5]
    # a preamble may hold two 3-UI runs (the S/PDIF-like set): the frame's edge
    # is the first of them, so 3-UI runs less than 8 UI apart are one preamble
    first = [c for k, c in enumerate(cand) if k == 0 or c - cand[k - 1] > 8 * ui]
    frame = 1024 * ui
    starts = [s for k, s in enumerate(first)
              if any(abs(abs(c - s) - frame) < ui for c in first[max(0, k - 3):k + 4] if c != s)]
    mids = []
    for f in starts:
        want = f + 512 * ui
        near = min(tr, key=lambda t: abs(t - want))
        if abs(near - want) < ui / 2:
            mids.append(near)

    rise, fall, late = [], [], None
    for l in (d / "out_fs.txt").read_text().splitlines():
        a, b = l.split()
        if a == "late":
            late = int(b)
        elif b == "1":
            rise.append(int(a))
        elif b == "0":
            fall.append(int(a))

    def offsets(edges, truth):
        out = []
        for e in edges:
            before = [t for t in truth if t < e]
            if before:
                out.append(e - before[-1])
        return out

    ro, fo = offsets(rise, starts), offsets(fall, mids)
    old = sorted({(-f) % 8 for f in starts})          # clk_s-grid lag of the same edges
    ok = (len(ro) >= 20 and len(fo) >= 20 and len(set(ro)) == 1 and len(set(fo)) == 1
          and late == 0)
    print(f"FS  : {'PASS' if ok else 'FAIL'}  {len(ro)} rising / {len(fo)} falling edges; "
          f"offset to UI 0 {sorted(set(ro))} and to UI 512 {sorted(set(fo))} samples "
          f"(spread {max(ro) - min(ro) if ro else '-'} / {max(fo) - min(fo) if fo else '-'}); "
          f"late={late}; on the clk_s grid the same edges would spread {max(old) - min(old)} samples")
    return ok


def check_gap(d, fs):
    """A dead line after LOCK (tb GAP_AFTER_LOCK_US; out_gap.txt holds its
    start and end in ns): LOCK must drop within 5 us of the line dying and come
    back after it returns; the Si514 is not centred again (holdover, then
    resume), no small change leaves its window, nothing is addressed wrongly."""
    t0, t1 = map(float, (d / "out_gap.txt").read_text().split())
    ev = []
    for l in (d / "out_lock.txt").read_text().splitlines():
        t, lk = l.split()[0], l.split()[1]
        if lk in ("lock=0", "lock=1"):
            ev.append((int(t) / 1000.0, lk == "lock=1"))          # ps -> ns
    w = (d / "out_si514.txt").read_text().split()
    kv = dict(zip(w[0::2], w[1::2]))
    first = next((t for t, v in ev if v), None)
    drop = next((t for t, v in ev if not v and t >= t0), None)
    back = next((t for t, v in ev if v and t > t1), None)
    frame = 1e9 / fs
    ok = (first is not None and first < t0 and drop is not None and drop - t0 <= 5000.0
          and back is not None and int(kv["fcal"]) == 1 and int(kv["bad_small"]) == 0
          and int(kv["bad_rmw"]) == 0 and int(kv["nack"]) == 0
          and int(kv["found"], 16) == int(kv["addr"], 16))
    fmt = lambda x, f: f(x) if x is not None else "never"
    print(f"GAP : {'PASS' if ok else 'FAIL'}  LOCK at {fmt(first, lambda x: f'{x / 1e6:.2f} ms')}; "
          f"line dead at {t0 / 1e6:.3f} ms for {(t1 - t0) / 1e3:.1f} us; LOCK dropped "
          f"{fmt(drop, lambda x: f'{(x - t0) / 1e3:.2f} us')} after, back "
          f"{fmt(back, lambda x: f'{(x - t1) / frame:.1f} frames')} after it returned; "
          f"fcal {kv['fcal']}, bad_small {kv['bad_small']}, bad_rmw {kv['bad_rmw']}, nack {kv['nack']}")
    return ok


def check_fbdead(d, fs):
    """TX_FB dead after LOCK, for good (tb FB_DEAD_AFTER_LOCK_US; out_fbdead.txt
    holds the moment in ns) - what the FPGA sees if U9's output sticks: LOCK
    must drop within 4 ring frames (plus one for the frame in progress) and
    stay off."""
    t0 = float((d / "out_fbdead.txt").read_text().split()[0])
    ev = []
    for l in (d / "out_lock.txt").read_text().splitlines():
        t, lk = l.split()[0], l.split()[1]
        if lk in ("lock=0", "lock=1"):
            ev.append((int(t) / 1000.0, lk == "lock=1"))          # ps -> ns
    frame = 1e9 / fs
    first = next((t for t, v in ev if v), None)
    drop = next((t for t, v in ev if not v and t >= t0), None)
    back = next((t for t, v in ev if v and drop is not None and t > drop), None)
    ok = first is not None and first < t0 and drop is not None and drop - t0 <= 5 * frame and back is None
    fmt = lambda x, f: f(x) if x is not None else "never"
    print(f"FB  : {'PASS' if ok else 'FAIL'}  LOCK at {fmt(first, lambda x: f'{x / 1e6:.2f} ms')}; "
          f"TX_FB dead at {t0 / 1e6:.3f} ms; LOCK dropped "
          f"{fmt(drop, lambda x: f'{(x - t0) / frame:.2f} frames')} after, "
          f"{'came back' if back is not None else 'stayed off'}")
    return ok


def check_lease(d, truth, lease_us, fs):
    """Corner lease: "inject" sent once and never again, no "off". The injector's
    lease (inject.v) must end it as an "off" would: the injected run of frames
    lasts the lease (from the command; one frame either way, plus the fade
    down's one frame), then the line is the ring's to the end. Before the
    lease, the run went on to the end of the simulation."""
    INJ = inj_positions(d) or (1, 2, 3, 4, 5, 6)
    seq = match_tx(d, truth, INJ)
    flags = [inj for k, _, inj in seq if k is not None]
    first = next((i for i, x in enumerate(flags) if x), None)
    last = max((i for i, x in enumerate(flags) if x), default=None)
    n = 0 if first is None else last - first + 1
    want = lease_us * 1e-6 * fs
    after = 0 if last is None else len(flags) - 1 - last
    ok = first is not None and all(flags[first:last + 1]) and abs(n - want) <= 3 and after >= 20
    print(f"LEAS: {'PASS' if ok else 'FAIL'}  injected {n} frames in one run, the lease is {want:.1f}; "
          f"{after} frames of the ring's own line after it")
    return ok


def check_err(d, fs):
    """One edge of the ring's line removed after LOCK (make_stim --kill-edge-frame;
    meta.json kill_frame, kill_edge_ui): two runs merged into one of a wrong
    length - a coding error in one frame's data, the fault a bad bit leaves.
    LOCK must be on before it and never drop until the stimulus ends (the
    receiver rides through one bad frame, the regenerator does not stop); the
    regenerated line must equal the ring's, fault included (check_tx against
    runs.hex, which has the merged run); TDM must lose exactly that frame -
    the frame before it once more, then the next - and be right and in order
    otherwise; the UART must carry good blocks again after the damaged one
    (the framer forgets the block index until the next block start); MCLK 512
    per frame throughout."""
    import json
    meta = json.loads((d / "meta.json").read_text())
    truth = [l.strip() for l in (d / "frames.hex").read_text().split()]
    runs = [int(x, 16) for x in (d / "runs.hex").read_text().split()]
    kf = meta["kill_frame"]
    t_err = meta["kill_edge_ui"] * meta["ui_samples"] / 0.792           # ns (1.26 ns per sample)
    t_end = meta["clocks"] * 1000.0 / 99.0                              # ns: the stimulus ends
    ev = []
    for l in (d / "out_lock.txt").read_text().splitlines():
        t, lk = l.split()[0], l.split()[1]
        if lk in ("lock=0", "lock=1"):
            ev.append((int(t) / 1000.0, lk == "lock=1"))                # ps -> ns
    first = next((t for t, v in ev if v), None)
    drops = [t for t, v in ev if not v and first is not None and t > first]
    stray = [t for t in drops if t < t_end - 100000.0]                  # a drop before the line ends
    ok_lock = first is not None and first < t_err and not stray
    print(f"LOCK: {'PASS' if ok_lock else 'FAIL'}  on at {first / 1e6 if first else 0:.2f} ms, the fault "
          f"(a {meta['kill_run_ui']}-UI run in frame {kf}) at {t_err / 1e6:.2f} ms, "
          f"{len(stray)} drops before the stimulus ended")
    ok_tx = check_tx(d, runs)
    live = tdm_frames_hex(d)
    idx = tdm_indices(live, truth)
    steps = list(zip(idx, idx[1:]))
    unknown = sum(1 for k in idx if k < 0)
    odd = [(a, b) for a, b in steps if a >= 0 and b >= 0 and b - a != 1]
    ok_tdm = (unknown == 0 and kf not in idx and len(live) >= 100 and len(odd) <= 2
              and all(b - a in (0, 2) and kf - 1 <= a <= kf + 1 for a, b in odd)
              and sum(b - a for a, b in odd) == 2)
    print(f"TDM : {'PASS' if ok_tdm else 'FAIL'}  {len(live)} frames under LOCK, {unknown} unknown, "
          f"frame {kf} {'absent' if kf not in idx else 'PRESENT'}, steps other than +1 at {odd}")
    ok_uart = check_uart(d, truth)
    blocks = truth_blocks(truth)
    after = [p for p in uart_packets(d)
             if p["xor_ok"] and p["stop_ok"] and p["ctrl"] in blocks and p["counter"] > kf]
    ok_after = len(after) >= 2
    print(f"UART: {'PASS' if ok_after else 'FAIL'}  {len(after)} good packets after the damaged block")
    ok_mclk = check_mclk(d)
    return ok_lock and ok_tx and ok_tdm and ok_uart and ok_after and ok_mclk


def line_runs(d):
    """The run lengths rx_runlen measures on the stimulus: samples between
    transitions of samples.hex (8 per word, bit 0 first), saturating at 255; the
    first one counts from the sampler's start."""
    words = [int(x, 16) for x in (d / "samples.hex").read_text().split()]
    bits = [(w >> k) & 1 for w in words for k in range(8)]
    runs, n = [], 0
    for k in range(1, len(bits)):
        n += 1
        if bits[k] != bits[k - 1]:
            runs.append(min(n, 255))
            n = 0
    return runs


def check_capture(d):
    """Two dumps on the UART (tb CAPTURE=1, buffer 512 runs): the power-up capture
    (command 04 M=02), then a capture anew with a dump when full (M=05). Each
    must arrive whole - packets 0..15 with good XOR and stop bits, the trailer
    with 512 - and its runs must be the line's own: the first dump the first
    512 runs after power-up (the very first run counts from the sampler's
    start and is left out), the second 512 consecutive runs found somewhere
    after the command, sample for sample as rx_runlen measures them, with no
    glitch flagged on this clean line."""
    truth = line_runs(d)
    pk = [p for p in uart_packets(d) if p["kind"] == "cap"]
    dumps, cur = [], None
    for p in pk:
        if not (p["xor_ok"] and p["stop_ok"]):
            if cur is not None:
                cur["bad"] += 1
            continue
        if p["seq"] == 0xFFFF:
            if cur is not None:
                cur["count"] = p["count"]
                dumps.append(cur)
            cur = None
            continue
        if cur is None or p["seq"] == 0:
            cur = dict(runs={}, glitch=0, bad=0, count=None)
        cur["runs"][p["seq"]] = p["lens"]
        cur["glitch"] += sum(p["glitch"])

    def flat(dm):
        out = []
        for s in range(16):
            out += dm["runs"].get(s, [None] * 32)
        return out

    ok = len(dumps) == 2
    notes = []
    for i, dm in enumerate(dumps):
        r = flat(dm)
        whole = dm["count"] == 512 and len(dm["runs"]) == 16 and dm["bad"] == 0 and dm["glitch"] == 0
        if i == 0:
            same = r[1:] == truth[1:512]
            where = "the first 512 runs after power-up"
        else:
            n = len(r)
            pos = next((k for k in range(1, len(truth) - n) if truth[k:k + n] == r), None)
            same = pos is not None
            where = f"runs {pos}..{pos + n - 1} of the line" if pos is not None else "nowhere on the line"
        ok &= whole and same
        notes.append(f"dump {i + 1}: {len(dm['runs'])} packets, trailer {dm['count']}, {dm['bad']} bad, "
                     f"{dm['glitch']} glitch flags, {'equals' if same else 'DIFFERS FROM'} {where}")
    print(f"CAP : {'PASS' if ok else 'FAIL'}  {len(dumps)} dumps; " + "; ".join(notes))
    return ok


def check_wd(d):
    """The board's bypass watchdog (U11, modelled in tb_core.v) never dropped
    TX_SEL while LOCK was on and clk_s ran: TX kept toggling through
    everything the run does (host commands, injection on and off)."""
    drops = int((d / "out_wd.txt").read_text().split()[0])
    ok = drops == 0
    print(f"WD  : {'PASS' if ok else 'FAIL'}  {drops} watchdog drops while LOCK was on")
    return ok


def check_clkstop(d, tw_ns=10000.0):
    """clk_s stops for good after LOCK (tb CLKS_STOP_AFTER_LOCK_US; out_clkstop.txt:
    stop, TX's last rising edge, TX_SEL's fall in ns, TX_SEL and LOCK at the end,
    watchdog drops before the stop). LOCK must stay on - the failure itself;
    TX must stop toggling within 3 us (the regenerator's FIFO runs dry); the
    board's watchdog (U11 model) must then drop TX_SEL, i.e. bypass, within
    its time plus 3 us, and must never have dropped while clk_s ran."""
    t_stop, t_last, t_fall, sel, lk, drops = (float(x) for x in (d / "out_clkstop.txt").read_text().split())
    ok = (lk == 1 and sel == 0 and drops == 0 and t_last - t_stop <= 3000.0
          and t_fall - t_stop <= tw_ns + 3000.0)
    print(f"CLK : {'PASS' if ok else 'FAIL'}  clk_s stopped at {t_stop / 1e6:.3f} ms; LOCK "
          f"{'stayed on' if lk == 1 else 'went off'}; TX's last edge {(t_last - t_stop) / 1e3:.2f} us after, "
          f"TX_SEL (bypass) {(t_fall - t_stop) / 1e3:.2f} us after; {int(drops)} watchdog drops before")
    return ok


def check_sioff(d, fs, lost_us):
    """The Si514's supply lost after LOCK and back later at its factory frequency
    (tb SI_OFF_AFTER_LOCK_US; out_sioff.txt): 5V_SW off while the module runs on
    USB. LOCK must drop within 5 us; every line built in clk_r must be low 2 us
    after the clock stopped and stay low; the core must take the part for lost
    lost_us (+ 2 us) after the stop and hold the I2C lines and the UART low until
    the clock returns; then the part must be centred anew (a second FCAL) before
    MCLK or BCLK moves, and LOCK must come back. No small change may leave its
    window, nothing may be addressed wrongly. As first written the core resumed on
    the old M, the ring domain ran on the factory frequency, and LOCK never came back."""
    w = (d / "out_sioff.txt").read_text().split()
    t_off, t_lost, t_on, t_cen2, t_mclk, t_bclk = map(float, w[:6])
    pads_a, pads_b, held, n_pad, n_held = w[6], w[7], w[8], int(w[9]), int(w[10])
    ev = []
    for l in (d / "out_lock.txt").read_text().splitlines():
        t, lk = l.split()[0], l.split()[1]
        if lk in ("lock=0", "lock=1"):
            ev.append((int(t) / 1000.0, lk == "lock=1"))          # ps -> ns
    kv = dict(zip(*[iter((d / "out_si514.txt").read_text().split())] * 2))
    first = next((t for t, v in ev if v), None)
    drop = next((t for t, v in ev if not v and t >= t_off), None)
    back = next((t for t, v in ev if v and t > t_on), None)
    ok = (first is not None and first < t_off and drop is not None and drop - t_off <= 5000.0
          and pads_a == "0" * 9 and pads_b == "0" * 9 and n_pad == 0
          and lost_us * 1e3 <= t_lost - t_off <= lost_us * 1e3 + 2000.0 and held == "1000" and n_held == 0
          and t_on < t_cen2 < t_mclk and t_cen2 < t_bclk and back is not None
          and int(kv["fcal"]) == 2 and int(kv["bad_small"]) == 0 and int(kv["bad_rmw"]) == 0
          and int(kv["nack"]) == 0 and int(kv["found"], 16) == int(kv["addr"], 16))
    after = lambda t: f"{(t - t_on) / 1e3:.0f} us" if t > 0 else "never"
    frame = 1e9 / fs
    print(f"SI  : {'PASS' if ok else 'FAIL'}  LOCK at {first / 1e6 if first else -1:.2f} ms; supply off at "
          f"{t_off / 1e6:.3f} ms for {(t_on - t_off) / 1e3:.0f} us: LOCK dropped "
          f"{(drop - t_off) / 1e3 if drop else -1:.2f} us after; the lines (TDM 4, MCLK, I2S 3, S/PDIF) "
          f"{pads_a} at 2 us, {pads_b} at the end, {n_pad} rising edges; lost "
          f"{(t_lost - t_off) / 1e3 if t_lost > 0 else -1:.1f} us after, lost/SCL/SDA/UART {held}, "
          f"{n_held} rising edges; back: centred again {after(t_cen2)} after, MCLK {after(t_mclk)}, "
          f"BCLK {after(t_bclk)}, LOCK {f'{(back - t_on) / frame:.0f} frames' if back else 'never'} after; "
          f"fcal {kv['fcal']}, bad_small {kv['bad_small']}, bad_rmw {kv['bad_rmw']}, nack {kv['nack']}")
    return ok


d_truth_ref = None          # the frames as the ring sent them, for the counts in TDM/I2S reports


def main(d):
    global d_truth_ref
    d = Path(d)
    truth = [l.strip() for l in (d / "frames.hex").read_text().split()]
    runs = [int(x, 16) for x in (d / "runs.hex").read_text().split()]
    d_truth_ref = truth
    left = as_left(d, truth)
    fs = json.loads((d / "meta.json").read_text())["fs"]
    res = [check_si514(d), check_tx(d, runs), check_tdm(d, left), check_uart(d, truth),
           check_mclk(d), check_i2s(d, left), check_spdif(d, fs), check_inject(d, truth), check_fs(d)]
    print("PASS" if all(res) else "FAIL")
    return 0 if all(res) else 1


if __name__ == "__main__":
    sys.exit(main(sys.argv[1]))
