Oleg-mk/MOST25-to-AUDIO/listener_gw/sim/run_core.py

#!/usr/bin/env python3
"""run_core.py - the whole listener_core, corner by corner: stimulus, simulation, checks.

Corners (stimulus from make_stim.py, simulation tb_core.v, checks check_core.py):
  core48     48 kHz ring, PWD +0.316 UI, jitter 0.195 UI, 0 ppm, 240 frames:
             every check in check_core.py must pass
  core44     44.1 kHz ring, PWD -0.15 UI, jitter 0.195 UI, -1000 ppm, 240 frames:
             every check must pass
  pre2       core48 with S/PDIF-like preambles (3-3-1-1, block start 3-1-1-3: two
             3-UI runs in one preamble): every check must pass. The design as
             first written took the second 3-UI run for a lost frame and never
             injected; the clock loop saw two events per frame
  mut_nofix  core48 with the injector's parity fix turned off (NOFIX): INJ must
             FAIL and nothing else - proof that the injection check sees parity
  inj_early  core48 with "inject" sent before the Si514 is centred: the ring
             domain is reset under the command, which must survive it (every
             check must pass; the injector as first written lost the command)
  gap        48 kHz ring, PWD +0.2 UI, 480 frames, the line dead for 20 us 2 ms
             after LOCK (placed by the tb, wherever LOCK comes): LOCK must drop
             within 5 us, come back after the line returns, and the Si514 must
             not be centred a second time
  fb_dead    core48, but TX_FB dies 200 us after LOCK and stays dead (U9's
             output stuck): LOCK must drop within 4 ring frames and stay off
  clk_stop   core48, but clk_s stops 300 us after LOCK (PLL or crystal dead):
             LOCK stays on - no clk_s logic can help - and the board's watchdog
             (U11, modelled in tb_core.v) must take the ring to bypass: TX
             stops toggling within 3 us, TX_SEL falls within 13 us
  si_start   core48 with a Si514 that powers up at 250 MHz, the top of its range
             (a shelf part starts at whatever the factory set): every check must
             pass, and MCLK and BCLK must not move before the centring. As first
             written the ring domain ran on the start-up frequency until then,
             out of timing above 78 MHz
  si_off     48 kHz ring over 480 frames, a Si514 that starts at 125 MHz; 200 us after
             LOCK its supply goes for 1 ms and it comes back at 125 MHz with its
             factory settings (5V_SW off while the FPGA runs on its own USB): LOCK
             must drop at once, every line built in clk_r be low and stay low, the
             core take the part for lost after SI_LOST and hold the I2C lines and
             the UART low, then centre it anew before MCLK or BCLK moves, and LOCK
             come back. As first written the lines froze where they were, half at
             3.3 V on chips without supply, and the loop resumed on the old M with
             the ring domain on the factory frequency: LOCK never came back
  capture    core48 over 840 frames, the capture buffer 512 runs (CAP_AW 9): the host
             dumps the power-up capture, then captures anew with a dump when full.
             Both dumps must arrive whole (every packet, the trailer's count 512),
             the first must be the line's first 512 runs after power-up, the
             second 512 consecutive runs of the line, sample for sample as
             rx_runlen measures them; the control packets must go on unbroken
  bit_err    core48 without injection, one edge of the line removed in frame
             120 (two runs merge into one of a wrong length, 1 ms after LOCK):
             LOCK must stay on to the end, the regenerated line must equal the
             ring's fault included, TDM must lose that one frame and nothing
             else, the UART must carry good blocks again after the damaged one.
             As first written, the framer unlocked on the first error, the
             regenerator emptied its FIFO and LOCK fell for HOLD_RE
  fade       core48 over 1400 frames with the injector's real fades (256 frames):
             DIN on, then DIN2 (the S/PDIF input's place), then off. Every check
             must pass; INJ sees every injected pair as the source's pair times
             g/256, g up after HOLD + 2 silent frames, down to the switch, HOLD + 2
             silent frames, up on DIN2, down after "off" - one step per frame
             (the other corners fade in one step: FADE_LOG2 0)
  lease      core48 over 300 frames, "inject" sent once and never again, no "off",
             the injector's lease 300 us: the injection must end after the
             lease, one frame either way, and the line be the ring's from then
             on. Before the lease an "on" outlived a host that went silent
The corners run one after another (about a minute each); --only NAME runs one.

Usage: python run_core.py [--only NAME]      needs oss-cad-suite on PATH
"""
import argparse
import json
import subprocess
import sys
from pathlib import Path

import check_core as cc

HERE = Path(__file__).resolve().parent
RTL = HERE.parent / "rtl"
SRC = ["tb_core.v", "si514_model.v"] + [str(RTL / f) for f in (
    "rx_runlen.v", "rx_classify.v", "rx_framer.v", "fs_fine.v", "regen.v", "tdm_out.v",
    "capture.v", "ctrl_uart.v", "uart_rx.v", "host_cmd.v", "dsp_core.v", "amp_out.v", "spdif_tx.v", "inject.v",
    "i2c_master.v",
    "si514_ctrl.v", "tx_pre.v", "dpll.v", "listener_core.v")]

LEASE_CLK = 29700          # corner lease: the injector's lease, 300 us of clk_s
SI_LOST_CLK = 20000        # tb_core's SI_LOST: clk_s of a dead clk_r before the Si514 is lost

CORNERS = [
    # name        stimulus (make_stim.py)                                    compile options
    ("core48",    ["--fs", "48000", "--frames", "240", "--pwd", "0.316", "--jit", "0.195",
                   "--ppm", "0", "--seed", "7"], []),
    ("core44",    ["--fs", "44100", "--frames", "240", "--pwd", "-0.15", "--jit", "0.195",
                   "--ppm", "-1000", "--seed", "11"], []),
    ("pre2",      ["--fs", "48000", "--frames", "240", "--pwd", "0.316", "--jit", "0.195",
                   "--ppm", "0", "--seed", "7", "--preamble", "spdif"], []),
    ("mut_nofix", ["--fs", "48000", "--frames", "240", "--pwd", "0.316", "--jit", "0.195",
                   "--ppm", "0", "--seed", "7"], ["-DNOFIX"]),
    ("inj_early", ["--fs", "48000", "--frames", "240", "--pwd", "0.316", "--jit", "0.195",
                   "--ppm", "0", "--seed", "7"], ["-Ptb_core.INJ_EARLY=1"]),
    ("gap",       ["--fs", "48000", "--frames", "480", "--pwd", "0.2", "--jit", "0.195",
                   "--ppm", "0", "--seed", "5"], ["-Ptb_core.MAXCLK=1100000",
                                                  "-Ptb_core.GAP_AFTER_LOCK_US=2000",
                                                  "-Ptb_core.GAP_US=20"]),
    ("fb_dead",   ["--fs", "48000", "--frames", "240", "--pwd", "0.316", "--jit", "0.195",
                   "--ppm", "0", "--seed", "7"], ["-Ptb_core.FB_DEAD_AFTER_LOCK_US=200"]),
    ("clk_stop",  ["--fs", "48000", "--frames", "240", "--pwd", "0.316", "--jit", "0.195",
                   "--ppm", "0", "--seed", "7"], ["-Ptb_core.CLKS_STOP_AFTER_LOCK_US=300"]),
    ("bit_err",   ["--fs", "48000", "--frames", "240", "--pwd", "0.316", "--jit", "0.195",
                   "--ppm", "0", "--seed", "7", "--kill-edge-frame", "120"], ["-Ptb_core.NO_INJECT=1"]),
    ("si_start",  ["--fs", "48000", "--frames", "240", "--pwd", "0.316", "--jit", "0.195",
                   "--ppm", "0", "--seed", "7"], ["-Ptb_core.SI_START_HZ=250000000.0"]),
    ("capture",   ["--fs", "48000", "--frames", "840", "--pwd", "0.316", "--jit", "0.195",
                   "--ppm", "0", "--seed", "7"], ["-Ptb_core.MAXCLK=1750000", "-Ptb_core.NO_INJECT=1",
                                                  "-Ptb_core.CAPTURE=1"]),
    ("fade",      ["--fs", "48000", "--frames", "1400", "--pwd", "0.316", "--jit", "0.195",
                   "--ppm", "0", "--seed", "7"], ["-Ptb_core.MAXCLK=3000000", "-Ptb_core.FADE_TEST=1",
                                                  "-Ptb_core.FADE_LOG2=8"]),
    ("lease", ["--fs", "48000", "--frames", "300", "--pwd", "0.316", "--jit", "0.195",
               "--ppm", "0", "--seed", "7"], ["-Ptb_core.LEASE_TEST=1", f"-Ptb_core.INJ_LEASE={LEASE_CLK}"]),
    ("si_off", ["--fs", "48000", "--frames", "480", "--pwd", "0.316", "--jit", "0.195",
                "--ppm", "0", "--seed", "7"], ["-Ptb_core.MAXCLK=1100000", "-Ptb_core.SI_START_HZ=125000000.0",
                                               "-Ptb_core.SI_OFF_AFTER_LOCK_US=200", "-Ptb_core.SI_OFF_US=1000",
                                               f"-Ptb_core.SI_LOST={SI_LOST_CLK}"]),
]


def prepare(name, stim, opts, work):
    d = work / name
    subprocess.run([sys.executable, "make_stim.py"] + stim + ["--out", str(d)], cwd=HERE,
                   check=True, capture_output=True)
    vvp = d / "tb.vvp"
    subprocess.run(["iverilog", "-g2012", "-o", str(vvp), "-s", "tb_core", f"-I{RTL}"] + opts + SRC,
                   cwd=HERE, check=True)
    return d


def full_checks(d, fade_log2=0, order=("DIN",)):
    truth = [l.strip() for l in (d / "frames.hex").read_text().split()]
    runs = [int(x, 16) for x in (d / "runs.hex").read_text().split()]
    cc.d_truth_ref = truth
    left = cc.as_left(d, truth)                      # the frames as they left us: J2/J3's truth
    fs = json.loads((d / "meta.json").read_text())["fs"]
    names = ["SI", "TX", "TDM", "UART", "MCLK", "I2S", "SPDF", "INJ", "FS", "WD"]
    res = [cc.check_si514(d), cc.check_tx(d, runs), cc.check_tdm(d, left),
           cc.check_uart(d, truth), cc.check_mclk(d), cc.check_i2s(d, left), cc.check_spdif(d, fs),
           cc.check_inject(d, truth, fade_log2, order), cc.check_fs(d), cc.check_wd(d)]
    return dict(zip(names, res))


def main():
    ap = argparse.ArgumentParser()
    ap.add_argument("--only")
    ap.add_argument("--work", type=Path, default=HERE / "work")
    a = ap.parse_args()
    todo = [c for c in CORNERS if not a.only or c[0] == a.only]
    dirs = {}
    for name, stim, opts in todo:                    # strictly one simulation at a time
        dirs[name] = prepare(name, stim, opts, a.work)
        subprocess.run(["vvp", "-n", "tb.vvp"], cwd=dirs[name], stdout=subprocess.DEVNULL,
                       stderr=subprocess.DEVNULL, check=True)
    fails = 0
    for name, d in dirs.items():
        print(f"== {name}")
        if name == "gap":
            ok = cc.check_gap(d, 48000) & cc.check_wd(d)
        elif name == "fb_dead":
            ok = cc.check_fbdead(d, 48000) & cc.check_wd(d)
        elif name == "clk_stop":
            ok = cc.check_clkstop(d)
        elif name == "si_off":
            ok = cc.check_sioff(d, 48000, SI_LOST_CLK / 99.0) & cc.check_wd(d)
        elif name == "bit_err":
            ok = cc.check_err(d, 48000) & cc.check_wd(d)
        elif name == "lease":
            truth = [l.strip() for l in (d / "frames.hex").read_text().split()]
            ok = cc.check_lease(d, truth, LEASE_CLK / 99.0, 48000) & cc.check_wd(d)
        elif name == "capture":
            truth = [l.strip() for l in (d / "frames.hex").read_text().split()]
            ok = cc.check_capture(d) & cc.check_uart(d, truth) & cc.check_wd(d)
        else:
            r = full_checks(d, 8, ("DIN", "DIN2")) if name == "fade" else full_checks(d)
            if name == "mut_nofix":
                ok = not r["INJ"] and all(v for k, v in r.items() if k != "INJ")
                print(f"MUT : {'PASS' if ok else 'FAIL'}  with the parity fix off, INJ "
                      f"{'fails and nothing else does' if ok else 'is not the only failure'}")
            else:
                ok = all(r.values())
        fails += not ok
    print(f"\n{'all corners pass' if not fails else f'{fails} corner(s) FAIL'}")
    return 1 if fails else 0


if __name__ == "__main__":
    sys.exit(main())
