Oleg-mk/MOST25-to-AUDIO/listener_gw/sim/sweep_core.py

#!/usr/bin/env python3
"""sweep_core.py - the whole-core test over many random rings, not two.

A test proves only the case it runs; a bug that needs an unlucky coincidence
(the FIFO restart found in the Si514 block needed the write pointer in one
range when the read side came back) slips past two fixed stimuli. So each run
here draws its own case:
  rate 48 or 44.1 kHz (alternating), pulse-width distortion -0.15..+0.316 UI
  (the SP4 limits), edge jitter 0.1..0.195 UI, ring offset -1000..+1000 ppm,
  the Si514's own crystal error -100..+100 ppm (the widest stability grade
  on the shelf), its I2C address 0x08..0x77 and its start-up frequency (10 to
  250 MHz), the preamble's run pattern (the placeholder or the S/PDIF-like set
  with two 3-UI runs),
  whether "inject" is sent before the Si514 is centred, and a fresh seed.
Every third run also kills the line for 5..50 us, 2 ms after LOCK.

  clean run  every check of check_core.py must pass (SI, TX, TDM, UART, MCLK,
             I2S, INJ, FS)
  gap run    check_core.check_gap: LOCK down within 5 us of the dead line, back
             after it; the Si514 centred once, no small change outside its
             window, nothing addressed wrongly
720 frames per run (840 with a dead line): the simulation loop (8-frame rate
measurement, fn 150 Hz) takes ~7 ms to lock when the Si514's crystal is 50 ppm
off - the centring cannot see that error - and the host's commands and the
dead line come after LOCK.

Runs go one at a time (--jobs 1, the default: several vvp at once have
frozen the machine); a failing run's directory is kept whole under work/sweep/.
Usage: python sweep_core.py [--runs 32] [--jobs 1] [--base 1000] [--only 3 7 ...]
                            needs oss-cad-suite on PATH
"""
import argparse
import contextlib
import io
import random
import shutil
import subprocess
import sys
from concurrent.futures import ThreadPoolExecutor
from pathlib import Path

import check_core as cc
from run_core import RTL, SRC, full_checks

HERE = Path(__file__).resolve().parent


def case(i, base):
    r = random.Random(base + i)
    c = dict(
        i=i,
        fs=48000 if i % 2 == 0 else 44100,
        pwd=round(r.uniform(-0.15, 0.316), 3),
        jit=round(r.uniform(0.1, 0.195), 3),
        ppm=round(r.uniform(-1000.0, 1000.0), 1),
        si_ppm=round(r.uniform(-100.0, 100.0), 1),
        addr=r.randrange(0x08, 0x78),
        early=r.random() < 0.3,
        pre=r.choice(["default", "spdif"]),
        start_hz=r.choice([49.152e6, 10e6, 100e6, 156.25e6, 250e6]),
        seed=r.randrange(1, 10 ** 6),
        gap_us=round(r.uniform(5.0, 50.0), 1) if i % 3 == 2 else 0.0,
    )
    c["frames"] = 840 if c["gap_us"] else 720
    return c


def run(c, work):
    d = work / f"run{c['i']:03d}"
    if d.exists():
        shutil.rmtree(d)
    subprocess.run([sys.executable, "make_stim.py", "--fs", str(c["fs"]), "--frames", str(c["frames"]),
                    "--pwd", str(c["pwd"]), "--jit", str(c["jit"]), "--ppm", str(c["ppm"]),
                    "--preamble", c["pre"], "--seed", str(c["seed"]), "--out", str(d)],
                   cwd=HERE, check=True, capture_output=True)
    nclk = len((d / "samples.hex").read_text().split())
    opts = [f"-Ptb_core.MAXCLK={nclk + 1000}", f"-Ptb_core.SI_ADDR={c['addr']}",
            f"-Ptb_core.SI_PPM={c['si_ppm']}", f"-Ptb_core.INJ_EARLY={int(c['early'])}",
            f"-Ptb_core.SI_START_HZ={c['start_hz']:.1f}"]
    if c["gap_us"]:
        opts += ["-Ptb_core.GAP_AFTER_LOCK_US=2000", f"-Ptb_core.GAP_US={c['gap_us']}"]
    subprocess.run(["iverilog", "-g2012", "-o", str(d / "tb.vvp"), "-s", "tb_core", f"-I{RTL}"] + opts + SRC,
                   cwd=HERE, check=True, capture_output=True)
    subprocess.run(["vvp", "-n", "tb.vvp"], cwd=d, check=True, capture_output=True)
    return d
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
