Oleg-mk/MOST25-to-AUDIO/listener_gw/sim/dpll_model.py

#!/usr/bin/env python3
"""dpll_model.py - frame-level model of the Si514 clock loop, for choosing gains.

What is modelled (one step = one ring frame):
  ring      frame starts at k / (Fs (1 + d_ring)) plus Gaussian edge jitter
  sampler   every edge time-stamped on the local 792 Msps grid (27 MHz crystal
            off by d_xtal), floor to the sample - as rx_runlen does
  centring  L64 = 64 frame periods in samples; M_c = M_nom + (L_nom64 - L64) K
  Si514     f_r = FXO (1 + d_si) (M_c + u) / 2^29 / HS; a new u takes effect
            I2C_LAT after the update decision (write + 100 us settling)
  regen     TX frame k leaves 1024 / f_r after frame k-1; the FIFO starts half
            full; |delay - start| beyond FIFO_LIM samples = a slip (failure)
  detector  d_k = TX preamble stamp - RX preamble stamp (both on the sample grid)
  loop      every UPD frames: e = mean(d - target); PI in two gears
            (acquisition, then tracking once |e| < LOCK_E for LOCK_N updates)

Numbers from the Si514 data sheet Rev 1.2: FXO = 31.98 MHz, 0.026 ppb steps,
small changes settle within 100 us, +/-1000 ppm glitch-free window.

Usage: python dpll_model.py            prints a table of corners
"""
import math
import random

FXO = 31.98e6
FS_SAMP = 792e6
PLAN = {48000: (44, 36306575326), 44100: (48, 36389090270)}   # HS_DIV, M x 2^29
LNOM64 = {48000: 1056000.0, 44100: 64 * 792e6 / 44100}
K_CTR = {48000: 34381, 44100: 31660}                           # LSB per sample of L64
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
