Oleg-mk/MOST25-to-AUDIO/(commit log)

2026-09-26 Import the listener from most-bus at 08ea5fb
    MOST25 to AUDIO is the passive MOST25 listener that grew in most-bus next
    to a shelved STM32 + ADAU1466 design. It hears everything on the ring and
    has no address of its own; J3 plays the amplifier's sound in stereo with
    the head unit's volume, balance and tone. This repository starts clean with
    only what the listener needs, chosen by dependencies, not by file dates:
    - listener_hw: the schematic generator, the KiCad project, its symbols and
    footprints (title block: MOST25 to AUDIO, rev 0.2);
    - listener_gw: the FPGA code, the Tang Nano 20K build, the simulations;
    - listener_fw: the ESP32 host firmware, its ESP-IDF settings, host tests;
    - virtual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
    [most_listener.kicad_sch]
2026-09-26 Preamble: anchor tx_pre and inject on the frame, test more than one shape
    The MOST specs do not give the preamble's run pattern. The receiver never
    needed it, but tx_pre stamped every 2.5..3.5 UI run and inject took a
    second 3-UI run inside a preamble for a lost frame - and the stimulus,
    its test and the FS checker all assumed exactly one 3-UI run per
    preamble, the placeholder's shape. With S/PDIF-like preambles (3-3-1-1,
    block start 3-1-1-3) the whole core still locked, 3x later and with
    twice the Si514 corrections, and injection never happened (0 of 34
    frames), while every existing test kept passing.
    - tx_pre: one event per frame - a 3-UI run counts only 1016 UI or more
    after the last a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
    [check_core.py, inject.v, run_core.py, run_rx.py, sweep_core.py, tx_pre.v]
2026-09-26 Ride through one error on the line instead of switching the ring for it
    One wrong pulse on the ring cost 200 ms of bypass and two phase steps:
    the framer unlocked on the first coding error, that emptied the
    regenerator's FIFO, LOCK fell, and HOLD_RE held it off. A MOST node
    unlocks only after two invalid preambles (Oasis EP 1333580 B1); the
    oPHY's timing limits are given for an error rate of 1e-9, one bad bit
    every 40 s at that rate.
    - rx_framer: one strike - a coding or framing error ends the frame (not
    emitted) but keeps the lock; the next frame must open with a 3-UI run
    where it is due (1024 or 2048 UI after this frame's UI 0, within 4 UI)
    and a clean frame clears the strike; a lat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
    [check_core.py, inject.v, listener_core.v, regen.v, run_core.py, tb_core.v, tb_rx.v]
2026-09-26 J2 and J3 carry the frame as it leaves the listener
    tdm_out and amp_out took their bytes from the received line, while
    inject.v changed only the regenerated TX. With the phone playing into the
    car's AUX channels the factory amplifier after us heard the phone, but J3
    (and J2) carried the car's own AUX bytes: speakers moved to a DSP fed
    from J3 would never hear the phone. The two headline features excluded
    each other, and nothing said so.
    - inject: hands over the set used for the frame just ended (on, width,
    the six positions and bytes) as prev_*
    - tdm_out / amp_out: take that set when their frame counter wraps (128 UI
    after the receiver completed the frame; the regenerator's delay is
    1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
2026-09-26 Hold the ring-clock domain in reset until the Si514 is centred
    A Si514 off the shelf powers up at its factory frequency, anything to
    250 MHz; the ring-clock domain is built for 50. Its reset was released
    as soon as the output ran, so until the first centring the regenerator,
    TDM, J3, the injector and MCLK (out on J2 and J3) ran on that frequency,
    out of timing above 78 MHz - and the model always started at 49.152 MHz
    (START_HZ declared, never used), so no test could see it. The README
    said the start-up frequency does not matter; now it does not.
    - listener_core: rr_hold includes ~centred; the reset shift register is
    initialised in reset (it had no init value: one clk_r of not-reset at
    p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
    [check_core.py, listener_core.v, run_core.py, si514_model.v, sweep_core.py, tb_core.v]
2026-09-26 Board: about 1 A for the host module's supply, not 0.52 A
    U10 (TPS2553) limited 5V_HOST to 0.52 A typ (0.475-0.565 A, R22 49.9k).
    Espressif asks for a 500 mA supply for the ESP32 module and its radio
    draws it in peaks: a brown-out reset waiting to happen, with 1 uF behind
    the switch. R22 24.9k (about 1 A; the limit scales with 1/R from the
    table's 0.52 A at 49.9k), C24 10 uF. The sheet and its PDF regenerated;
    ERC 0/0.
    [most_listener.kicad_sch]
2026-09-26 Scripts: one simulation at a time by default; reproducibility over every generated file
    sweep_core started 16 vvp at once by default and run_core all of its
    corners in parallel - what froze the machine on 2026-09-26; check_all
    worked around both. Now sweep_core defaults to --jobs 1 and run_core runs
    its corners one after another.
    check_all's reproducibility check compared only the sheet the generator
    writes; it now covers the symbol library, the footprint, the project file
    and both library tables. erc.rpt, rewritten with the date on every run,
    is no longer tracked.
    [run_core.py, sweep_core.py]
2026-09-26 README: the limits by design, the bring-up order, the open TVS decision
    - the host learns what plays only from telegrams it happens to hear; at a
    cold start that is a race with the head unit's first Connect, and it
    stays so because asking would end the listener's silence
    - cars whose AUX is mixed inside the head unit cannot take the phone
    - bring-up: bypass only first (settles preamble, block marker, parity
    from a real ring), then regeneration, then injection and J3
    - D2 (SMBJ26CA) conducts from 29 V: a suppressed load dump would destroy
    it while the 36 V buck rides it out - to decide against the buck's
    absolute maximum and the chosen ISO profile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
2026-09-26 Constrain the TX_PRE path to U9; pipeline the paths the new logic pushed under the rule
    The one ring-critical output was never checked: TX_PRE goes to U9, which
    retimes it on the next Si514 edge, and no constraint covered the FPGA's
    clock-to-out against U9's setup and hold. tangnano20k.sdc now has it
    (set_output_delay -max 3 / -min -1 on clk_1024); the other outputs and
    DIN keep half a BCLK of margin by construction and are documented.
    The one-error policy and the outputs carrying the outgoing frame took the
    logic from 21 to 31 %, and clk_s fell to 99.5 MHz against 99. Eight
    builds, each showing a different path under the 10 % rule as placement
    moved; every one is now a register stage earli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
    [amp_out.v, dpll.v, inject.v, tb_core.v, tb_dsp.v, tdm_out.v, tx_pre.v]
2026-09-26 Capture: the line's run lengths kept in the FPGA, dumped to the host, read by a tool
    Everything the simulations could only assume about a real MOST25 line -
    the preamble's run pattern, which preamble marks a block, the parity
    rule, the frame control bits - is read off one recording. This is the
    recording.
    - rtl/capture.v: every run rx_runlen measures on RX_IN (length in
    samples, glitch flag) into 65536 x 9 bits of BSRAM (32 blocks, ~85
    frames); capturing from power-up on its own, so the ring's start-up
    is kept until asked for; command 04 (M bit 0 capture anew, bit 1 dump,
    bit 2 dump when full); a dump as 41-byte packets (A5 C5, seq, 32
    lengths, glitch flags, XOR) and a trailer wit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
    [capture.v, capture_analyse.py, check_core.py, ctrl_uart.v, host.c, listener_core.v, lsn_link.c]
2026-09-26 S/PDIF out and a second audio input: J3's L R on TOSLINK and coax, DIN2 chosen by command 02
    spdif_tx.v sends the pair amp_out latches for I2S once more as S/PDIF
    (IEC 60958-3, consumer, 24 bit): biphase mark at 128 Fs = clk_r / 8, so the
    stream is synchronous to the ring and nothing is resampled; X/Y/Z
    preambles, even parity, channel status with the ring's rate (44.1 or 48 kHz,
    from the receiver's UI estimate, two flip-flops into clk_r) and 24-bit
    words. The block counter counts whole frames only, so a stream that starts
    or restarts opens with Z. One pin, 31 (LCD_B3), drives the board's TOSLINK
    transmitter and the coax divider.
    inject takes its samples from DIN (the host M2) or DIN2 (the b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
    [amp_out.v, capture.v, check_core.py, ctrl_uart.v, inject.v, listener_core.v, run_core.py]
2026-09-26 Board: block 9, TOSLINK in through DIR9001 and SRC4192, S/PDIF out on TOSLINK and coax
    J5 (PLR135/T10) -> R25 -> U12 DIR9001 in hardware mode: PLL clock recovery
    from the signal, 24-bit I2S out (FMT = HH), CKSEL = L, XTI to ground (no
    crystal; the frequency calculator is not used), the loop filter of Table 6.
    U13 SRC4192 with both ports slave (MODE = 000): the receiver's I2S on the
    receiver's clock in (IFMT = 001), I2S 24 bit on the FPGA's BCLK/LRCK out
    (OFMT = 01, OWL = 00) -> I2S_DIN2_F, pin 54. X1 24.576 MHz is the rate
    estimator's reference (RCKI), asynchronous to both ports. One RC gives
    both chips their reset 10 ms after 3V3_SW, when X1 already runs (the
    SRC4192 has no power-on reset).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
    [most_listener.kicad_sch]
2026-09-26 Firmware: the TOSLINK input as the audio-in source, chosen with key i, live while its receiver is locked
    lsn_cmd_inject takes the source: command 02 M[2] = 1 names DIN2, the
    board's S/PDIF receiver through its sample-rate converter. The host reads
    the receiver's ERROR pin on IO32 (M2 pad 7; pulled up, so a board without
    the receiver never injects from it) and treats the TOSLINK input as live
    while it is low, as it treats the phone as live while A2DP streams; the
    console key i switches between the two, the status line and the log say
    which and whether it is locked. Host tests pass (the new command byte
    checked), the ESP-IDF build is 956 KB.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
    [host.c, lsn_link.c, lsn_link.h]
2026-09-26 Board: the battery input for ISO 16750-2 test B and ISO 7637-2 pulses - LMR38020, SMBJ36A before D1, a slow fuse
    The SMBJ26CA behind the reverse diode conducted from 28.9 V: a suppressed
    load dump (35 V, up to 400 ms, 0.5..4 ohm) that the buck itself survives
    would have burnt it and blown F1, and a negative pulse 1 (-150 V, 10 ohm)
    reached D1's 40 V reverse rating before any TVS clamped it. A TVS silent at
    35 V clamps the fast pulses at 42..53 V, above the LMR33630's 38 V absolute
    maximum, so the buck had to change too.
    Now: U6 LMR38020F (4.2..80 V in, 85 V absolute maximum, 2 A, 400 kHz from
    R31 = 64.9 k per Table 8-1, forced PWM so the frequency never falls into the
    audio band; L1 15 uH a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
    [most_listener.kicad_sch]
2026-09-27 Board: two electrolytics with ceramic shunts at the buck's input, against the harness's ringing
    C44, C45 100 uF / 63 V with C46, C47 100 nF / 100 V beside them on VBAT_P at
    U6's input: the car's harness is long, and its inductance rings with ceramic
    capacitors alone on load steps (LMR38020 data sheet 9.2.2.6 asks for an
    electrolytic in parallel). ERC 0 violations, PDF regenerated.
    [most_listener.kicad_sch]
2026-09-27 Board: footprints from the makers' drawings - the TOSLINK T10 housings, BKL's RCA jack, Tang Nano 20K, ESP32-DevKitC
    Generated into most_listener.pretty like the Si514's: Everlight_TOSLINK_T10 for
    J5 and J6 (3 pins 0.80 on 2.54, two pegs 1.10 at 5.08 spacing 2.63 behind, the
    port 1.24 in front of the pins - DPL-135-017 p.2, DPL-0000049 Rev.5 p.4);
    BKL_0101153_RCA_RA for J7 (the centre pin on the axis, a thin pin 2.5 beside
    it whose function the drawing does not give - pad 3, to be measured on a
    sample - and the two 2.0 legs 10.1 apart 5.1 towards the port; body 14.7 x
    14.8); Sipeed_TangNano20K for M1 (54.04 x 22.55, 2 x 20 on 2.54, rows 20.32
    apart, the HDMI's 8 mm overhang in the courtyard)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
    [most_listener.kicad_sch]
2026-09-27 Board: block 9 on its own 3.3 V, U14 LP5907 from 5V_SW, not on the module's regulator
    3V3_DA feeds the DIR9001, the SRC4192, X1 and both TOSLINK modules: the Tang
    Nano's regulator (3V3_SW) has an unknown margin and the block takes about
    0.1 A; a regulator of its own also keeps the receiver's PLL and the ASRC off
    the FPGA's supply noise. Same part and wiring as U8 for the Si514.
    [most_listener.kicad_sch]
2026-09-27 Board: L2 SRN8040-220M between D1 and VBAT_P keeps the buck's 400 kHz off the harness
    22 uH, 3 A, semi-shielded, with the capacitors behind it a pi filter: about
    40 dB at 400 kHz against the electrolytics' ESR, which also damps the
    2.2 kHz resonance (zeta about 1.6), so no ringing on load steps and no dip
    under the buck's 4.2 V; 0.1 V across it at 1.5 A. Not for the ISO pulses -
    the 235 uF on VBAT_P already turn pulse 2a into a 5 V rise - but for the
    amplifier that hangs on the same harness.
    [most_listener.kicad_sch]
2026-09-27 Board: test points for the bench - RX_BUF, TX_REGEN, TX_SEL, WAKE, RT_CLK, the rails, GND
    Block 10: 2 mm pads on the signals a scope must see in the bring-up order
    (bypass, regeneration, injection) that are not on the module's header: the
    FOT's line after U1, U9's retimed TX, U11's decision, the wake one-shot, the
    Si514's clock at U9, 3V3_AON, 5V_SW and two grounds.
    [most_listener.kicad_sch]
2026-09-27 Board: D4, an ESD diode on the coaxial output's centre pin
    PESD5V0S1BL (SOD-882, bidirectional, 0.1 pF class) from J7's centre pin to
    ground: the jack is an outside connector and its only other protection was
    240 ohm and 100 nF in front of the FPGA pin.
    [most_listener.kicad_sch]
2026-09-27 Board: block 10 laid out clear of its text, the footprints' port marks moved off the pads; README names the footprints
    [most_listener.kicad_sch]
2026-09-27 Board: block 10's frame wide enough for its text
    [most_listener.kicad_sch]
2026-09-27 Board: J1's footprint from TE's drawing - the MOST pigtail FOT unit, measured off C-2-2141577-1
    TE's specifications (114-18997 A3, 108-94198 B) give the pin allocation and
    the mounting rules but refer to the product drawing for the layout, so the
    footprint is measured off the customer view model drawing the user supplied:
    2:1 views, the front view (contacts down) for the x positions, the side view
    for the depths. Eight 0.5 mm pins in one row on 2.54 with 3.86 between pins
    4 and 5 (TX 1..4 data, GND, VCC, CONT; RX 5..8 VCC, GND, MODEout, Vout), two
    2.0 mm standoffs, two 0.4 mm action pins in 1.8 mm plated holes (pad 0, the
    symbol's shield pin: they may be soldered), four guide legs; the optic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
    [most_listener.kicad_sch]
2026-09-27 Board: PCB placed - gen_listener_pcb.py lays out 130 x 90 mm from the sheet; J4 Molex Micro-Fit; J1's rear silk broken around the guide legs
    listener_hw/gen_listener_pcb.py (run with KiCad's own Python, which carries
    pcbnew) takes the netlist kicad-cli exports from most_listener.kicad_sch,
    loads the footprints from most_listener.pretty and KiCad's libraries, places
    every part at the (x, y, rotation) PLACE names - the docstring says what
    sits where and why - and writes most_listener.kicad_pcb: two layers, the
    outline, four M3 holes, GND pours on both sides, a copper keep-out under
    M2's PCB antenna, the net classes (Default 0.25 mm / 0.15 clearance, Power
    0.6 mm) into most_listener.kicad_pro,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
    [most_listener.kicad_pcb, most_listener.kicad_sch]
2026-09-27 Board: routed - FreeRouting session imported by the generator; J4 a right-angle Micro-Fit on the left edge; U14 in the corridor; Rail net class
    most_listener.ses is FreeRouting 2.4.1's session for the exported placement
    (-mp 100 -mt 1, about four minutes); gen_listener_pcb.py imports it when it
    lies beside the sheet, lays the top ground pour over the tracks, fills both
    pours and saves - so the routed board, too, is reproduced from the committed
    files (check_all.py now diffs the .kicad_pcb and the generated .kicad_dru as
    well). DRC: no error, no unconnected item; the twelve warnings are the flush
    connectors' silk clipped by the board edge.
    What it took: the Specctra export carries only the b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
    [most_listener.kicad_pcb, most_listener.kicad_sch]
2026-09-27 Board: copper removed - routed by hand in KiCad from here; the generator only lays out (--fresh) and never overwrites the board
    The FreeRouting result is gone: the battery path hopped layers for no
    reason, the electrolytics' ground pads looped through the 100 nF caps instead
    of dropping into the pour, and the rest was of the same kind. An autorouter
    does not make the decisions a power block, a clock line or a receiver front
    end need; from here the board is routed by hand in the PCB editor.
    most_listener.kicad_pcb is therefore the master file: parts may be moved
    freely, and gen_listener_pcb.py refuses to overwrite it unless run with
    --fresh, which lays the parts out again from PLACE and disc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
    [most_listener.kicad_pcb]
2026-09-27 Board: block 11, analog line out - PCM5102A on J3's stereo into the two RCA jacks placed by hand; footprints linked to the sheet
    Sheet, block 11: U15 PCM5102A in hardware mode (FMT, FLT, DEMP low: I2S,
    normal latency, no de-emphasis), SCK grounded so its PLL takes the clock from
    BCK - three wires, the same I2S_BCLK_F / I2S_LRCK_F / I2S_DOUT_F that feed
    J3 (64 Fs, 32-bit slots). XSMT from LOCK: muted while the ring is not locked
    and while the FPGA is unconfigured (R8 holds LOCK low), with the chip's
    104-sample soft ramp; no new FPGA pin, no gateware change. Outputs 2.1 Vrms
    ground-centred through 470R + 2n2 C0G (TI SLAS859C Figure 33) to J8 (L) and
    J9 (R), a PESD5V0S1BL at each jack as D4 at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
    [most_listener.kicad_pcb, most_listener.kicad_sch]
2026-09-28 Board: the user's regroup, reviewed - 33R singles under M1 at their FPGA pins, U14 back in block 9, block 9 turned to its jacks, the capacitor copies out
    The user regrouped the board: M2 upright against M1 with both USB ends at
    the top edge, every audio jack (TOSLINK in and out, coax, the two line-out
    RCA) on the right edge, block 9 beside them, the host switch and the test
    points in the bottom middle, a sixth mounting hole (H6) on the left edge.
    Agreed after review and done here:
    - Sheet: RN1 and RN2 (4 x 33R arrays) became single 0603 resistors, R34..R41,
    so each FPGA output to J2/J3 has its own. With R18..R21 they sit under M1,
    each beside its FPGA pin (source termination: MCLK, BCLK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
    [most_listener.kicad_pcb, most_listener.kicad_sch]
2026-09-28 Board: M1 and M2 left into the strip the user freed; resistors of M1's pins under it; signal test points above J1
    The user cleared a vertical strip left of M1 and asked for the FPGA to move
    into it, part of the resistors to go under the module, and the signal test
    points to go to the left edge above the MOST header.
    - The ring-logic column (U3, U9, R16) with R17 moved into the strip; M1
    followed it 6.7 mm to the left and M2 with M1, the two modules still side
    by side; the antenna keep-out moved with M2. The free space now lies
    between M2 and block 9, a channel for M2's signals to the right half.
    - Under M1, each beside its pin, as before for J2/J3's 33R: R20 (pin 1,
    UART_RX_F), R14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
    [most_listener.kicad_pcb, most_listener.kicad_sch]
2026-09-28 Board: narrowed to 123 x 90 mm; TP2 (TX_REGEN) and TP5 (RT_CLK) removed
    The user asked for the board to be narrowed and for the probe points on
    TX_REGEN and RT_CLK to go: no extra stubs on the regenerator's output into
    the ring and on the Si514's clock into U9. Both come out of the sheet
    (block 10's note says where the two can still be probed: U9's pins, M1's
    TX_FB pin) and off the board; the signal points above J1 now are RX_BUF,
    TX_SEL and WAKE, each beside a ground point.
    Narrowing: the user had moved H5, J3 and J2 into the free strip right of M2.
    Everything else right of the strip - block 9, the coax divider and J7, the
    line-out block, the jacks on the right edge, the corner holes - mov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
    [most_listener.kicad_pcb, most_listener.kicad_sch]
2026-09-28 Board: 123 x 85 mm - the bottom edge up to the lowest part, the six M3 holes 4 mm from their edges
    The user moved the battery input (F1, D2, D1, L2, C44, C45, C47) into the
    empty bottom middle, U16 and C51 beside it, TP1 and TP4 elsewhere, M2 up a
    little, and the two lower holes up, then asked for the height to shrink and
    the M3 holes to be made uniform.
    The bottom edge now sits 0.3 mm below the lowest courtyard (C47): the board
    is 84.65 mm high instead of 90. Every hole is 4.0 mm from the edge it sits
    at, as H1 and H2 always were: H3 and H4 at 4.0 mm above the new bottom edge
    (H4 stays left of J8, where the user put it), H5 4.0 mm below the top, H6
    and H3 4.0 mm in from the left. The groun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
    [most_listener.kicad_pcb]
2026-09-28 Board: 125 x 80 mm - 1 mm off the top, the bottom up to 80 mm, the right edge 1.75 mm out
    Asked for by the user: C44/C45 and the lower holes up so the board is
    125 x 80 mm, with 1 mm off the top and the rest off the bottom.
    - Top: the outline starts 1 mm lower and the whole board moved up by that
    1 mm, so the top holes H1, H2, H5 stay 4.0 mm from the edge. M2's USB
    socket now reaches 0.65 mm past the top edge, as a socket at the edge should.
    - Bottom: the new edge is 80 mm down. C44 and C45 moved up 3.6 mm together,
    C47 beside C45; F1, D1, D2 and L2 up by 0.45 to 1.3 mm; J8 and J9 up
    1 mm with D6/C62; J4 up 0.5 mm to clear H3; C53 and C61 moved to clear
    H4. H3 and H4 sit 4.0 mm ab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
    [most_listener.kicad_pcb]
2026-09-28 Board: silk pass on the final placement - DRC with no error and no warning
    The user settled the placement (moving C44, H4 and M2 a little last) and
    asked for the silkscreen to be put right: 94 silk warnings before, none now.
    - The edge connectors' own silk no longer reaches the board edge: the MOST
    header (J1), the TOSLINK modules (J5, J6) and the RCA jacks (J7, J8, J9)
    have their outline open on the port side, the sides ending 0.4 mm behind
    the port face (for J1, 0.4 mm inside the edge its foot line marks); the
    board's copies were refreshed from the library, so they match it. J4, a
    KiCad library part, moved 0.6 mm in from the left edge instead.
    - Every silk text was placed again: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
    [most_listener.kicad_pcb]
2026-09-28 Board: routed - one ground plane below, crossed only by short jumpers; signals and supplies on top
    - supplies laid by hand: the 5 V trunk 1 mm wide from C7 up the left edge under J1 and along
    the top edge; VBAT from the input caps round the bottom into C43, C4 and U6; 3V3_AON from the
    LDO with two jumpers (1.9 mm under VBAT at C3, 2.4 mm under the trunk into the front end);
    R4's sense on top under L1
    - the host switch U10 with C23, C24 and R22 moved to M2's 5 V pin: /5V_HOST no longer crosses
    the signals from M1 to the right half
    - a via beside every SMD ground pad; the top pour stitched to the plane about every 6 mm
    - signals on top, the crossings as jumpers: 75, 174 mm in all, the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
    [most_listener.kicad_pcb]
2026-09-28 Board v1.2: pins swapped on the FPGA and host modules - the bus under M2 runs without a crossing, 33 jumpers instead of 75
    - M1: every line bound for the right half leaves the right row in the order it meets J2, J3,
    the DAC and the host; LOCK and S/PDIF swap their LCD-only pins (LOCK on the left row beside
    U11); U13 gets its own copies of BCLK and LRCK (pins 73, 74) and returns DIN2 on 75, over the
    top of the module; PA_EN held low, as the module's amplifier now shares pins 54..56 with J2
    - M2: BCLK IO22, LRCK IO23, DIN IO21, UART RX IO4 / TX IO15, OPT_ERR IO13 - on the row that
    faces M1; firmware and its pin table follow
    - J2 now 1 SD0, 2 SD1, 3 FS, 4 MCLK, 5 UART_TX, 6 BCLK; J3 now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
    [most_listener.kicad_pcb, most_listener.kicad_sch]
2026-09-28 Board v1.3: the TOSLINK input's AUDIO flag to the host and the ASRC's RDY to its MUTE; the audio-in source chosen by itself
    - firmware: the source picks itself (components/mostctl/ain): the phone while it streams,
    otherwise the TOSLINK input once its receiver has held lock on PCM for 1 s; a parity
    error's blip is kept, 100 ms of ERROR loses it; its lock time runs while the phone plays;
    key i gone
    - the DIR9001 passes non-PCM (AC-3, DTS) to DOUT untouched (SLES198A 8.3.9.2): its AUDIO pin,
    channel-status bit 1, now reaches M2 IO27 (OPT_NPCM, pulled up); high drops the TOSLINK input
    at the first reading, and the console says to set the source to PCM
    - the SRC4192's RDY drives its MUT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
    [most_listener.kicad_pcb, most_listener.kicad_sch]
2026-09-29 Injection fades: every change the host asks for reaches the amplifier through silence, 256 frames a ramp
    - inject.v: the pair goes out times g/256 (registered, 24 x 10 bit in two DSP multipliers), g one
    step a frame, 256 >> FADE_LOG2 (default 8: 256 frames, 5.3 ms at 48 kHz, 5.8 ms at 44.1 kHz)
    - on: HOLD (3) frames of silence, then up; off: down on the bytes in use, then the ring's line;
    another source (M[2], the phone against the TOSLINK input): down, DIN switched at g = 0, HOLD
    frames while its first whole pair comes through, up; other bytes: from silence at once (the old
    ones may already be another source's); the safety stops stay immediate, the next start rises
    - sim: tb_core.v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
2026-10-01 Board v1.4: placed again by hand and routed again - 11 jumpers instead of 37; the line out buffered by an OPA1678
    The user re-placed the board group by group - the ring and clock cluster round
    J1, the S/PDIF group (U12, U13), the DAC, the power corner - and every round was
    routed again on top: 37 jumpers became 11, 83 mm of bottom copper 29, vias 407
    became 300. The 11 left are short (5.3 mm at most) and sit where pin orders or a
    walled pin leave no way on top.
    Line out (block 11): U17, an OPA1678 on 5V_SW and VNEG_A (-5.2 V from U18, a
    TPS60403), makes a unity-gain Sallen-Key low-pass per channel - R32/R33 and
    R43/R44 4k7, C69/C70 820p, C71/C72 390p: 60 kHz, Q 0.72 - then 100R, 2n2 and the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
    [most_listener.kicad_pcb, most_listener.kicad_sch]
2026-10-01 Steering-wheel keys to the phone: the Jaguar XF's next and previous (FktID 0xCA1) become AVRCP Forward and Backward while the phone plays in AUX
    The gateway (0x161) sends the wheel's track keys to the touchscreen (0x16E);
    with the factory screen in the car they are on the ring. wheel (mostctl)
    takes them as SocketMost (branch usb) acts on them - FktID 0xCA1, next Data0
    0x03 with Data1 0x01, previous Data0 0x04 with Data2 0x01, nothing else
    checked - and counts the same telegram again within 200 ms once (a NAKed one
    comes up to 6 times); a release in between ends that.
    While command 02 puts the phone into the AUX bytes, host.c hands a key to
    phone_ctl, which sends it to the phone as an AVRCP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
2026-10-01 Board v1.4: RST_AIN's jumper 3.4 mm instead of 5.3 after the user raised U12 and C38; the modules' sockets in the 3D view
    The user raised U12 by 0.26 mm and moved C38 to the top of the gap between U13
    and U12. RST_AIN now runs down that gap and crosses under U12's left row at pin
    9 (not connected) into the body: 3.4 mm of bottom copper instead of 5.3. U12's
    copper follows its pads; its outputs to U13 run straight across.
    U13's 3V3_DA (pins 7, 10, 19, 22, X1, C39) reached the supply only over that
    gap, from U12.5 past C38's old place, which RST_AIN would now cross. It is fed
    from the left instead: the trunk at y 15.5 goes on past R30 and down beside
    U13's left row into pin 19. U13.16/17's GN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
    [most_listener.kicad_pcb]
2026-10-01 Board v1.4: M1 and M2 soldered on pin headers, no sockets
    The modules are soldered in. KiCad's 1x20 and 1x19 pin header models replace
    the socket models under M1 and M2, at the same origins (pin 1 at each row's
    first pad). The footprints' descriptions and the README say so.
    The headers' 2.5 mm of plastic is the room under each module. Under M1 sit
    only 0603 resistors, about 0.5 mm high: R11, R12, R18..R21 and R34..R41.
    Nothing sits under M2.
    DRC with --schematic-parity: no error, nothing unconnected, no difference.
    [most_listener.kicad_pcb]
2026-10-01 Board v1.4: J5/J6 on the T10 housing as Everlight draws it; TOSLINK and RCA bodies for the 3D view
    Everlight's T10 drawing is in third-angle projection: the numbered bottom view
    sits under the front view. The footprint had read it as first-angle. That put
    the pegs 2.63 mm behind the pins and the port 1.24 mm in front of them, so a
    real PLR135/PLT133 would have had its pegs 1.2 mm past the board's edge and
    its body about 10 mm off the board.
    As drawn, measured from the pins towards the port:
    - the pegs are 2.63 mm in front of the pins;
    - the front foot is 8.76 mm in front, and the side view dimensions the pins
    from it;
    - the port face is 11.11 mm in front;
    - the rear face is 2.39 mm behind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
    [most_listener.kicad_pcb]
2026-10-01 Board v1.4: the MOST FOT's body for the 3D view
    KiCad has no model for J1, the TE pigtail FOT unit (1-1394640-1).
    gen_listener.py now draws its body from the DXF of the customer view model
    drawing C-2-2141577-1, the same file the footprint was drawn from:
    - the housing, 25.2 wide and 12.8 high, on 0.45 mm standoffs round the two
    pegs;
    - the lower header behind it;
    - the oval port sleeve, 12 x 6, standing 3.5 out of the front, with the two
    fibre axes 6.0 apart and 6.85 up;
    - the pins, the action pins, the guide legs and the pegs.
    The DXF's four views agree with the footprint's holes: x from the front view,
    depth from the side view, the optical face at -y. The holes match usb2most's
    footp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
    [most_listener.kicad_pcb]
2026-10-01 Sheet PDF of v1.4, dated 2026-10-01
    most_listener.pdf dated from 2026-09-28. It still showed the v1.3 sheet,
    without the line-out buffer (U17, U18), C65..C68 or C78/C79. It is exported
    again from the current sheet.
    The sheet's and the board's title blocks now carry 2026-10-01, the day both
    last changed. The date is the only change to either file.
    [most_listener.kicad_pcb, most_listener.kicad_sch]
2026-10-01 The board's manufacturing package: listener_hw/fab, written by make_fab.py
    make_fab.py takes the board and the sheet and writes:
    - the Gerbers: top and bottom copper and mask, top paste and silkscreen, the
    outline (no part and no text sits on the bottom);
    - both Excellon drill files, plated and non-plated, in mm;
    - the Gerber job file;
    - a zip of those for the board house;
    - the BOM, grouped by value and footprint;
    - the pick-and-place file of the SMD parts;
    - a README.
    The README carries the board's numbers, read from the board itself: 125 x 80
    mm, 2 layers, 1.6 mm, tracks from 0.25 mm, clearance 0.15 mm, 293 vias of
    0.6/0.3, smallest hole 0.3 mm, no slots. It names ENIG as the finish, f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
    [most_listener-B_Cu.gbl, most_listener-B_Mask.gbs, most_listener-Edge_Cuts.gm1, most_listener-F_Cu.gtl, most_listener-F_Mask.gts, most_listener-F_Paste.gtp, most_listener-F_Silkscreen.gto, most_listener-NPTH.drl]
2026-10-01 Manufacturing package: JLCPCB's BOM and CPL for an order with the SMD parts assembled
    make_fab.py now also writes JLCPCB's two files from KiCad's BOM and
    pick-and-place:
    - most_listener-bom-jlcpcb.csv (Comment, Designator, Footprint, LCSC Part #,
    Manufacturer Part);
    - most_listener-cpl-jlcpcb.csv (Designator, Mid X, Mid Y, Layer, Rotation).
    The package README gains the order steps, the consigned part and the parts
    soldered by hand after delivery. The root README's parts row names the two
    files.
    make_fab.py's LCSC table holds the part for each BOM line, chosen on
    2026-10-01 from JLCPCB's parts library: a basic part where one fits, the
    maker's own part for every IC. A line without a choice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
    [most_listener-bom-jlcpcb.csv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]
2026-10-02 Board v1.4 polished: 6 jumpers (was 9), the user's re-placement routed by hand
    The user re-placed 57 parts in rounds: the DIR9001 group packed into three
    columns, J2/J3 moved with their bus, the line-out buffer and the power corner
    tightened, then R29, R30, R38, R40 and R41. Every net they touched was redrawn
    by hand; the autorouter's first pass (25 jumpers) was dropped.
    Three jumpers went with it:
    - SRC_BCLK: R29 sits where the line crossed under M2, and it runs between its
    pads.
    - RST_AIN: from U13.13 through U13's body and under C39/X1 into U12's body.
    U13's 3.3 V links moved outside its body (pins 19/22 left, 10/7 right, C39/X1
    fed from pin 7).
    - I2S_BCLK: R39 under M2 by M2.22. T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
    [most_listener-B_Cu.gbl, most_listener-B_Mask.gbs, most_listener-Edge_Cuts.gm1, most_listener-F_Cu.gtl, most_listener-F_Mask.gts, most_listener-F_Paste.gtp, most_listener-F_Silkscreen.gto, most_listener-NPTH.drl]
2026-10-02 Board v1.4: 4 jumpers (was 6), the user's last re-placement and the Si514 knot sketch
    The user moved the battery corner (F1 by J4, U5 up by U4, L2/D1/D2 left, C43/C2/C46
    turned to face U6), U10 and U14 with their capacitors, J2 and J3, and the DAC (U15 and
    its capacitors higher, U16 with C50/C51 beside U15, so 3V3_DAC is a short spine under
    U15's body); everything re-routed by hand.
    - Si514 corner, the user's sketch: RT_CLK takes one jumper under RX_BUF and SI_SCL;
    RX_BUF runs between the Si514's pad rows and over it, CLK+ round its west side, so
    the RX_BUF, SI_SCL and SI_SDA jumpers are gone. SI_SCL dips under 3V3_SW at M1's
    row instead of 3V3_SW jumping SI_SCL.
    - C80 (100n), C81 (10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
    [most_listener-bom-jlcpcb.csv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]
2026-10-03 Board v1.5: 122.5 x 78.9 mm, the user's denser placement routed
    The user packed the right and top edges tighter. The outline lost 2.5 mm on
    the right and 1.1 mm at the top. The DIR9001 group with U14 moved 1.7 mm
    left, J5..J9 and the line-out's output parts 2.4..3.1 mm, the top strip
    (U10, C23, C24, C63, C65, C80, C81, D3, R22) 2 mm down. Their copper moved
    with them; everything else kept its place and was patched only where a
    moved part now sits on it.
    - U13: C32, C38 and C40 in one row over its body, R30 under it beside C39
    (the user's sketches). C40.1 drops RST_AIN straight into the U13-U12 gap,
    now 1.1 mm wide, beside the 3.3 V feed that rises from U12.5 to the row's
    rail. U13's g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
    [most_listener-B_Cu.gbl, most_listener-B_Mask.gbs, most_listener-Edge_Cuts.gm1, most_listener-F_Cu.gtl, most_listener-F_Mask.gts, most_listener-F_Paste.gtp, most_listener-F_Silkscreen.gto, most_listener-NPTH.drl]
2026-10-03 Critical audit fixes (2026-10-03): injection lease, whole coefficient sets, telegram model, checked crossings
    An external critical audit of 7ff5d2f (R01-R12) found ways the listener could
    keep a stale or wrong state after errors and restarts. Every finding was
    checked against the code; R05 (U5's protection) the user had already accepted.
    - R01 inject.v: an "on" lasts 2 s after the host's last command 02 (the host
    repeats it every 0.5 s); a hung host can no longer leave our audio in the
    ring. Core corner `lease`: 15 frames injected for a 14.4-frame lease, then
    the ring's own line; without the lease the run lasts to the end (113).
    - R02 host.c: the control CRC still cannot be checked (n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
    [amp_model.c, amp_model.h, amp_out.v, audio_out.c, check_core.py, dsp_asm.py, host.c]
2026-10-04 FPGA on its own USB: clock-fed outputs held while the Si514 is gone, loop re-centred on its return
    With the Tang Nano on its USB and 5V_SW off (the ring asleep, a laptop on the
    module), the Si514 stops and every line on the ring clock froze, half of them
    at 3.3 V into unpowered parts (U13, U15, J6, M2).
    - listener_core.v: pads_on (the ring clock alive, registered) gates the TDM,
    MCLK, I2S and S/PDIF outputs. si_lost: the ring clock dead for 131072 clk_s
    cycles (1.3 ms) after the Si514 was centred; while it is set, the DPLL and
    the Si514 controller are held in reset and the I2C lines and uart_tx are
    held low. It clears when the clock returns.
    - A bug found on the way: after a Si514 p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
    [check_core.py, listener_core.v, run_core.py, si514_model.v, tb_core.v, top_tangnano20k.v]
2026-10-04 Board v1.6: Cliff TOSLINK jacks, series resistors at their drivers, JLCPCB silk and rotations
    - J5/J6: Everlight's PLR135/T10 is no longer made and PLR237/T10BK is not
    stocked, so Cliff's FCR684205R/T (ORJ-5/OTJ-5). Footprint and 3D body from
    Cliff's drawings: pin 1 at the port's right, one peg 3.90 mm in front of the
    pins and two 2.10 mm behind, the body's face on the board's edge. The
    housing is 11.5 mm wide, so J5..J9 and H2 moved about 1.1 mm right (by hand)
    and the board is 123.55 x 78.9 mm.
    - The user's moves, routed: R28 turned; R15, R10 and R14 in one row with C13
    and C14 moved; C83 (100 nF 100 V at the TVS behind F1, added to the sheet);
    the series resistors at the pin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
    [most_listener-B_Cu.gbl, most_listener-B_Mask.gbs, most_listener-Edge_Cuts.gm1, most_listener-F_Cu.gtl, most_listener-F_Mask.gts, most_listener-F_Paste.gtp, most_listener-F_Silkscreen.gto, most_listener-NPTH.drl]
2026-10-04 Recording tools: the host's console kept whole on a laptop, and decoded at home
    The per-car scales, other cars' wheel keys and the go-ahead for injection all come from a
    recording of a car's ring with "what was pressed when". The host already decodes every telegram
    onto its console, so only the laptop's half was missing (built on JLR-MOST-Reader's ring_log.py).
    - tools/console_log.py, on a laptop on M2's USB port: every byte of the console (921600 baud)
    in logs/<date>-<time>-<n>.log, the PC's time of each chunk in a .idx, marks and notes in a
    .marks.txt. The bridge is found by its USB ID (CP2102N, CH9102; the FPGA module's bridge
    ignored, two bridges refused). DTR and RTS are set off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
    [console_format.py, console_log.py, trace_decode.py]
2026-10-04 kit/: the board order, the two firmwares to flash, the laptop's recorder
    What the project hands over, without the rest of the repository, laid out as JLR-MOST-Reader's
    kit (READMEs in Ukrainian):
    - 1_boards: fab's files for JLCPCB, the BOM, the schematic and the assembly drawing; the order
    steps, the parts soldered by hand and where to buy them, what else is needed (the KL30 harness
    with its own fuse, a loop-in cable, a 2.4 GHz IPEX antenna for M2 - the VIE has none on board -,
    cables, M3), the modules' orientation (both USB ports to the top edge), J4's pins (the silk does
    not mark them), the checks before power and the first power-up.
    - 2_flash: how to write the FPGA's flash (Gowin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
    [most_listener-bom-jlcpcb.csv, most_listener-bom.csv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]
2026-10-04 kit/2_flash: the bitstream of a7607d8 and the host's firmware, version b80fb4c
    Taken by tools/make_kit.py --flash from builds of committed sources:
    - fpga/listener.fs: the gateware as of a7607d8, read from the flash at 25 MHz, UserCode
    0x0000FB78 (Gowin Programmer's Read User Code), timing clk_s 114.35 MHz (15.5 %) and clk_1024
    66.4 MHz (32.9 %).
    - esp32/bootloader.bin, partition-table.bin, listener_fw.bin: the firmware's sources as of 0ede8a7,
    built after b80fb4c (ESP-IDF v6.1, reconfigured so the image says "App version: b80fb4c" with no
    -dirty), written at 0x1000, 0x8000 and 0x10000.
    Each has a BUILD.txt with its commit and the sha256 of its files; check_all fails as soon as the
    g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
2026-10-07 Listener v2.0: the circuit of v1.6 on a compact board, 98 x 60 mm, four layers
    The layout decided on 2026-10-07: the inputs at one end (power J4, TOSLINK in J5, the ring's FOT
    J1), the outputs at the other (TOSLINK out J6, coax J7, line out J8/J9), M1 on top and M2
    underneath, In1 and In2 solid ground. v1.6 (listener_hw/) is not touched.
    - gen_listener2.py writes the sheet from listener_hw/gen_listener.py with v2.0's title, UUIDs and
    the Tang Nano's measured overhangs. tools/check_v2_circuit.py holds it to v1.6 part for part and
    net for net: 168/168 parts, 162/162 nets, PASS.
    - gen_listener2_pcb.py placed the parts once; the PCB editor owns the board from there. Routed,
    then patched lo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
    [most_listener_v2.kicad_pcb, most_listener_v2.kicad_sch]
2026-10-07 Listener v2.0: the JLCPCB package for three assemblies (min, mid, max)
    listener_hw2/make_fab2.py writes fab/ from the v2.0 board and sheet. It loads
    listener_hw/make_fab.py, so v1.6 and v2.0 keep one choice of LCSC parts, one table of JLCPCB's
    rotations, one silk check and the same date stamps. What differs:
    - Four copper layers (In1 and In2 are the ground planes); paste, silk and mask on both sides; the
    pick-and-place of both sides.
    - The bottom's rotations as JLCPCB counts them: 180 - KiCad's + the part's turn (KiBot's
    mirror_bottom, kicad-jlcpcb-tools). Checked against where pin 1 and the electrolytics' + sit on
    the board.
    - One JLCPCB BOM and CPL per assembly. Every connector is fi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
    [most_listener_v2-B_Cu.gbl, most_listener_v2-B_Mask.gbs, most_listener_v2-B_Paste.gbp, most_listener_v2-B_Silkscreen.gbo, most_listener_v2-Edge_Cuts.gm1, most_listener_v2-F_Cu.gtl, most_listener_v2-F_Mask.gts, most_listener_v2-F_Paste.gtp]
2026-10-11 J3: four streams - sink 4 (the chimes) and the parking sensors' own level
    mObridge's MOST25 DA Series Guide (pp. 18-19) gives JLR's amplifier sinks:
    1 the main source, 2 phone, navigation and voice, 3 the parking sensors,
    4 the chimes. J3 took the main sink and two more, so on JLR the chimes were
    lost and the parking sensors played at the navigation level. The reader got
    the same change in its cb7f6f2; its crosscheck_gains compiles this host and
    compares every gain word (9533 words equal, plus 3 x 300 random sequences).
    - sound.c: sink 3 takes 0xF0.0x409 byte 10 (a Status of 11 bytes or more,
    kept until a later one) before byte 8; sink 4 never takes the volume or
    byte 8 - its own Speake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
2026-10-11 kit/2_flash: the four-stream bitstream and host firmware (86f064e)
    Built in a clean worktree of 86f064e. The FPGA: clk_s 124.856 MHz against
    99 (26.1 %), clk_1024 68.944 MHz against 50 (37.9 %), TIMING PASS; UserCode
    0x0000FC3C, loading 25 MHz. The ESP32: version 86f064e, ESP-IDF v6.1, no
    warnings. Flash both: a 47-word host and this gateware, or the reverse,
    never commit a coefficient set, and J3 stays silent.
2026-10-11 Listener v2.0: the board after the edit rounds and two reviews of 2026-10-11
    The user moved parts in KiCad round by round, each with a sketch, and the copper was re-laid under
    every move. Then came two critical reviews, the silk and the fab package. v1.6 (listener_hw/) only
    gains one LCSC row in make_fab.py, which v2.0's package shares; v1.6's own package does not change
    (it has no 10R).
    - The user's moves: L2/D1/D2/F1/C83 and the bottom's C37/FB3/C30/R25/R20, U10's group, R6,
    R50/R51, R11/R12 by U7, U11's C25/R23/C26, the jacks J6..J9 grouped, and three M2.5 mounting
    holes (H1..H3).
    - Fewer vias where one side will do: the 5V_SW bus runs on the top, J2's six resistors went to the
    bott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
    [most_listener_v2-B_Cu.gbl, most_listener_v2-B_Mask.gbs, most_listener_v2-B_Paste.gbp, most_listener_v2-B_Silkscreen.gbo, most_listener_v2-Edge_Cuts.gm1, most_listener_v2-F_Cu.gtl, most_listener_v2-F_Mask.gts, most_listener_v2-F_Paste.gtp]
2026-10-11 Listener v2.0: the tube's end caps, from check_fit's model
    The listener goes in an aluminium tube 80 x 30 x 2 mm (76 x 26 inside), closed by two printed caps
    like the reader v2.0's (reader_hw2/gen_caps.py). Each has a flange on the tube's end, blocks in the
    side margins that hold the board's edges, and a saddle under the tube with an ear either side to
    screw it down. The user's decisions of 2026-10-11: this tube; the Bluetooth antenna outside, on an
    SMA in the input cap's 8 mm side margin; caps like the reader's.
    - listener_hw2/check_fit.py models the board in the tube from the PCB:
    - the parts' heights, each with its source;
    - the board's height in the tube;
    - each cap's openings and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
    [in_cap.step, in_cap.stl, out_cap.step, out_cap.stl]
2026-10-12 Listener v2.0: pictures for the README, as the reader's
    listener_hw2/make_views.py renders four views of v2.0 into views/: the board in its tube cut
    open, the closed tube from the input end and from the output end, and the board's underside.
    It works as the reader's (reader_hw2/make_views.py):
    - the caps come from gen_caps.py's own solids, moved into the board's 3D frame point by point;
    - the tube is an 80 x 30 x 2 prism as long as the board;
    - a copy of the board carrying them goes to work/, and kicad-cli renders it at basic quality
    only.
    Plain bodies stand in where KiCad 10 has none:
    - M1 and M2, whose footprints carry the headers only, from check_fit's numbers: M1's PCB, HDMI
    and US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
2026-10-12 check_all: v2.0's board, its package and its caps
    v2.0 (listener_hw2) now gets the checks v1.6 has:
    - the sheet regenerated by gen_listener2.py, held to v1.6's circuit by
    tools/check_v2_circuit.py, and ERC;
    - the board's DRC with parity to the sheet: no error, nothing unconnected, no difference;
    - check_fit.py (the board in the 80 x 30 x 2 tube) and gen_caps.py (the end caps), run with
    KiCad's python;
    - against the commit: the sheet and its libraries as the generator writes them, the package
    make_fab2.py writes for the three assemblies, and the caps.
    v1.6's steps keep their checks, now named v1.6. KICAD_PY overrides KiCad's python (by default
    the one beside kicad-cli). Each new step,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
2026-10-12 kit: v2.0 is the board the kit hands over
    kit/1_boards now orders v2.0 (listener_hw2) instead of v1.6.
    tools/make_kit.py:
    - copies v2.0's package: the Gerbers, the BOM and CPL of each assembly (min, mid, max), the
    full BOM, the schematic and the assembly drawings of both sides;
    - copies the tube's end caps from listener_hw2/caps: both caps as STL and STEP, and the
    drawing;
    - now also fails on a file in kit/ that is not a copy, a build or a file written by hand, so
    nothing left from an earlier kit can pass;
    - compares .svg and .step as text, line ends aside.
    v1.6's six copies left the kit; v1.6 and its package stay in listener_hw/.
    The READMEs, by hand:
    - 1_boards:
    - v2.0's board a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
    [in_cap.step, in_cap.stl, most_listener_v2-bom-jlcpcb-max.csv, most_listener_v2-bom-jlcpcb-mid.csv, most_listener_v2-bom-jlcpcb-min.csv, most_listener_v2-bom.csv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]
2026-10-12 README: v2.0 is the board to order, with its pictures
    - The opening shows v2.0 in its tube, cut open, as the reader's README does.
    - Parts:
    - listener_hw2 is board v2.0, the one to order: its sheet from v1.6's generator, its package
    for three assemblies, the tube and the caps, the pictures;
    - listener_hw is board v1.6, the first board and the circuit's source;
    - kit's 1_boards is v2.0's order.
    - A new section on v2.0, before v1.6's, covers:
    - where the inputs and outputs sit;
    - the sheet and the parts the review of 2026-10-11 added;
    - the PCB and the three assemblies;
    - the tube, with check_fit and gen_caps;
    - what the tube asks: the FPGA is flashed before M1 goes on, and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
2026-10-12 licences: CERN-OHL-S-2.0 for the hardware and gateware, GPL-3.0-or-later for the software
    The same licences as JLR-MOST-Reader, as LICENSE and COPYING.
    - CERN-OHL-S-2.0 covers listener_hw/ and listener_hw2/ (the designs, their generators, the
    fabrication files, the caps, the pictures), the gateware in listener_gw/rtl/ and
    listener_gw/board/, kit/1_boards/ and kit/2_flash/fpga/.
    - GPL-3.0-or-later covers listener_fw/, virtual_most_source/, tools/, listener_gw/sim/,
    kit/2_flash/esp32/, kit/3_laptop/, check_all.py and docs/.
    - The host's firmware links ESP-IDF's binary-only libraries (the Bluetooth controller among
    them) and esp_audio_codec, which is under the Espressif Modified MIT Lic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
2026-10-12 SOURCES.md: where the knowledge of MOST25, the cars' messages and the parts comes from
    The open projects and documents the project learned from, with what each gave. Nothing was
    copied; projects without a licence were only read. The MOST specifications are not in the
    repository and are cited by section.
    - The cars' messages: Rhys Morgan's JLR-HU, SocketMost and pymost-client, the mObridge guide,
    usb2most, the Dension Gateway 500S firmware (read for its amplifier sequence; findings only),
    BMW's, Audi's and Mercedes' documents and the aftermarket manuals of docs/vehicle_survey.md.
    - MOST25: the specifications and function catalogues, Grzemba's book, Oasis's patents on the
    preamble and th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
2026-10-12 sheets: block titles and notes in English, for v1.6 and v2.0
    The sheets' eleven block titles and their notes were Ukrainian. They are now English in
    gen_listener.py, and v2.0's block 12 in gen_listener2.py. Both sheets were generated anew, as
    were the schematic PDFs in both fab packages and the kit's copy of v2.0's.
    The notes keep their places. English runs wider in KiCad's font, so ten notes were reworded
    until each stood no wider than its Ukrainian original or than its frame. A few original
    notes already ran past their frames, and those stay as wide as they were.
    ERC passes on both sheets. tools/check_v2_circuit.py: 168/168 parts, 125/125 nets, PASS.
    Both fab packages differ only in thei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
    [most_listener.kicad_sch, most_listener_v2.kicad_sch]
2026-10-12 BUILD.md: the build guide in English
    The kit's four Ukrainian READMEs, merged into one English guide in the order a build goes:
    - the order, and the files of kit/1_boards, kit/2_flash and kit/3_laptop;
    - the board, its three assemblies, the order at JLCPCB, the hand-soldered parts and everything
    else, the tube and its caps;
    - flashing the FPGA (Windows: Gowin Programmer; macOS: openFPGALoader) and the ESP32 (esptool),
    and checking which build runs;
    - the assembly with the module headers' free pins pulled, the checks before power, the first
    power-up, the assembly into the tube, the car;
    - the laptop's recorder and decoder.
    Every number, part number, command and file name was checked ag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
2026-10-12 Si514 example: 514CBB000112BAG, sold singly and pre-orderable at JLCPCB
    The example code, 514CBA000110BAGR, now comes only on 1,000-piece reels at DigiKey and Mouser.
    514CBB000112BAG fits the same rule (3.3 V CMOS format C, package B, 3.2 x 5): DigiKey sells it
    singly, and JLCPCB can pre-order it (C1670489) instead of the builder consigning one (prices
    seen 2026-10-12). The rule itself is unchanged: format C, M or N, package B or C.
    The example is now 514CBB000112BAG in:
    - both fab READMEs (make_fab.py, make_fab2.py);
    - BUILD.md;
    - the kit's board README.
    Both fab packages differ only in their README.
2026-10-12 README for publication, as the reader's, and README.uk.md
    README.md:
    - The opening says what the listener does, its status (verified in models, never built
    nor tried in a car), that it is a research project, and that JLR-MOST-Reader is its
    offspring. The in-tube picture follows.
    - New sections before the technical ones:
    - Which cars: the external amplifier and plain PCM, both ring rates, which controls are
    known per make, the AUX that injection needs;
    - Is it safe for the car's ring?: the ring's path on 3V3_AON, the bypass and its watchdog,
    when the ring opens, injection off until allowed;
    - Status: what is proved and what is not;
    - Build one: the three assemblies and the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
2026-10-12 no local paths: KiCad's symbols from the environment, the OS8104 data sheet named only
    gen_listener.py read KiCad's own symbol libraries from a path with the author's Windows user name,
    so the generator failed on any other machine. It now takes KiCad's KICAD10_SYMBOL_DIR, or else
    the folder KiCad's Windows installer uses under %LOCALAPPDATA%. Both sheets generate unchanged.
    docs/host_control_formats.md pointed to the OS8104 data sheet in a local Downloads folder; it
    now says only that the data sheet is not in the spec mirror.
2026-10-12 docs: what the cross-check with JLR-MOST-Reader found in the listener's own documents
    The reader's README lists questions that hold for the listener too. The listener's documents
    stated some of them as settled, or left out conditions its own firmware README gives:
    - README's Unknown list now has the car's own messages, as the reader's has:
    - whether a stock head unit sends Connect at all (J3 and the phone take their channels from it);
    - which of 0x409 and SpeakerLevel the XF's amplifier gets, and 0x409's byte positions;
    - whether JLR mutes with 0x113 or 0x466;
    - whether the parking sensors and chimes travel the ring as audio.
    - The phone into the car needs the listener on the fibre i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
2026-10-12 J3 and injection: a list of 3 or 6 channels waits for an Info to name its format
    The reader's rule (its audit R09). Allocate and Connect give the channel list
    alone. 4 channels were taken as 16-bit stereo and 2 as 16-bit mono, the
    formats JLR is on record with, and 3 or 6 as 24 bit, which a list of 6 need
    not be: it could as well be three 16-bit channels. A Freelander 2 carries a
    6-byte surround stream (docs/vehicle_survey.md); if that is three 16-bit
    channels, J3 would have played it as noise, and the phone could have gone into
    it as 24-bit stereo. Now a list of 3 or 6 counts only once a SourceInfo or
    SinkInfo has named the format of those very channels. The name holds while
    the list does a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
    [amp_model.c, amp_model.h]
2026-10-12 docs: prices, project history and kitchen notes out of the public documents
    What a builder or a contributor does not need is gone from the READMEs, the
    build guide, the sources, docs/ and the kit:
    - the rough-cost tables (README, README.uk.md), dated stock levels (BUILD.md,
    the kit, the fab READMEs and their generators);
    - project history: the routing rounds of v1.1..v1.6, the timing-closure
    story, "as first written ..." and "before ..." asides, the board versions
    some facts were first made on, the most-bus origin and its shelved
    STM32 + ADAU1466 design;
    - dates and labels of reviews and audits, "the author's machine", "I", the
    memory and scratch references;
    - research leads, and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
2026-10-13 J3: the XF's 0x409 as JLR-HU reads it now; MixerLevel out
    JLR-HU (d6b46e2, AudioControl) reads the gateway's 0xF0.0x409 Status
    differently from the parser we took (0359e58):
    - byte 0 is the record's kind, and only kind 0, the whole record, carries the
    levels; kind 1 repeats the level being changed without saying whose;
    - byte 2 is the volume, 0..35;
    - bytes 7, 9, 10 and 11 are the phone's, the navigation's, the voice's and the
    parking sensors' levels, sent as the level + 5, 0..25;
    - a Set to 0x409 is the screen changing one channel, [channel, 0, level + 5].
    We read bytes 8 and 10 from any record, Sets included. So the parking sensors
    got the voice's level, and a Set from the screen moved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
2026-10-13 README: the rough cost back, as the reader has it again
    The table removed in 1190904 is back in README.md and README.uk.md, with
    J1 at 22-27 USD (eBay about 22 on 2026-10-12, AliExpress about 27 on
    2026-10-13) and a fuse and wire for the 12 V tap in J4's row. The first
    listener comes to roughly 340-435 USD for min, 365-460 for mid and 415-515
    for max; a second one from the same order about 140-205.
